skysedge/RUST_Hardware/Bak/091822_Rev1.0_FirstProduction/Mainboard/PanelDesign/RUSPMB_PanelReference.png

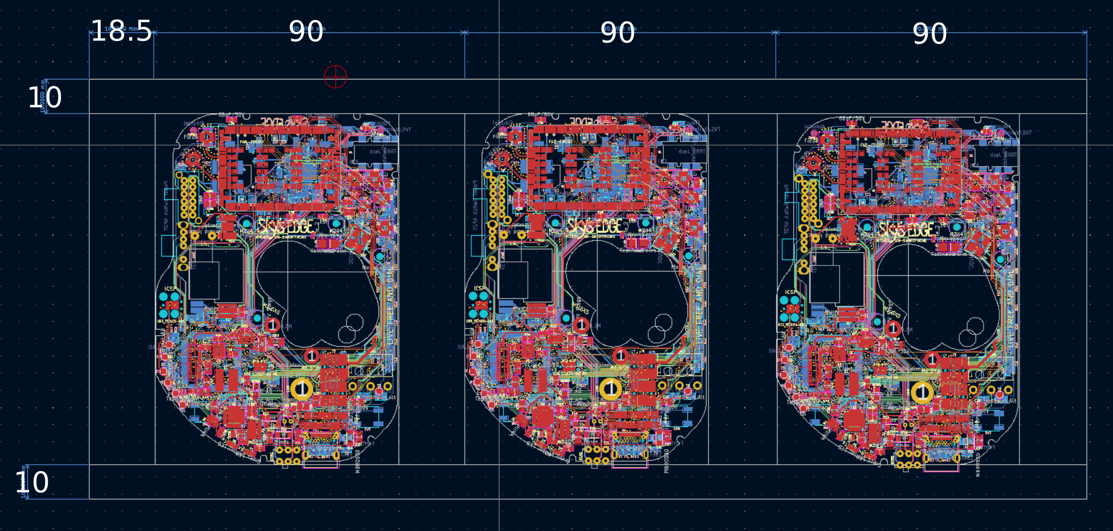
Bak/091822_Rev1.0_FirstProduction/Mainboard/PanelDesign/RUSPMB_PanelReference.png
