skysedge/RUST_Hardware/Bak/091822_Rev1.0_FirstProduction/Mainboard/PanelDesign/Screenshot_2022-08-23_14-57-20.png

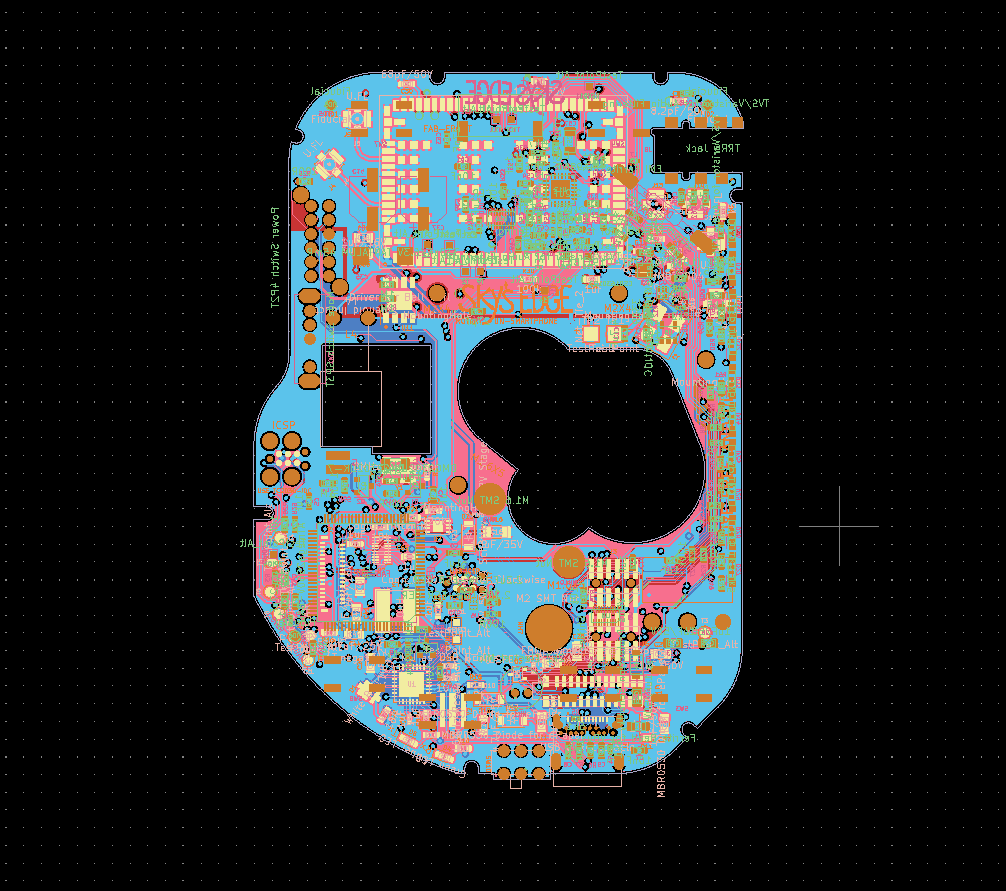
Bak/091822_Rev1.0_FirstProduction/Mainboard/PanelDesign/Screenshot_2022-08-23_14-57-20.png
