skysedge/RUST_Hardware/Bak/081922/BOM_RUSP_Mainboard.ods

Qty | Stock | Description | Ref Des | Manufacturer | Part No. | Cost Each | Cost per ASM | Footprint
5 | 4k | 27pF | C1, C46, C47, C62, C63, |  |  | 0.00886 | 0.0443 | Capacitor_SMD:C_0603_1608Metric
14 | 12k | .1uF | C2, C3, C4, C5, C6, C10, C11, C18, C19, C34, C39, C42, C56, C67 |  |  | 0.00531 | 0.07434 | Capacitor_SMD:C_0603_1608Metric
7 | 10k | 10nF | C7, C48, C49, C60, C61, C68, C69, |  |  | 0.00531 | 0.03717 | Capacitor_SMD:C_0402_1005Metric
2 | 4k | 47pF | C8, C9, |  |  | 0.00802 | 0.01604 | Capacitor_SMD:C_0603_1608Metric
2 | 4k | 4.7uF | C12, C13, |  |  | 0.00989 | 0.01978 | Capacitor_SMD:C_0603_1608Metric
2 | 900 | 100uF, 10V | C14, C37, | Wurth | 865080243007 | 0.16 | 0.32 | MyFootprints:Capacitor_Wurth865080243007
2 | 4k | 2.2uF, LOW-ESR CER. | C15, C50, C54, C72, |  |  | 0.01192 | 0.02384 | Capacitor_SMD:C_0603_1608Metric
3 | 2k | 10uF/35V | C16, C17, C57, |  |  | 0.093 | 0.279 | Resistor_SMD:R_1206_3216Metric
5 | 4k | 4.7uF/25V | C20, C21, C22, C41, C44, |  |  | 0.05128 | 0.2564 | Capacitor_SMD:C_0805_2012Metric
7 | 4k | 1uF/50V | C23, C24, C25, C26, C27, C28, C29, |  |  | 0.03904 | 0.27328 | Capacitor_SMD:C_0805_2012Metric
1 |  | 68pF/50V | C30, |  |  | 0.023 | 0.023 | Capacitor_SMD:C_0402_1005Metric
1 | 4k | 15pF/50V | C31, |  |  | 0.00992 | 0.00992 | Capacitor_SMD:C_0603_1608Metric
1 | 10k | 8.2pF/50V | C32, |  |  | 0.005 | 0.005 | Capacitor_SMD:C_0402_1005Metric
1 | 4k | 10nF/16V | C33, |  |  | 0.00734 | 0.00734 | Capacitor_SMD:C_0603_1608Metric
1 | 249 | 330uF/6.3V, TANTALUM 45mR | C35, | Kemet | T520D337M006ATE045 | 0.933 | 0.933 | MyFootprints:C_2917
3 | 2k | 1uF/16V | C36, C38, C40, |  |  | 0.014 | 0.042 | Capacitor_SMD:C_0805_2012Metric
9 | 10k | 1uF | C43, C45, C51, C52, C53, C55, C58, C59, C66, |  |  | 0.01 | 0.09 | Capacitor_SMD:C_0402_1005Metric
1 | 990 | White Bell LED | D1, | Osram | KW DSLP31.CC-GXHX-4J8K-Z444-60-R18 | 0.18 | 0.18 | MyFootprints:Osram_1212
2 | 999 | Amber LED | D2, D5, | Inolux | IN-S63AT5Y | 0.057 | 0.114 | LED_SMD:LED_0603_1608Metric_Castellated
1 | 5128 from Rochester | VBus Protection Schottky | D3, | ON Semiconductor | MBR130T3G | 0.05 | 0.05 | Diode_SMD:D_SOD-123
1 | 1000 | Green LED | D4, | OSRAM | LT Q39G-Q1OO-25-1 | 0.109 | 0.109 | LED_SMD:LED_0603_1608Metric_Castellated
3 | 4800 | MBR0530 Diode for ePaper | D10, D11, D12, | ON Semi | MBR0530 | 0.08 | 0.24 | Diode_SMD:D_SOD-123
4 | 1000 | TVS/Varistor for Audio Filtering | D15, D16, D17, D18, | AVX | USB0001DP | 0.218 | 0.872 | Resistor_SMD:R_0603_1608Metric
1 | 1000 | Status LED | D22, | Rohm | SMLE13EC8TT86 | 0.251 | 0.251 | LED_SMD:LED_0603_1608Metric_Castellated
1 | 999 | 20V, 500mA Schottky for 12V Stage | D23, | Nexperia | PMEG2005EGWJ | 0.066 | 0.066 | Diode_SMD:D_SOD-123
10 | 10000 | Red/Yellow Bar Meter LED | D25, D26, D27, D28, D29, D30, D31, D32, D33, D34, | Dialight | 5988560207F | 0.145 | 1.45 | MyFootprints:LED_Dialight_5988560207F
1 | 500 | USB C Receptacle | J1, | CUI | UJ31-CH-G1-SMT-TR | 1.577 | 1.577 | MyFootprints:USBC_CUI_UJ31-CH-G1-SMT-TR
1 | 1000 | Poke-In Battery Connector | J2, | AVX | 9296002202906 | 0.28 | 0.28 | MyFootprints:AVX_PokeInConnector
2 | 600 | 12p Male Samtec Connector | J3, J6, | Samtec | FTSH-106-01-L-DV | 1.442 | 2.884 | MyFootprints:Samtec_2x6Header_FTSH-106-01-L-DV
6 | 4500 | U.FL | J4, J5, J13, J14, J15, J16, | Molex | 734120110 | 0.338 | 2.028 | Connector_Coaxial:U.FL_Molex_MCRF_73412-0110_Vertical
1 | 600 | TRRS Jack | J8, | CUI | SJ-43617-SMT-TR | 1.105 | 1.105 | MyFootprints:AudioJack_TRRS_CUI_SJ-43617-SMT-TR
1 | 400 | FPC Connector for OLED | J9, | Crystalfontz | CS030Z31G-A0 | 0.59 | 0.59 | MyFootprints:Hirose_FPC_FH26W-31S-0.3SHW(60)
1 | 500 | FPC Connector for ePaper | J10, | Molex | 525592452 | 2.045 | 2.045 | MyFootprints:Molex_24pFPC_Vert_0525592452
2 | 0 | SMD Pin Socket for Filament | J11, J12, | Samtec | SMM-102-02-S-S | 0 | 0 | MyFootprints:2pSocket_SMD_Samtec_SMM-102-02-S-S
1 | 800 | Socket Header for Ringer Coil | J18, | GCT | BG302-03-A-L-G | 0.292 | 0.292 | MyFootprints:3pSocket_RA_GCT_BG302-03-A-L-G
1 | 4000 | Ferrite Bead for VBus | L1, | Laird | MI0805K601R-10 | 0.055 | 0.055 | Resistor_SMD:R_0805_2012Metric_Pad1.15x1.40mm_HandSolder
1 | 180 | 4.7uH | L2, | Wurth | 74438336047 | 1.275 | 1.275 | MyFootprints:Inductor_Wurth_74438336100
1 | 800 | 10uH | L3, | Wurth | 744053100 | 1.258 | 1.258 | MyFootprints:Inductor10uH_Wurth_744053100
4 | 4000 | EMI Ferrite | L5, L6, L7, L8, | Murata | BLM15HD182SN1D | 0.046 | 0.184 | Inductor_SMD:L_0402_1005Metric
1 | 3000 | M2 SMT Nut | MH7, | PEM | SMTSO-M2-3ET | 0.51 | 0.51 | MyFootprints:SMTSO-M2-3ET
2 | 3257 | M1.6 SMT Nut | MH9, MH10, | PEM | SMTSO-M1.6-1ET | 0.46 | 0.92 | MyFootprints:SMTSO-M1.6-1ET
1 | 500 | 2k2 Electret Mic | MK1, | PUI Audio | POM-2738P-R | 1.22 | 1.22 | MyFootprints:Microphone_PUI_POM-2738P-R
2 | 2000 | DMG2302UK-7 | Q1, Q2, | Diodes Incorporated | DMG2302UK-7 | 0.13 | 0.26 | Package_TO_SOT_SMD:SOT-23
2 | 2000 | CSD16301Q2 | Q3, Q4, | TI | CSD16301Q2 | 0.35 | 0.7 | digikey-footprints:TI_CSD16301Q2
1 | 3000 from Newark, due 7/22 | N-MOSFET, 30V, 1.4A | Q5, | Vishay | SI1308EDL-T1-GE3 | 0.149 | 0.149 | Package_TO_SOT_SMD:SOT-323_SC-70
2 | 750 | MMBT3904 | Q6, Q7, | Fairchild | MMBT3904 | 0.07 | 0.14 | Package_TO_SOT_SMD:SOT-23
7 | 10k | 10k | R1, R18, R29, R33, R39, R75, R76, |  |  | 0.00312 | 0.02184 | Resistor_SMD:R_0603_1608Metric
6 | 10k | 1M | R2, R23, R24, R34, R41, R73, |  |  | 0.00312 | 0.01872 | Resistor_SMD:R_0603_1608Metric
3 | 5k | 27R | R3, R6, R7, |  |  | 0.00312 | 0.00936 | Resistor_SMD:R_0603_1608Metric
2 | 10k | 5k1 | R4, R5, | Yageo | RC0402FR-075K1L | 0.00186 | 0.00372 | Resistor_SMD:R_0402_1005Metric
7 | 10k | 1k | R8, R9, R10, R11, R74, R77, R78, |  |  | 0.003 | 0.021 | Resistor_SMD:R_0603_1608Metric
1 | 5k | 330R | R12, |  |  | 0.003 | 0.003 | Resistor_SMD:R_0603_1608Metric
4 | 10k | 2k2 | R13, R14, R35, R38, | Panasonic | ERJ-2GEJ222X | 0.00152 | 0.00608 | Resistor_SMD:R_0402_1005Metric
1 | 5k | 10R | R15, | Panasonic | ERJ-3GEYJ100V | 0.002 | 0.002 | Resistor_SMD:R_0603_1608Metric
1 | 5k | 510k | R16, |  |  | 0.003 | 0.003 | Resistor_SMD:R_0603_1608Metric
21 | 25k | 1k5 | R17, R45, R46, R47, R48, R49, R50, R51, R52, R53, R54, R55, R56, R57, R58, R59, R60, R61, R62, R63, R64, |  |  | 0.002 | 0.042 | Resistor_SMD:R_0603_1608Metric
4 | 5k | 100R | R19, R20, R40, R65, |  |  | 0.004 | 0.016 | Resistor_SMD:R_0603_1608Metric
1 | 5k | 1.05M | R21, |  |  | 0.0028 | 0.0028 | Resistor_SMD:R_0603_1608Metric
1 | 5k | 120k | R22, |  |  | 0.002 | 0.002 | Resistor_SMD:R_0603_1608Metric
5 | 10k | 270R | R25, R42, R66, R68, R70, |  |  | 0.002 | 0.01 | Resistor_SMD:R_0603_1608Metric
3 | 5k | 100k | R26, R27, R30, |  |  | 0.00312 | 0.00936 | Resistor_SMD:R_0603_1608Metric
5 | 10k | 820R | R28, R43, R67, R69, R71, |  |  | 0.00312 | 0.0156 | Resistor_SMD:R_0603_1608Metric
1 | 4k | 16k | R31, |  |  | 0.003 | 0.003 | Resistor_SMD:R_0603_1608Metric
1 | 5k | 0.47R | R32, | Panasonic | ERJ-2BQJR47X | 0.024 | 0.024 | Resistor_SMD:R_0402_1005Metric
2 | 5k | 4k7 | R36, R37, |  |  | 0.00312 | 0.00624 | Resistor_SMD:R_0603_1608Metric
1 | 5k M | 160R* | R44, |  |  | 0.003 | 0.003 | Resistor_SMD:R_0603_1608Metric
1 | 4k | 18R | R79, | TE | CRGCQ0603F18R | 0.003 | 0.003 | Resistor_SMD:R_0603_1608Metric
1 | 1050 | Mode Switch, SP3T | SW1, | C&K | OS103011MA7QP1 | 0.37 | 0.37 | MyFootprints:SP3T_OS103011MA7QP1
1 | 442 | Roller Switch for Rotary Dial | SW2, | Omron | D2F-01FL2-A1 | 1.531 | 1.531 | MyFootprints:LimitSwitch_D2F-01FL2-A1
6 | 1000 (+2k on order from DigiKey) | Tactile Switch | SW3, SW4, SW5, SW6, SW7, SW8, | Panasonic | EVQ-Q2Y03W | 0.169 | 1.014 | MyFootprints:TactileSwitch_Panasonic_EVQ-Q2Y03W
1 | 800 | Power Switch, 4P2T | SW9, | E-Switch | EG4208 | 0.75 | 0.75 | MyFootprints:Switch_4PDT_ESwitch-EG4208
1 | 1300 | Mic Switch, DPDT | SW10, | Nidec Copal | CL-SB-22C-11 | 0.818 | 0.818 | MyFootprints:Switch_DPDT_Nidec_CL-SB-22C-XX
1 | 200 | ATmega16U2-MU as USB Bridge | U1, | Atmega | ATmega16U2-MU | 2.634 | 2.634 | Package_DFN_QFN:QFN-32-1EP_5x5mm_P0.5mm_EP3.65x3.65mm
1 | 499 | LiPo Undervolt Protection IC | U3, | TI | BQ29703DSET | 0.57 | 0.57 | Package_SON:WSON-6_1.5x1.5mm_P0.5mm
1 | 96 + 200 Atmega1280V, + 300 ATmega1280V on order from Rochester | ATmega2560V-8AU | U4, | Microchip Technology | ATMEGA2560V-8AUR | 11 | 11 | MyFootprints:ATmega2560_TQFP-100_14x14mm_P0.5mm
1 | ?+230 | Charge Mgmt. IC | U5, | Microchip | MCP73831T-2ACI/OT | 0.63 | 0.63 | Package_TO_SOT_SMD:SOT-23-5
1 | 2049 | 3.3V Linear Regulator | U6, | Microchip | MIC5528-3.3YMT-TR | 0.18 | 0.18 | MyFootprints:LDO_MIC5528
1 | 1500 | 12V Boost Converter | U7, | Microchip | MCP1661T-E/MNY | 0.89 | 0.89 | MyFootprints:BoostConverter_MCP1661
2 | 1000 | Logic Shifter | U8, U10, | TI | TXB0108DQSR | 1.6 | 3.2 | MyFootprints:TXB0108_USON-20_2x4mm_P0.4mm
1 | 200 of R202 | TOBY-R2 | U9, | u-blox | TOBY-R200 | 57.5 | 57.5 | MyFootprints:CellModule_TOBY-L2
1 | 1000 | Driver for Bell Coil | U11, | Diodes Inc. | ZXBM5210-SP-13 | 0 | 0 | MyFootprints:SO-8EP
1 | 2000 | MAX9860 CODEC | U12, | Maxim | MAX9860ETG+ | 1.62 | 1.62 | Package_DFN_QFN:WQFN-24-1EP_4x4mm_P0.5mm_EP2.7x2.7mm
1 | 1000 | 8MHz Resonator | Y1, | Abracon | AWSCR-8.00CV-T | 0.22 | 0.22 | MyFootprints:AWSCR-16.00CV-T
1 | 1000 | 16MHz Resonator | Y2, |  | AWSCR-16.00CV-T | 0.189 | 0.189 | MyFootprints:AWSCR-16.00CV-T
 |  |  |  |  |  | TOTAL: | 106.55583
