skysedge/RUST_Hardware/Bak/Nov10_2022/Antenna/BOM_RUSP_Antenna.ods

Qty | Stock | Description | Ref Des | Manufacturer | Part No. | Cost Each | Cost per ASM | Footprint
1 | 1070 | Antenna | AE1, | Ignion | NN02-224 (RUN mXtend) | 2.49135 | 2.49135 | MyFootprints:Antenna_Ignion_RunmXtend_NN02-224
1 |  | 0.7pF | C1, | Murata |  | 0 | 0 | Capacitor_SMD:C_0603_1608Metric
1 | 0 | 0.6pF | C2, | Murata |  | 0 | 0 | Capacitor_SMD:C_0603_1608Metric
1 | 0 | 1.5pF | C3, | Murata |  | 0 | 0 | Capacitor_SMD:C_0603_1608Metric
1 | 0 | u.FL | J1, | Molex | 734120110 | 0 | 0 | Connector_Coaxial:U.FL_Molex_MCRF_73412-0110_Vertical
1 | 0 | 19nH | L1, | Murata |  | 0 | 0 | Inductor_SMD:L_0603_1608Metric
1 | 0 | 4nH | L2, | Murata |  | 0 | 0 | Inductor_SMD:L_0402_1005Metric
1 | 0 | 12nH | L3, | Murata |  | 0 | 0 | Inductor_SMD:L_0603_1608Metric
1 | 0 | 4.5nH | L4, | Murata | LQW15AN4N0C10D | 0 | 0 | Inductor_SMD:L_0402_1005Metric
 |  |  |  |  |  | TOTAL: | 2.49135
