skysedge/RUST_Hardware/Bak/091822_Rev1.0_FirstProduction/Faceplate/RUSP_Faceplate.csv

Qty | Stock | Description | Ref Des | Manufacturer | Part No. | Cost Each | Cost per ASM | Footprint
4 | 0 | M2 SMT Nut | H1, H2, H3, H5, | PEM | SMTSO-M2-3ET | 0 | =A2*G2 | MyFootprints:SMTSO-M2-3ET
 |  |  |  |  |  | TOTAL: | =SUM(H3:H2)
