skysedge/RUST_Hardware/Daughterboard/ManufacturerNotes/1000001908.jpg

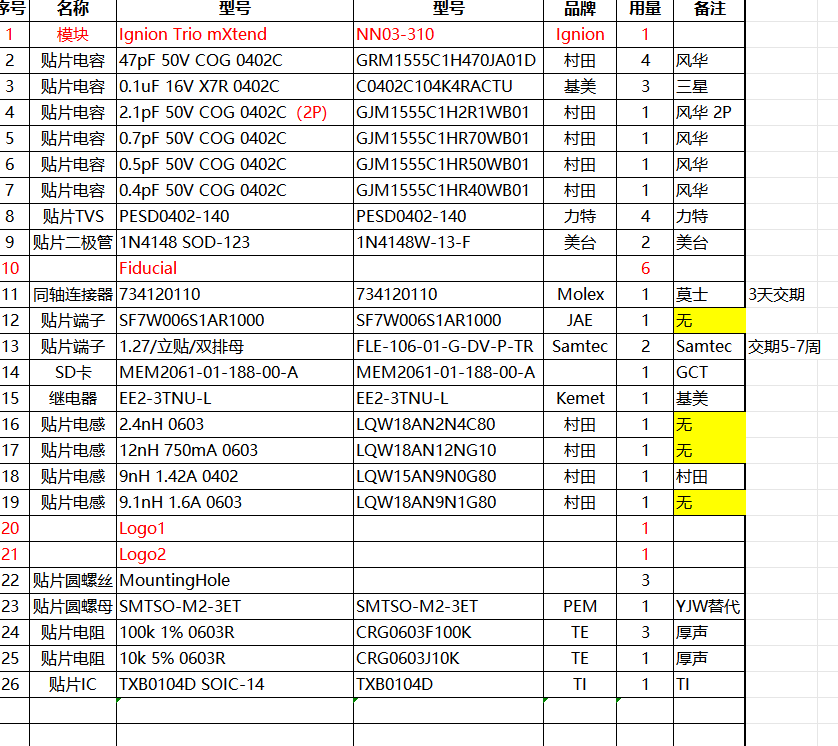
Daughterboard/ManufacturerNotes/1000001908.jpg
