skysedge/RUST_Hardware/(threads)

Thread 4 (2025-03-14):

Phase 2: Find new TP locations

jhaupt, 2025-03-14:
For phase 2, move the test points so that the phone can be tested on the PQC fixture even after fully assembled. Potentially, even with the casing on if the test points are accessible under a hatch?
