skysedge/RUST_Hardware/Bak/Nov10_2022/Mainboard/Fab/RUSP_Mainboard-AUDIO.pdf

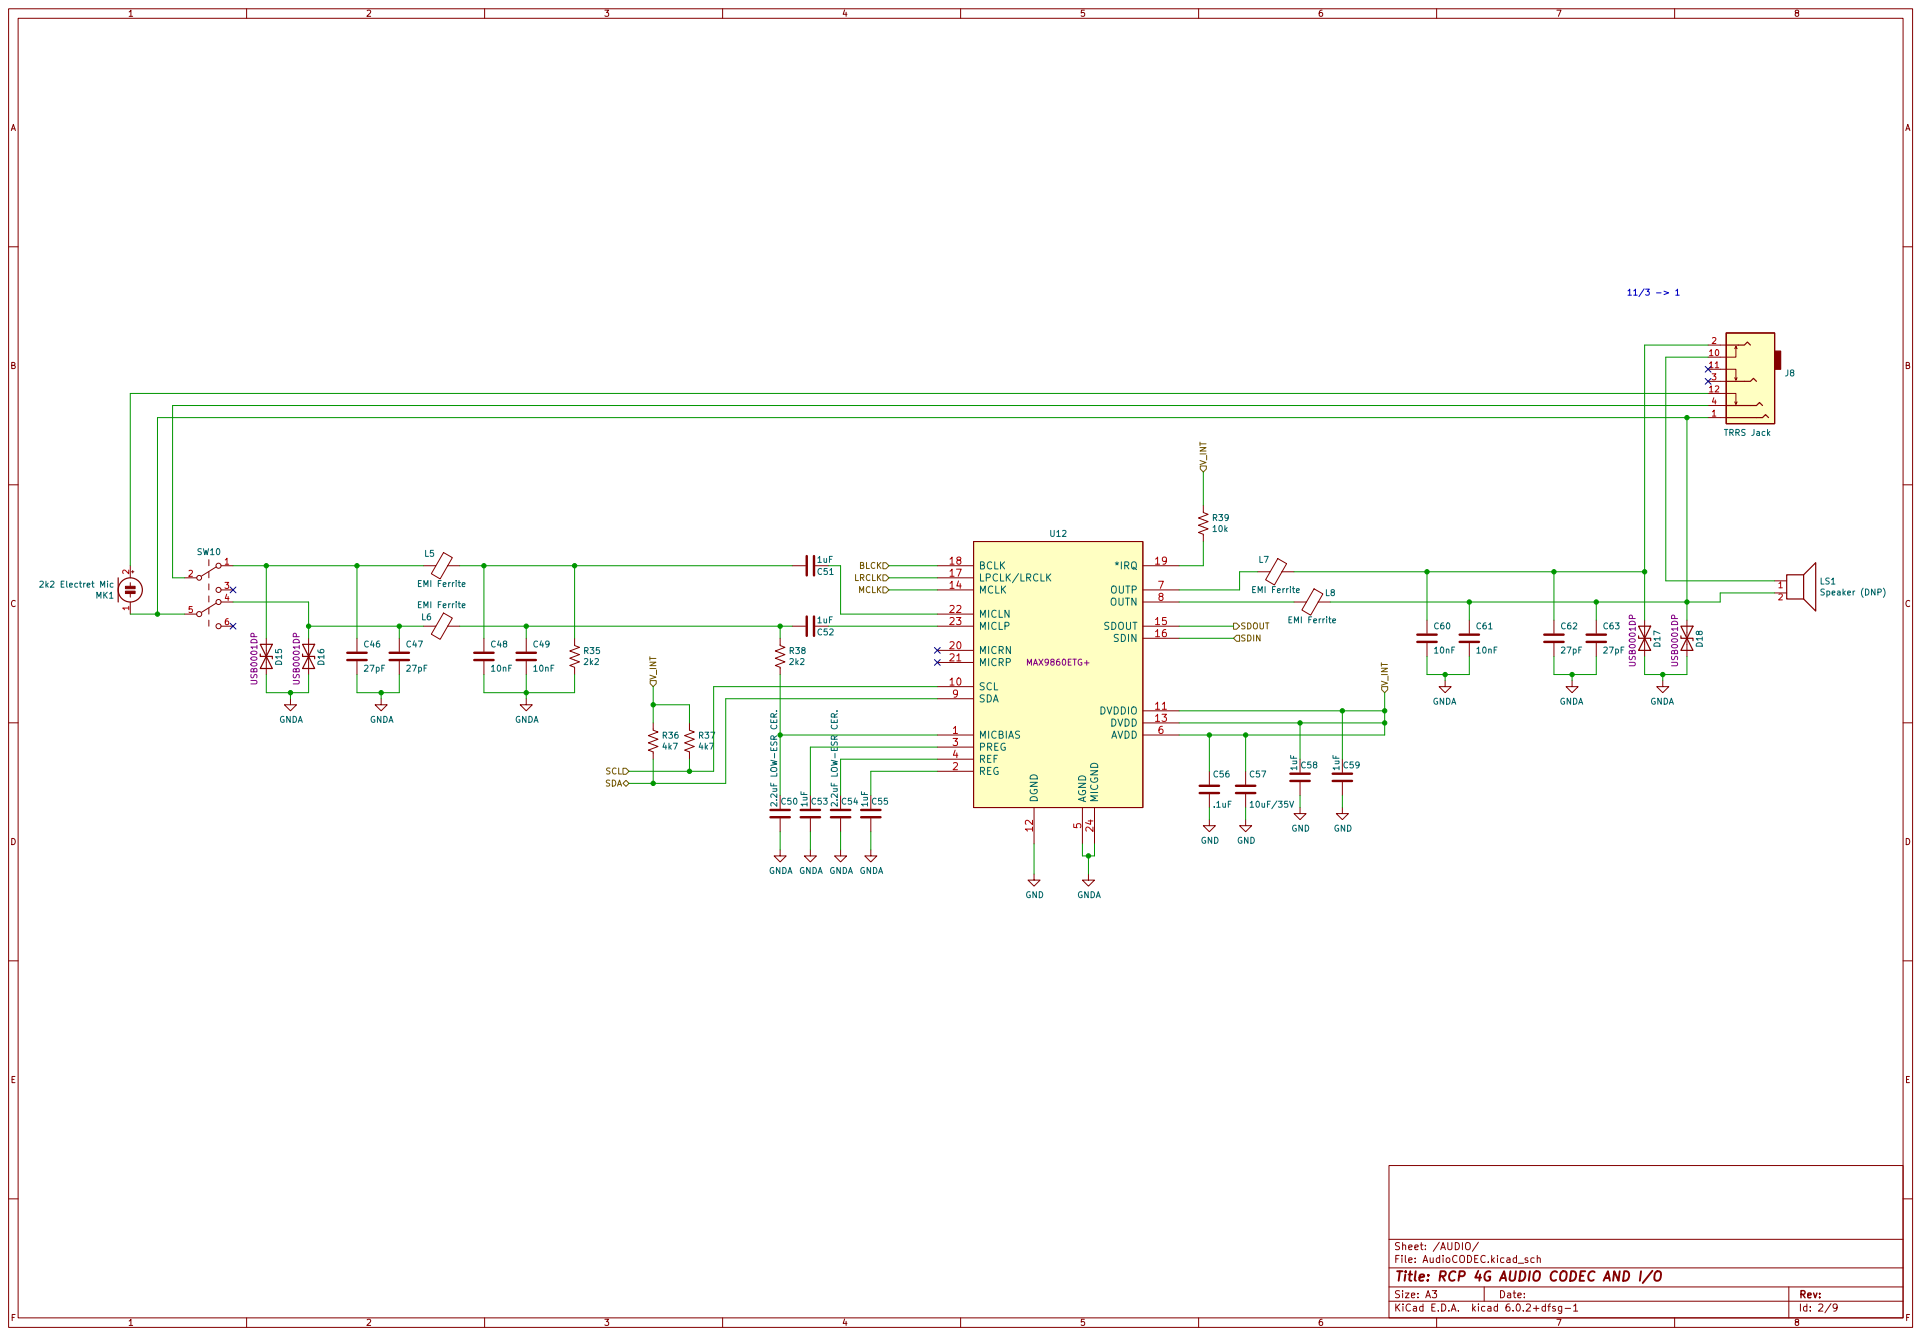
[picture p4: page 1]

5 AVDD 6 OUTP 7 OUTN 8 SDA 9 U12 MAX9860ETG+

File: AudioCODEC.kicad_sch Sheet: /AUDIO/ D16 USB0001DP

Id: 2/9 Title: RCP 4G AUDIO CODEC AND I/O
