skysedge/RUST_Hardware/Daughterboard/RUST_Daughterboard.kicad_pcb

## KiCad design Daughterboard/RUST_Daughterboard.kicad_pcb (2025-03-16)

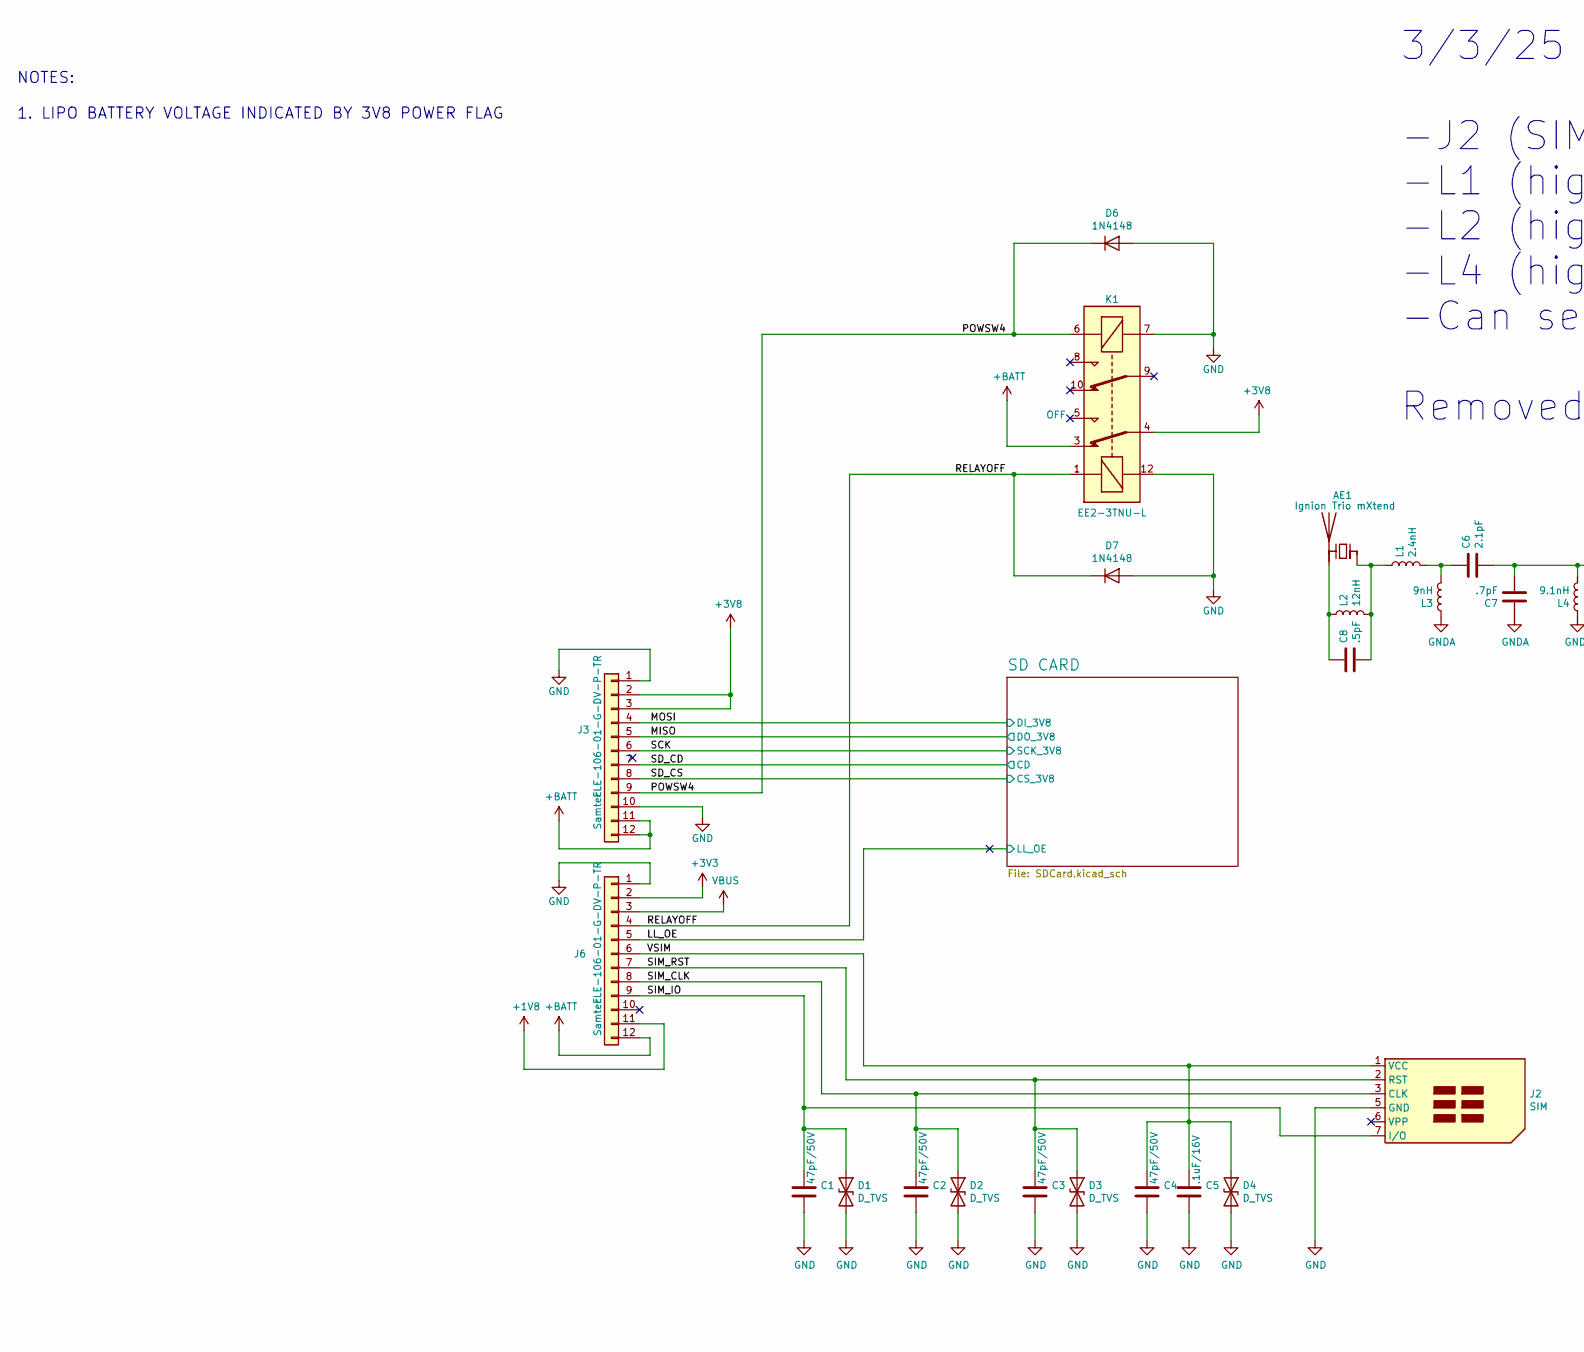
[picture p15: schematic RUST_Daughterboard.kicad_sch, 4G ROTARY CELLPHONE DAUGHTERBOARD, part in row 1, column 1]

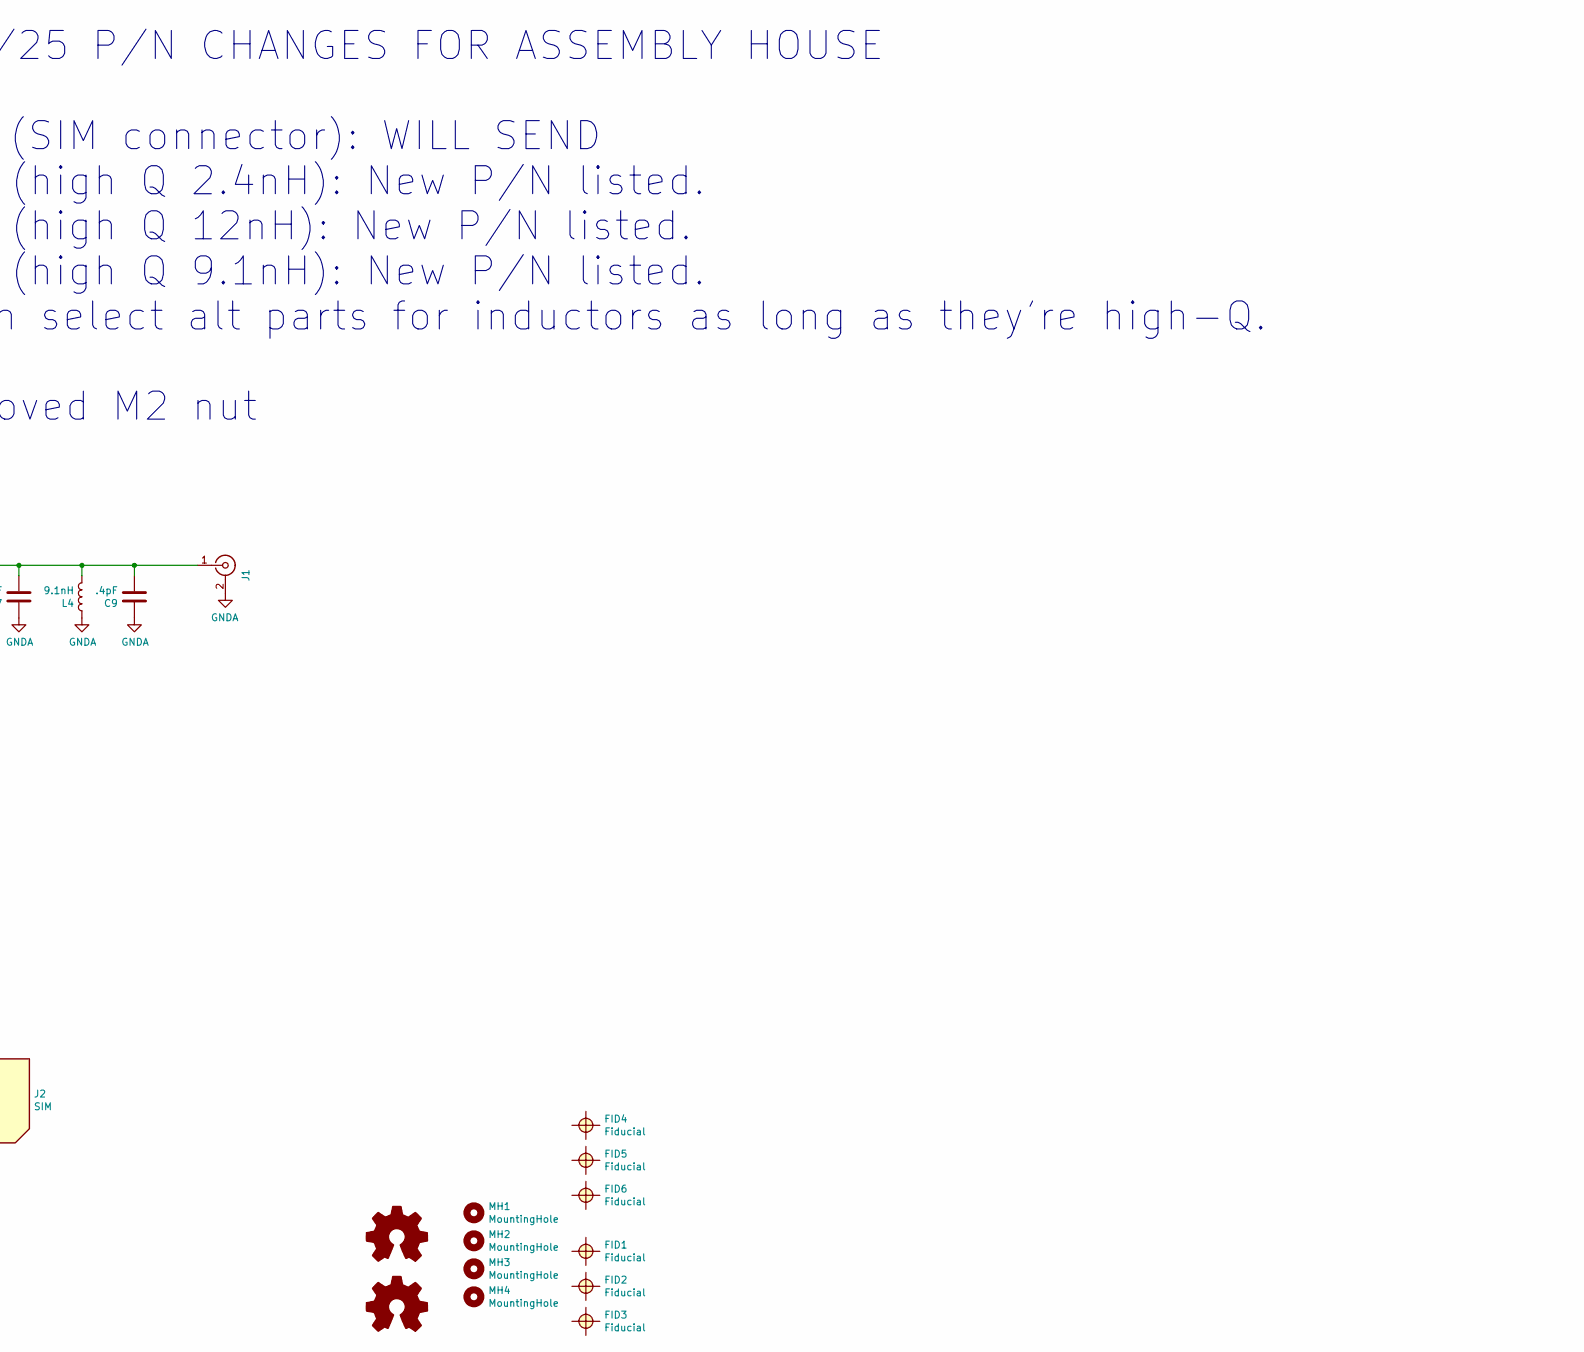
[picture p16: schematic RUST_Daughterboard.kicad_sch, 4G ROTARY CELLPHONE DAUGHTERBOARD, part in row 1, column 2]

Parts:
AE1: Ignion Trio mXtend; Antenna_Ignion_TriomXtend_NN03-310; Mfg. Part No. NN03-310
C1, C2, C3, C4: 47pF/50V; C_0603_1608Metric; Mfg. Part No. GRM1555C1H470JA01D
C5: .1uF/16V; C_0603_1608Metric; Mfg. Part No. C0402C104K4RACTU
C6: 2.1pF; C_0402_1005Metric; Mfg. Part No. GJM1555C1H2R1BB01D
C7: .7pF; C_0402_1005Metric; Mfg. Part No. GJM1555C1HR70BB01D
C8: .5pF; C_0402_1005Metric; Mfg. Part No. 0402N8R2D500CT
C9: .4pF; C_0402_1005Metric; Mfg. Part No. GJM1555C1HR40WB01D
D1, D2, D3, D4: D_TVS; D_0603_1608Metric; Mfg. Part No. PESD0402-140
D6, D7: 1N4148; D_SOD-123; Mfg. Part No. 1N4148W-13-F
FID1, FID2, FID3, FID4, FID5, FID6: Fiducial; Fiducial_0.75mm_Dia_1.5mm_Outer
J1: Conn_Coaxial; U.FL_Molex_MCRF_73412-0110_Vertical; Mfg. Part No. 0734120110
J2: SIM; SIMHolder_Amph7111S2015X02LF; Mfg. Part No. SF7W006S1AR1000
J3, J6: Conn_01x12; Samtec_2x6HeaderSocket_FLE-106-01-G-DV; Mfg. Part No. FLE-106-01-G-DV-P-TR
K1: EE2-3TNU-L; Relay_Kemet_EE2-3TNU; Mfg. Part No. EE2-3TNU
L1: 2.4nH; L_0603_1608Metric; Mfg. Part No. 2-2176075-4
L2: 12nH; L_0603_1608Metric; Mfg. Part No. LQW18AN12NG00D
L3: 9nH; L_0402_1005Metric; Mfg. Part No. LQW15AN9N0G80
L4: 9.1nH; L_0603_1608Metric; Mfg. Part No. LQW18AN9N1C00D
LOGO1: Logo1; SkysEdge_18mm
LOGO2: Logo2; SkysEdge_18mm
MH1, MH2, MH3, MH4: MountingHole; MountingHole_2.2mm_M2

Connections:
+1V8: J6.11
+3V3: J6.2; also elsewhere on the board
+3V8: J3.2, J3.3, K1.4; also elsewhere on the board
+BATT: J3.11, J3.12, J6.12, K1.3
/LL_OE: J6.5; also elsewhere on the board
/MISO: J3.5; also elsewhere on the board
/MOSI: J3.4; also elsewhere on the board
/POWSW4: D6.1 (K), J3.9, K1.6
/RELAYOFF: D7.1 (K), J6.4, K1.1
/SCK: J3.6; also elsewhere on the board
/SD_CD: J3.7; also elsewhere on the board
/SD_CS: J3.8; also elsewhere on the board
/SIM_CLK: C2.1, D2.1 (A1), J2.3 (CLK), J6.8
/SIM_IO: C1.1, D1.1 (A1), J2.7 (I/O), J6.9
/SIM_RST: C3.1, D3.1 (A1), J2.2 (RST), J6.7
/VSIM: C4.1, C5.1, D4.1 (A1), J2.1 (VCC), J6.6
GND: C1.2, C2.2, C3.2, C4.2, C5.2, D1.2 (A2), D2.2 (A2), D3.2 (A2), D4.2 (A2), D6.2 (A), D7.2 (A), J2.5 (GND), J3.1, J3.10, J6.1, K1.7, K1.12; also elsewhere on the board
GNDA: C7.1, C9.1, J1.2 (Ext), L3.1, L4.1
unnamed: AE1.1 (FEED), C8.2, L1.1, L2.2
unnamed: AE1.2 (PCB_Trace), C8.1, L2.1
unnamed: C6.1, L1.2, L3.2
unnamed: C6.2, C7.2, C9.2, J1.1 (In), L4.2
VBUS: J6.3

Notes on the sheet:
3/3/25 P/N CHANGES FOR ASSEMBLY HOUSE -J2 (SIM connector): WILL SEND -L1 (high Q 2.4nH): New P/N listed. -L2 (high Q 12nH): New P/N listed. -L4 (high Q 9.1nH): New P/N listed. -Can select alt parts for inductors as long as they're high-Q. Removed M2 nut
NOTES: 1. LIPO BATTERY VOLTAGE INDICATED BY 3V8 POWER FLAG

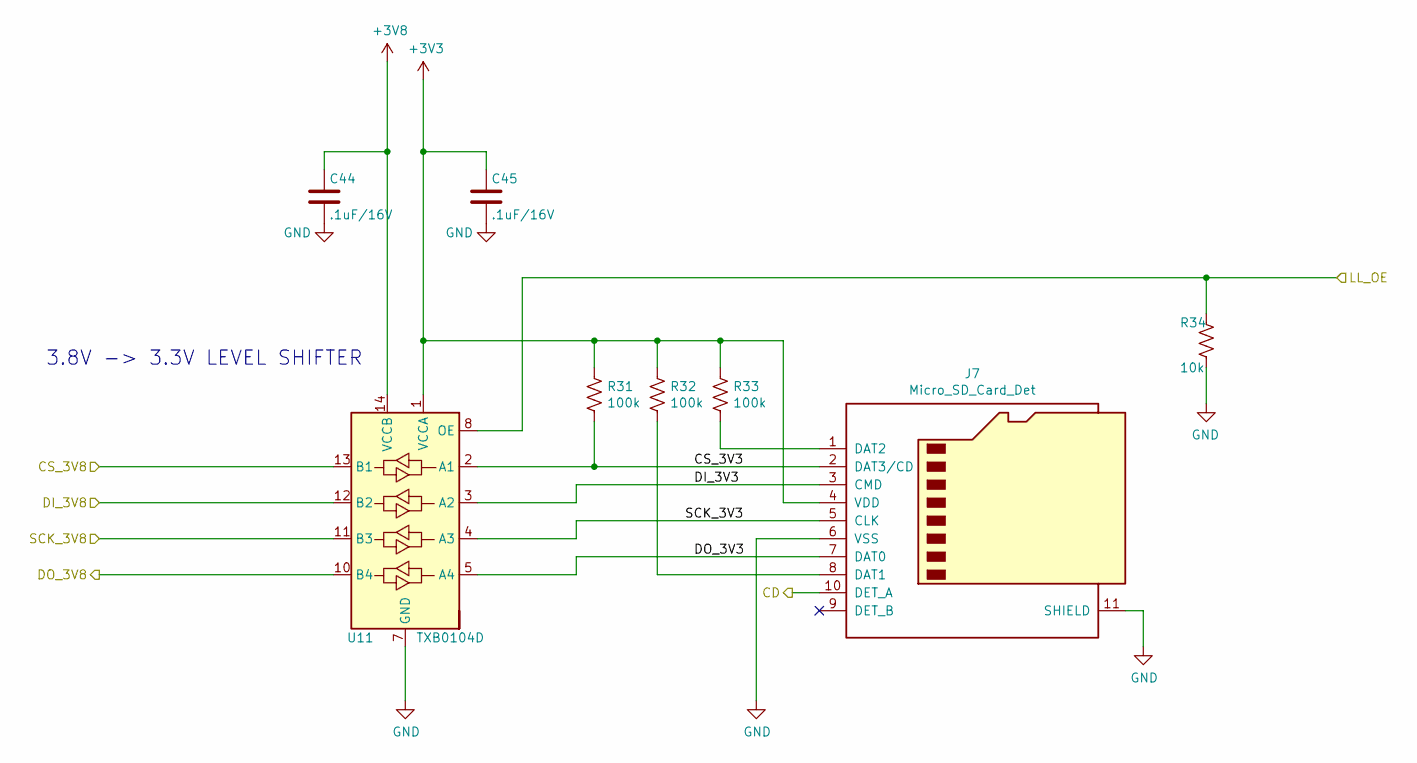
[picture p17: schematic SDCard.kicad_sch, RCP SD CARD INTERFACE]

Parts:
C44, C45: .1uF/16V; C_0603_1608Metric; Mfg. Part No. C0402C104K4RACTU
J7: Micro_SD_Card_Det; MicroSDSocket_GCT_MEM2061-01-188-00-A; Mfg. Part No. MEM2061-01-188-00-A
R31, R32, R33: 100k; R_0603_1608Metric; Mfg. Part No. CRG0603F100K
R34: 10k; R_0603_1608Metric; Mfg. Part No. CRG0603J10K
U11: TXB0104D; SOIC-14_3.9x8.7mm_P1.27mm; Mfg. Part No. TXB0104D

Connections:
+3V3: C45.1, J7.4 (VDD), R31.1, R32.1, R33.1, U11.1 (VCCA); also elsewhere on the board
+3V8: C44.1, U11.14 (VCCB); also elsewhere on the board
/LL_OE: R34.1, U11.8 (OE); also elsewhere on the board
/MISO: U11.10 (B4); also elsewhere on the board
/MOSI: U11.12 (B2); also elsewhere on the board
/SCK: U11.11 (B3); also elsewhere on the board
/SD CARD/CS_3V3: J7.2 (DAT3/CD), R31.2, U11.2 (A1)
/SD CARD/DI_3V3: J7.3 (CMD), U11.3 (A2)
/SD CARD/DO_3V3: J7.7 (DAT0), U11.5 (A4)
/SD CARD/SCK_3V3: J7.5 (CLK), U11.4 (A3)
/SD_CD: J7.10 (DET_A); also elsewhere on the board
/SD_CS: U11.13 (B1); also elsewhere on the board
GND: C44.2, C45.2, J7.6 (VSS), J7.11 (SHIELD), R34.2, U11.7 (GND); also elsewhere on the board
unnamed: J7.8 (DAT1), R32.2
unnamed: J7.1 (DAT2), R33.2

Notes on the sheet:
3.8V -> 3.3V LEVEL SHIFTER

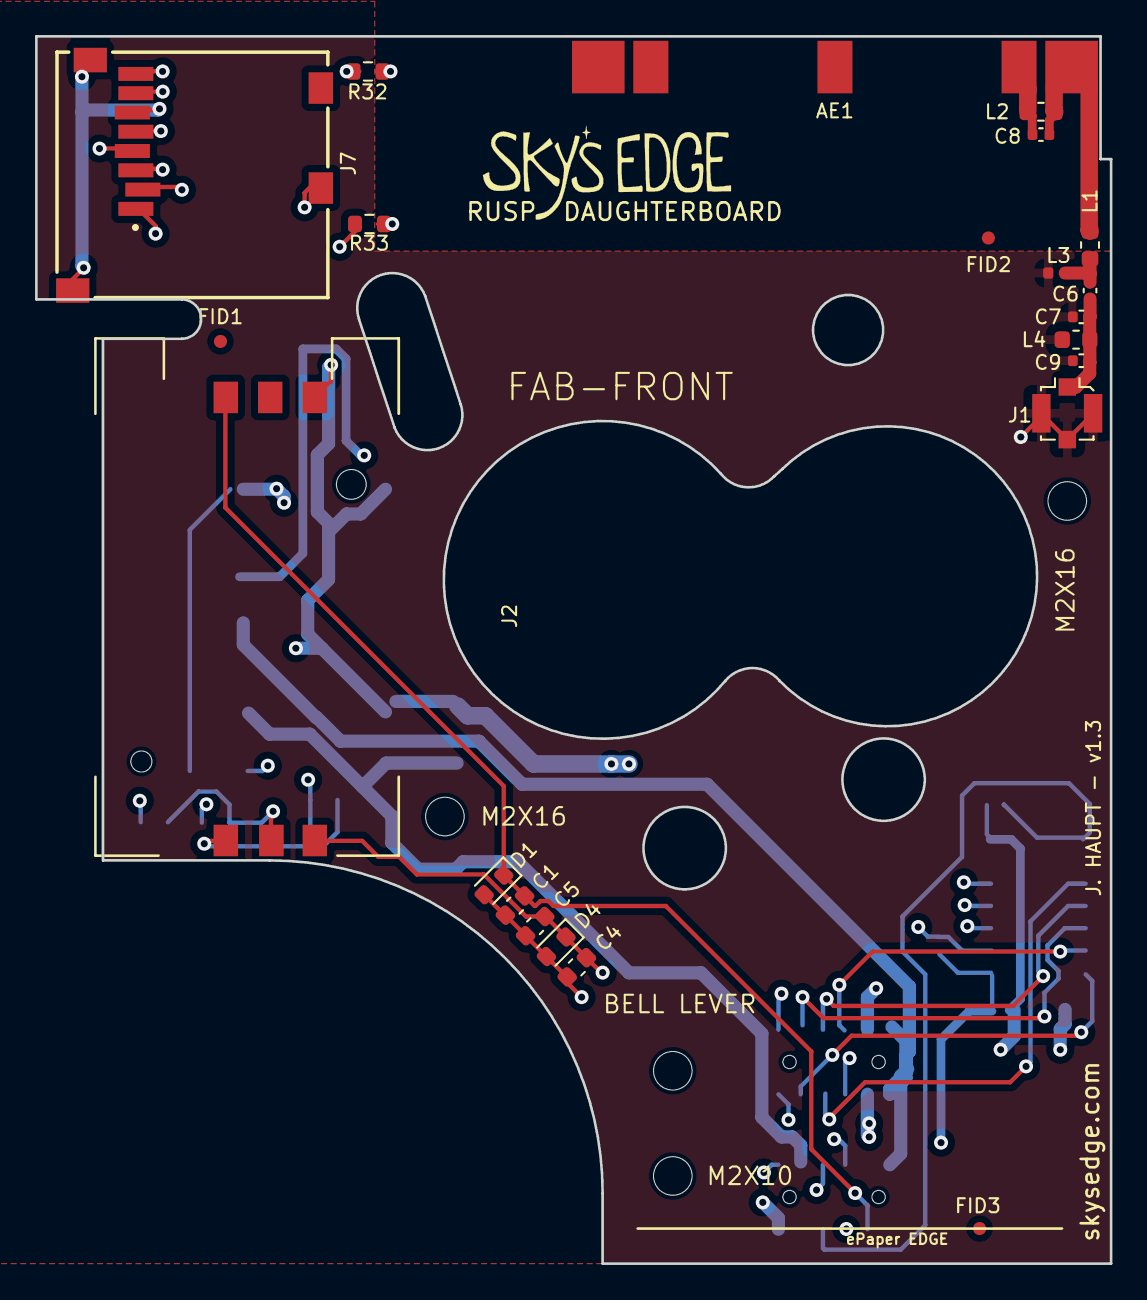
[picture p18: board RUST_Daughterboard.kicad_pcb from above]

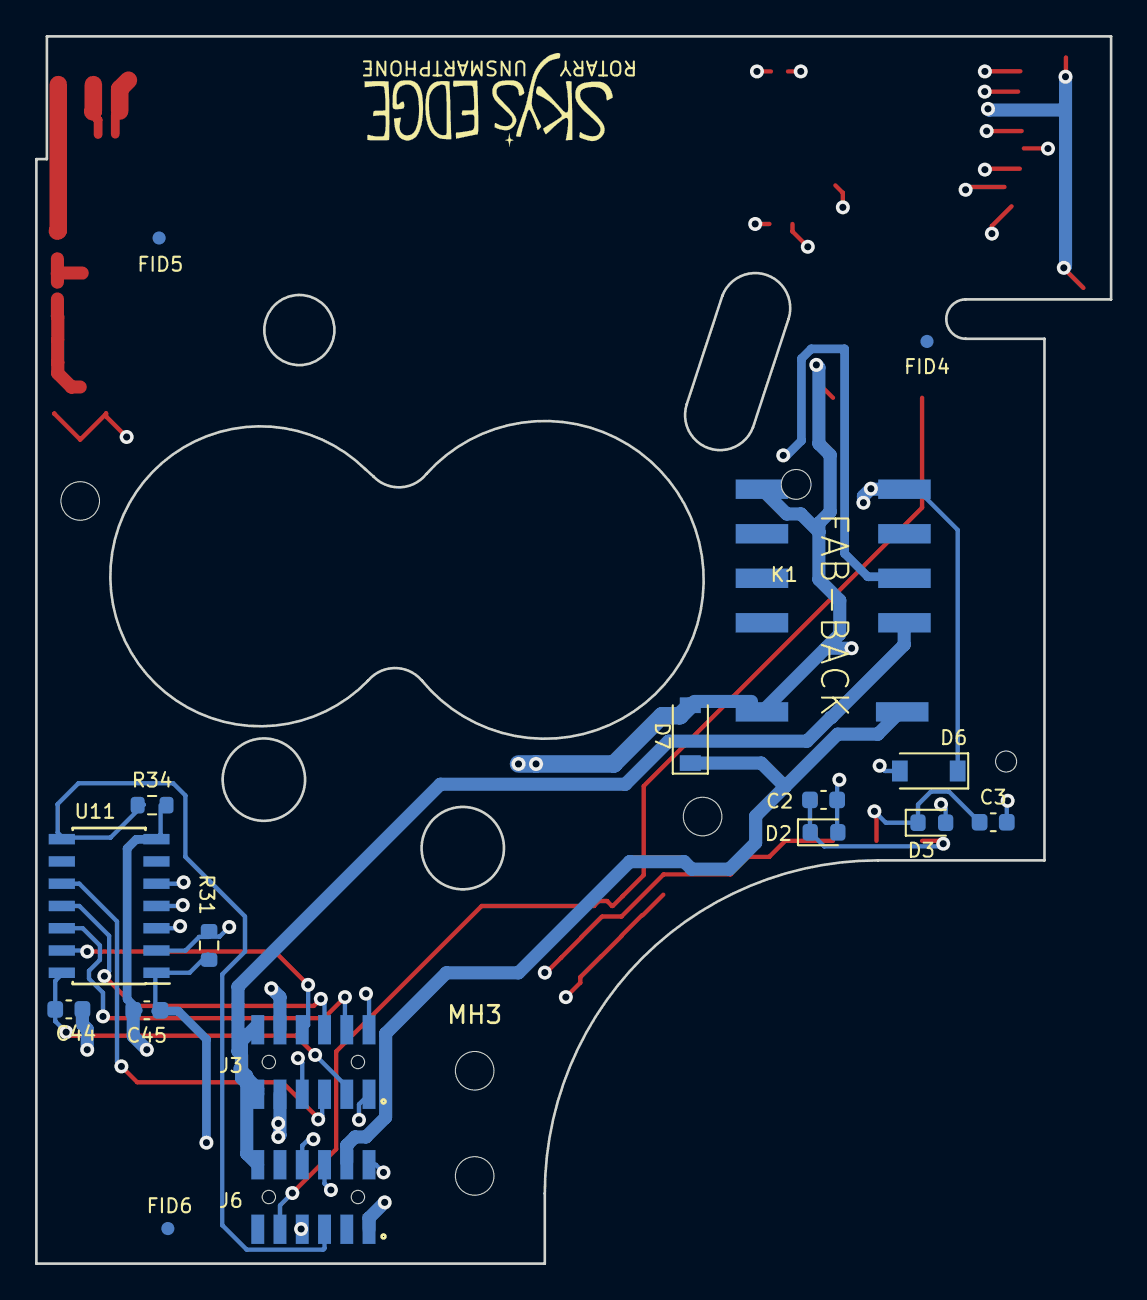
[picture p19: board RUST_Daughterboard.kicad_pcb from below]

Board: 4 copper layers, 61.3 x 70.0 mm, 45 parts (19 on the bottom side), 27 nets.
