skysedge/RUST_Hardware/Dialboard/RUST_Dialboard.kicad_pcb

## KiCad design Dialboard/RUST_Dialboard.kicad_pcb (2025-03-16)

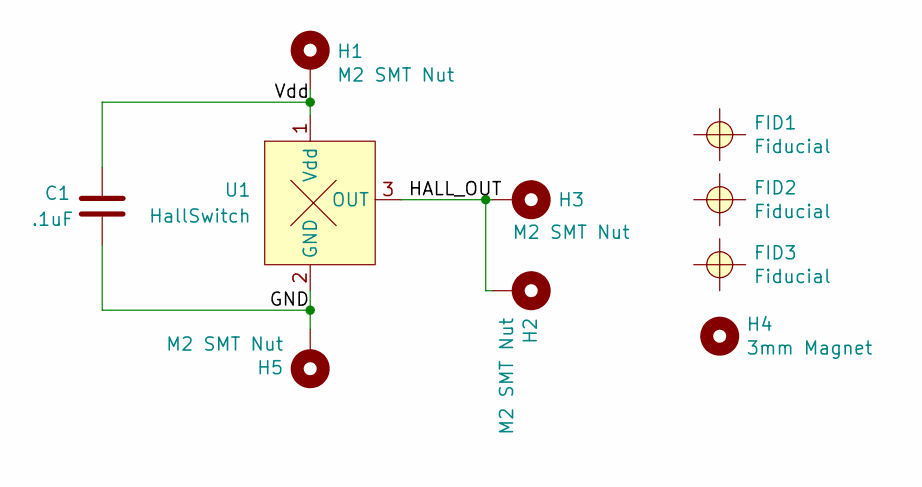
[picture p20: schematic RUST_Dialboard.kicad_sch]

Parts:
C1: .1uF; C_0603_1608Metric; Mfg. Part No. 0603B104K250CT
FID1, FID2, FID3: Fiducial; Fiducial_0.75mm_Dia_1.5mm_Outer
H1, H2, H3, H5: M2 SMT Nut; SMTSO-M2-3ET; Mfg. Part No. SMTSO-M2-3ET
H4: 3mm Magnet; 3mmMagnetHole; Mfg. Part No. N42P120060
U1: HallSwitch; SC-59; Mfg. Part No. AH1806-W-7

Connections:
/GND: C1.2, H5.1, U1.2 (GND)
/HALL_OUT: H2.1, H3.1, U1.3 (OUT)
/Vdd: C1.1, H1.1, U1.1 (Vdd)

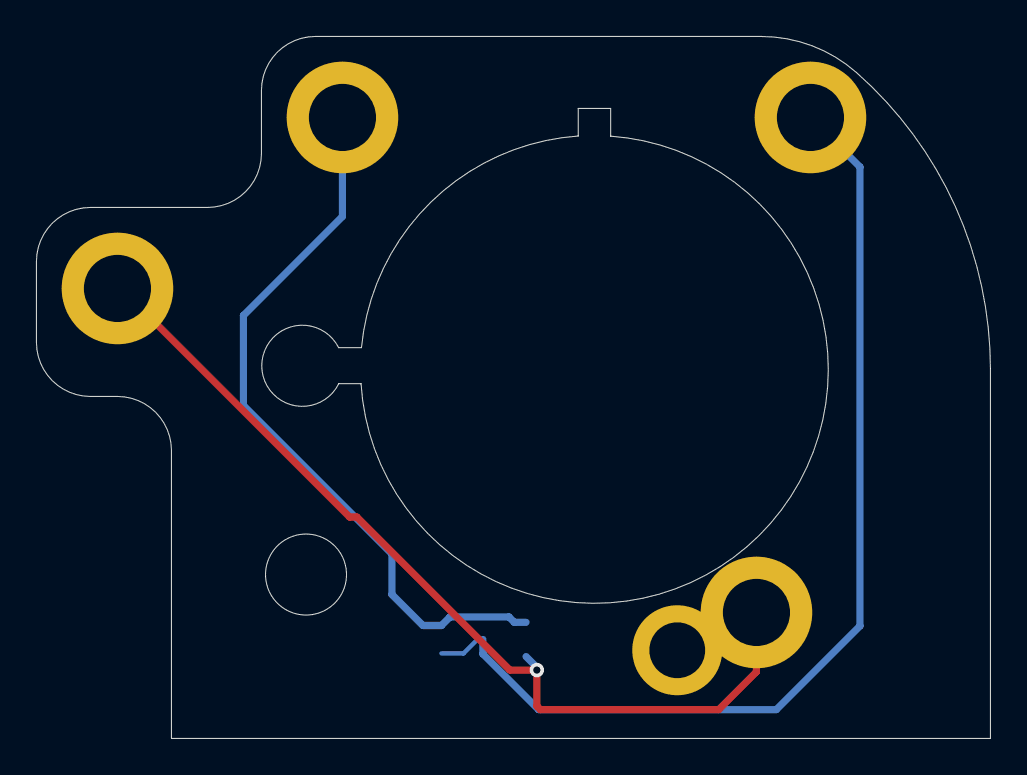
[picture p21: board RUST_Dialboard.kicad_pcb from above]

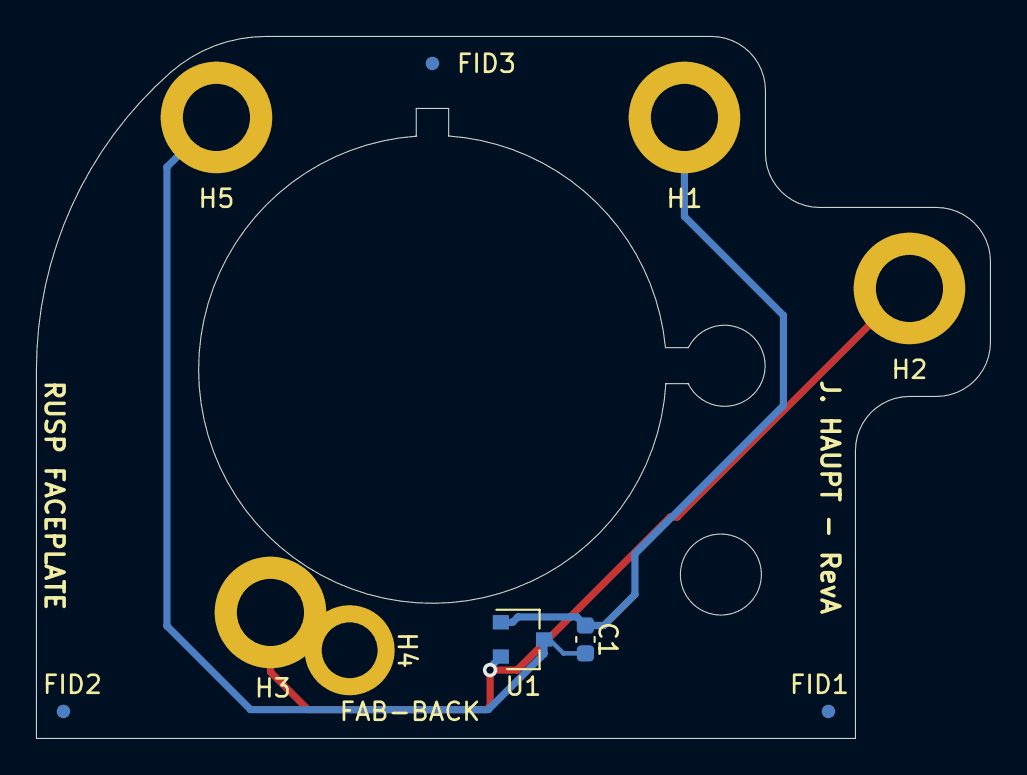
[picture p22: board RUST_Dialboard.kicad_pcb from below]

Board: 2 copper layers, 53.0 x 39.0 mm, 10 parts (5 on the bottom side), 3 nets.
