skysedge/RUST_Hardware/Antenna/RUST_Antenna.kicad_pcb

## KiCad design Antenna/RUST_Antenna.kicad_pcb (2024-06-24)

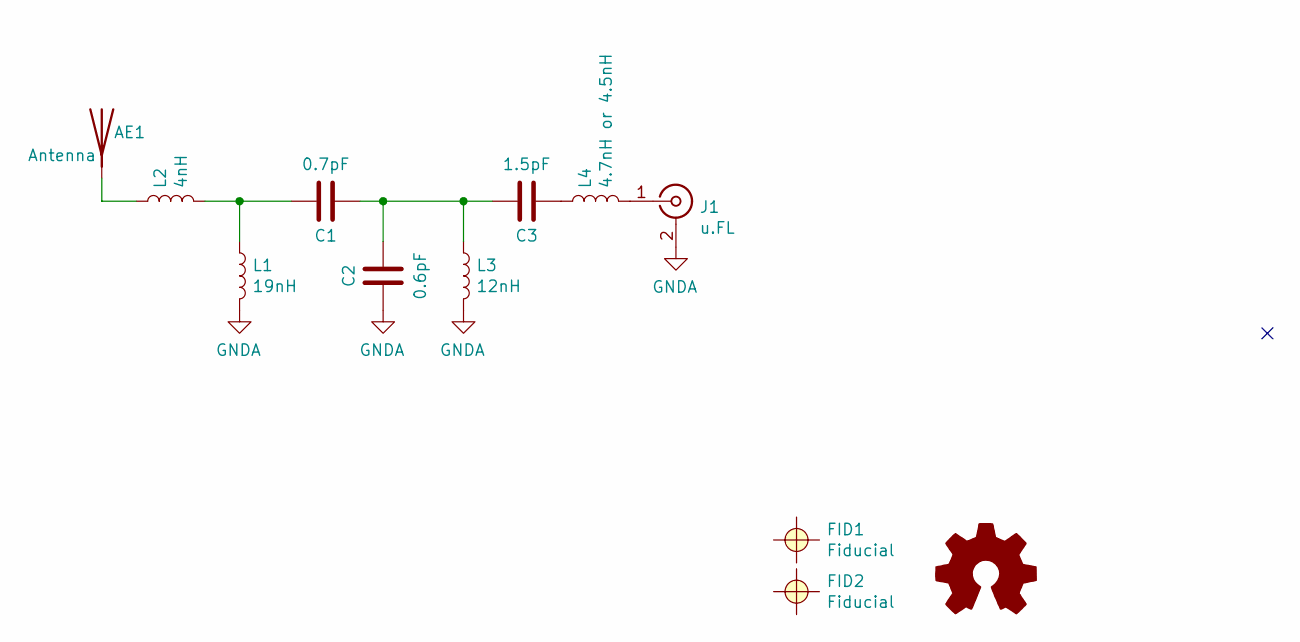
[picture p23: schematic RUST_Antenna.kicad_sch, RUSP Antenna Board]

Parts:
AE1: Antenna; Antenna_Ignion_RunmXtend_NN02-224; Mfg. Part. No. NN-02-224
C1: 0.7pF; C_0603_1608Metric; Mfg. Part No. GJM0335C1ER70WB01D
C2: 0.6pF; C_0603_1608Metric; Mfg. Part No. GRM0335C1HR60BA01D
C3: 1.5pF; C_0603_1608Metric; Mfg. Part No. CBR06C159B5GAC
FID1, FID2: Fiducial; Fiducial_0.75mm_Dia_1.5mm_Outer
J1: u.FL; U.FL_Molex_MCRF_73412-0110_Vertical; Mfg. Part No. 0734120110
L1: 19nH; L_0603_1608Metric; Mfg. Part No. LQW18AN19NJ80D
L2: 4nH; L_0402_1005Metric; Mfg. Part No. MHQ0402PSA4N0BT000
L3: 12nH; L_0603_1608Metric; Mfg. Part No. LQW18AN12NG10D
L4: 4.7nH or 4.5nH; L_0402_1005Metric; Mfg. Part No. lqw15an4n5b00d

Connections:
GNDA: C2.1, J1.2 (Ext), L1.2, L3.2
unnamed: AE1.1 (A), L2.1
unnamed: C1.1, C2.2, C3.2, L3.1
unnamed: C1.2, L1.1, L2.2
unnamed: C3.1, L4.1
unnamed: J1.1 (In), L4.2

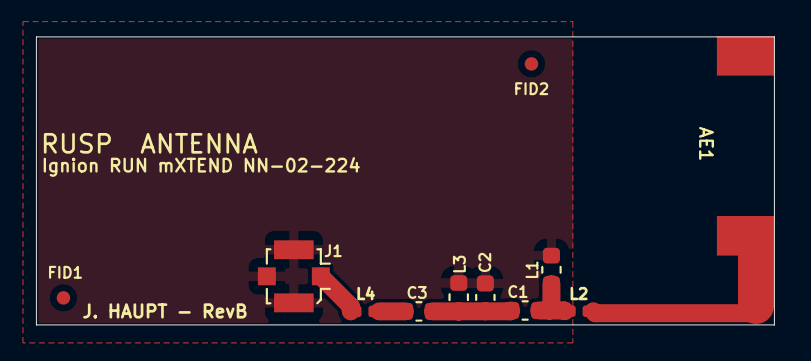
[picture p24: board RUST_Antenna.kicad_pcb from above]

Board: 2 copper layers, 41.0 x 16.0 mm, 11 parts (0 on the bottom side), 6 nets.
