skysedge/RUST_Hardware/Bak/051421/Mainboard/RUSP_Mainboard.kicad_pcb

## KiCad design Bak/051421/Mainboard/RUSP_Mainboard.kicad_pcb (2024-06-24)

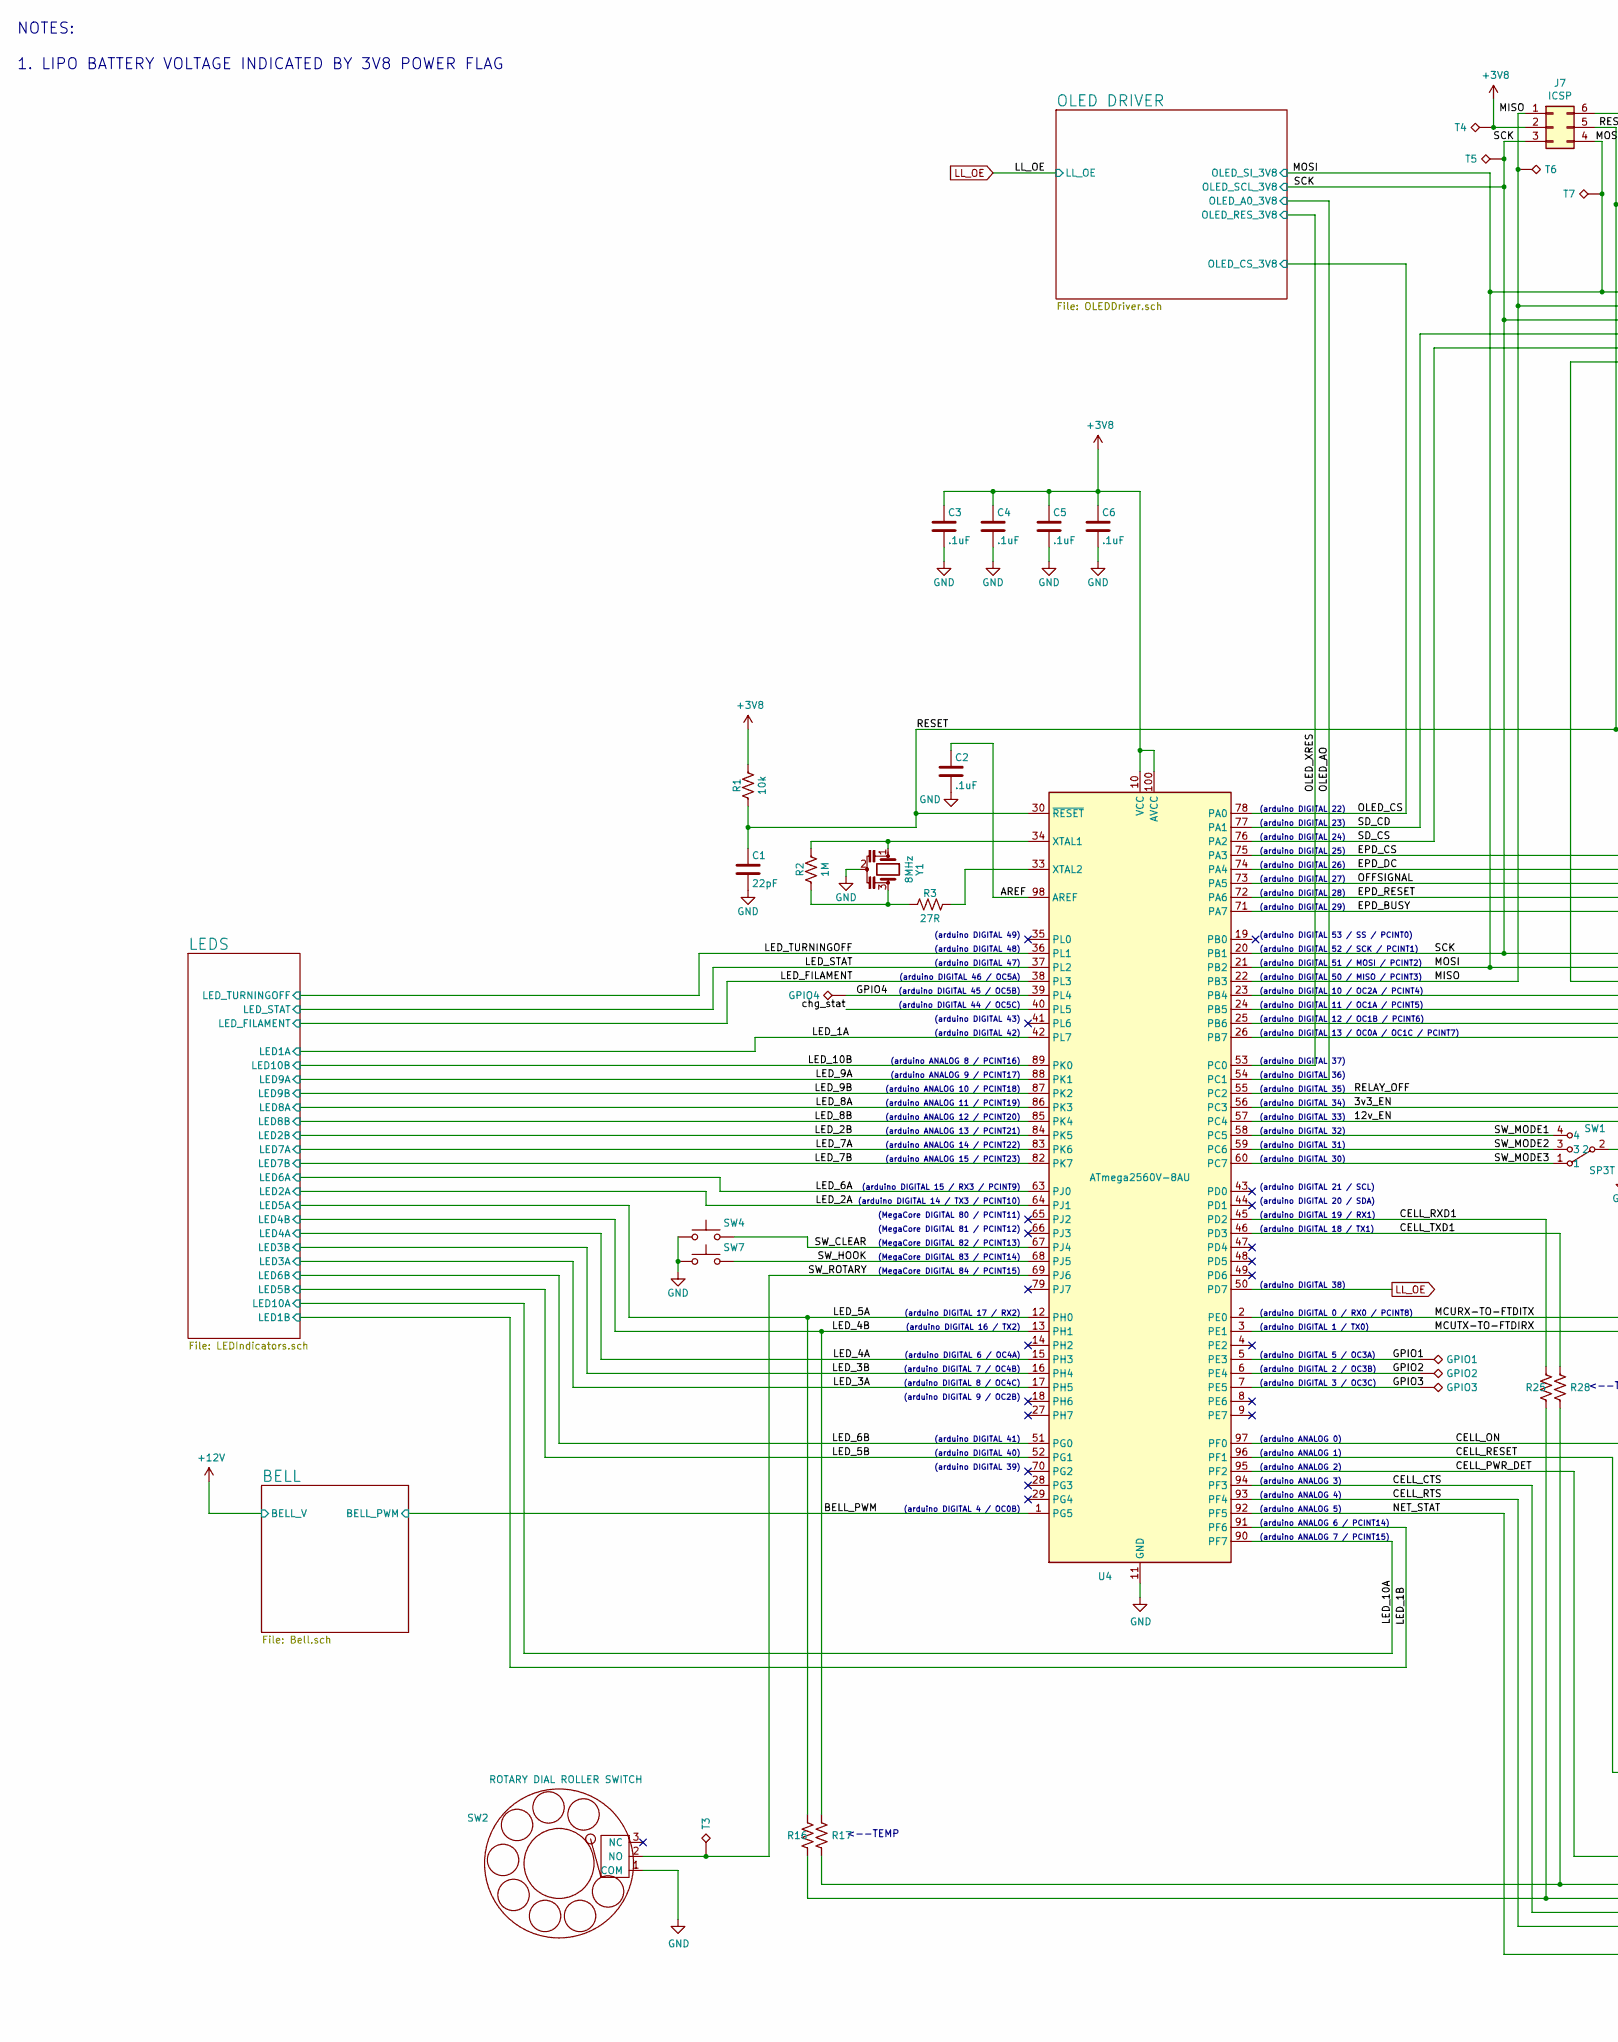
[picture p25: schematic RUSP_Mainboard.sch, 4G ROTARY CELLPHONE MAINBOARD, part in row 1, column 1]

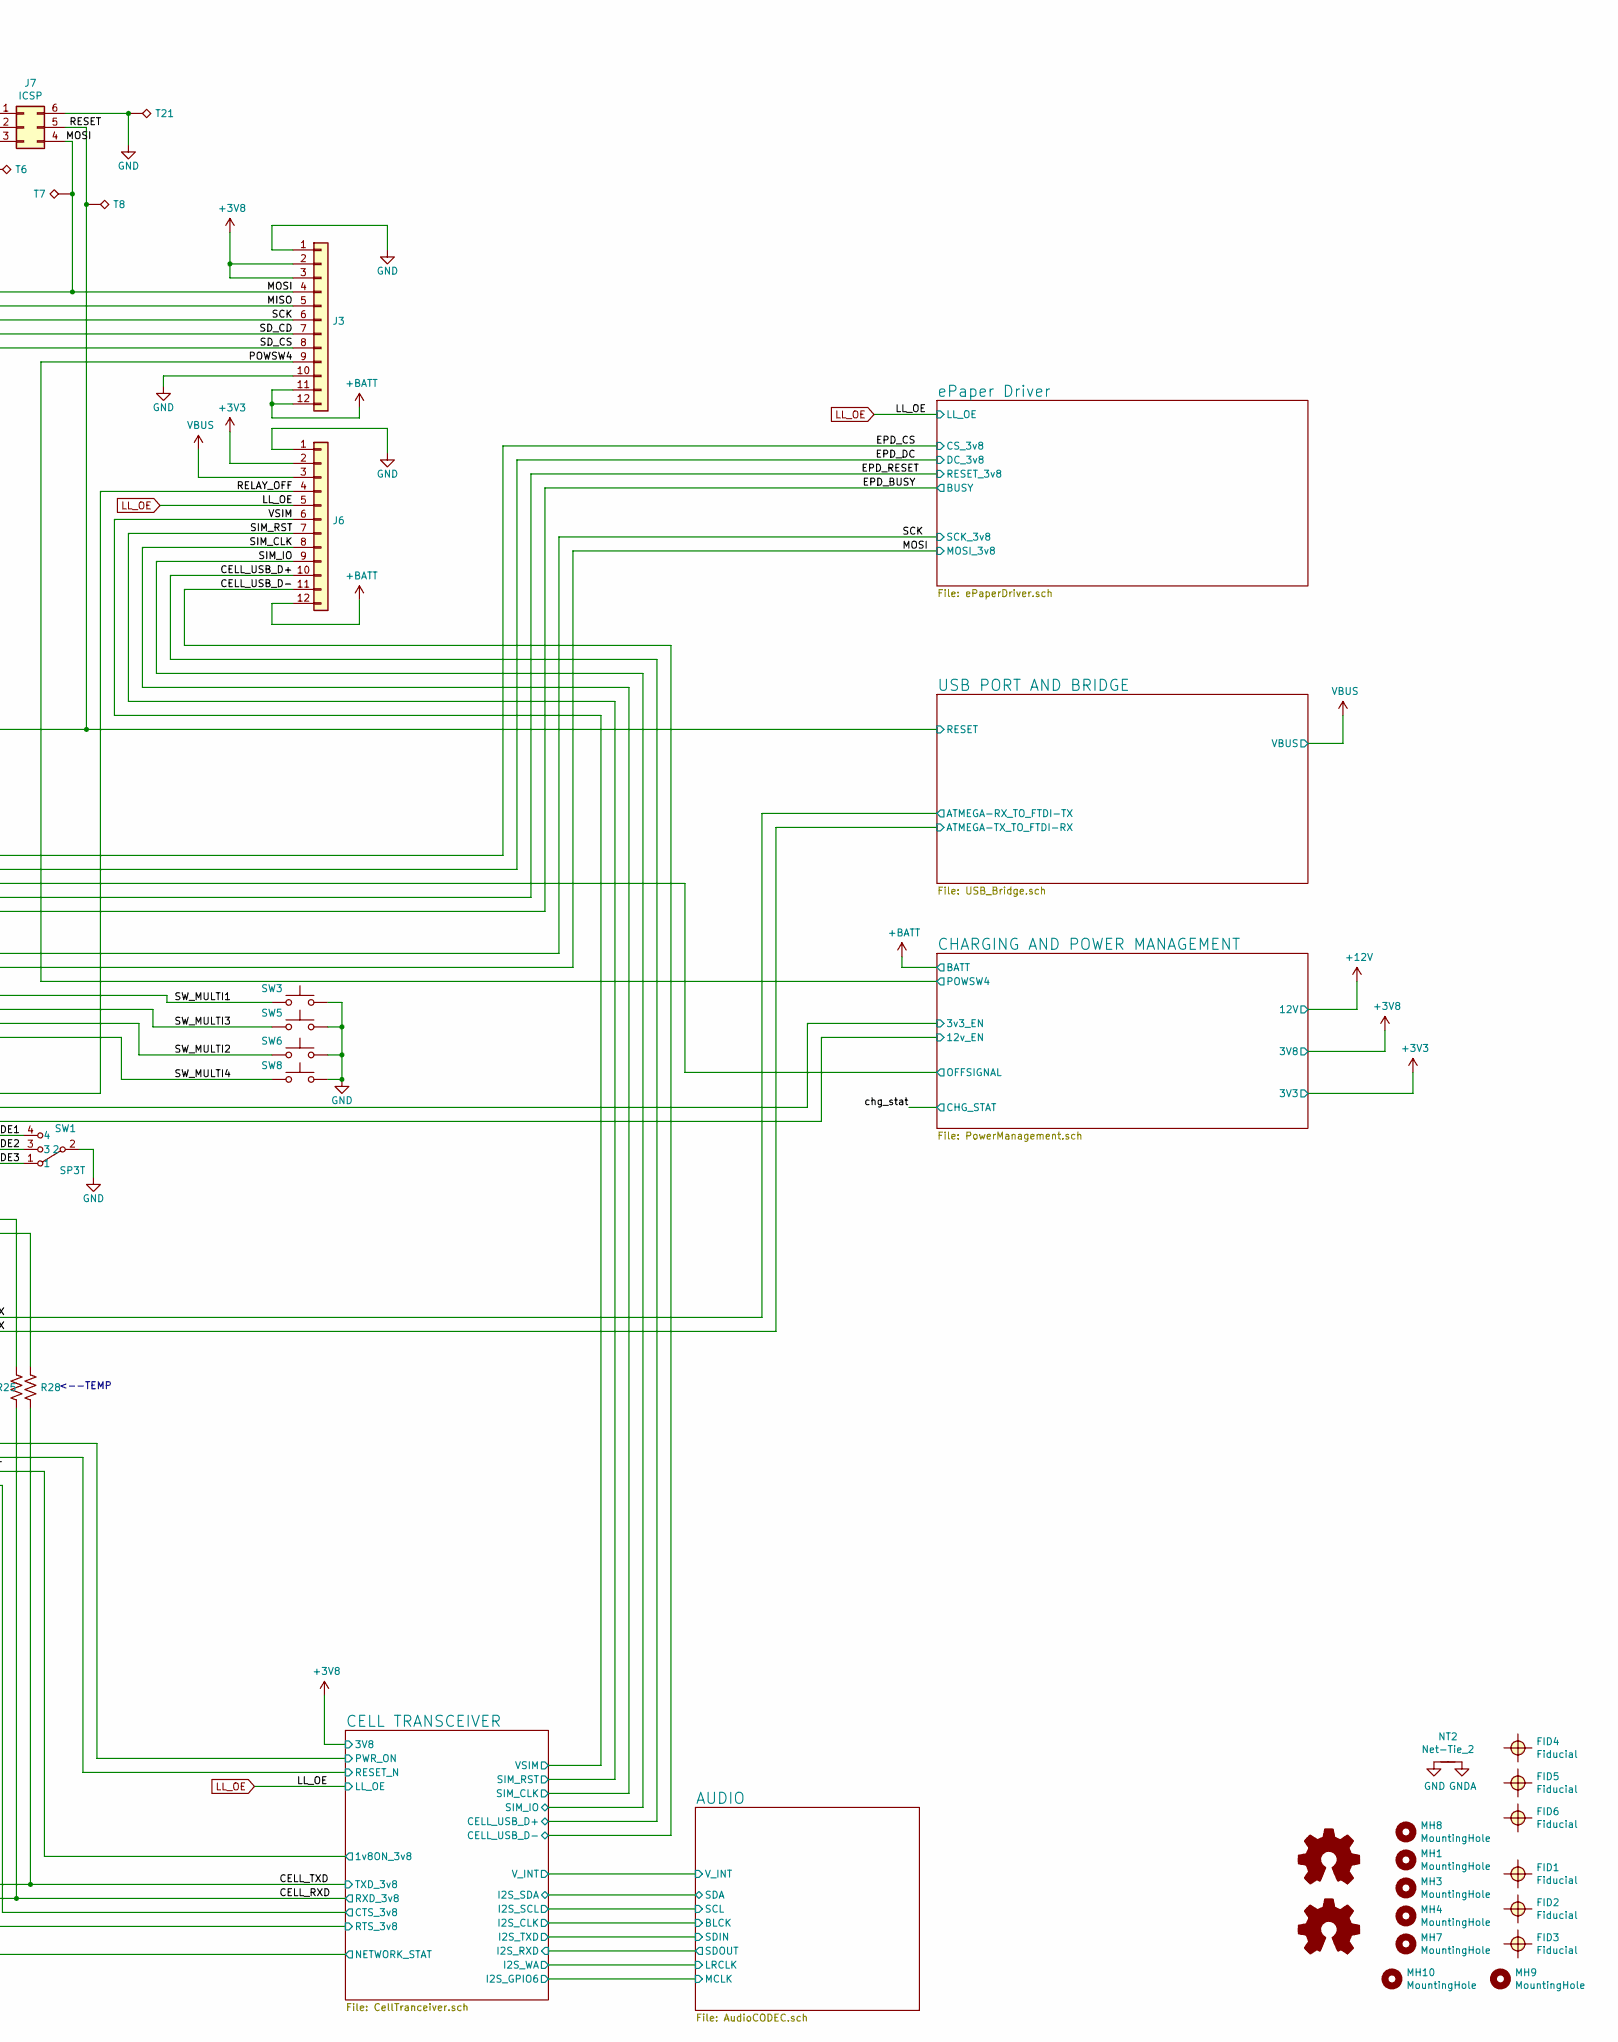
[picture p26: schematic RUSP_Mainboard.sch, 4G ROTARY CELLPHONE MAINBOARD, part in row 1, column 2]

Parts:
C1: 22pF; C_0402_1005Metric; Mfg. Part No. C0402C220J5GACTU
C2, C3, C4, C5, C6: .1uF; C_0402_1005Metric; Mfg. Part No. C0402C104Z4VACTU
FID1, FID2, FID3, FID4, FID5, FID6: Fiducial; Fiducial_0.75mm_Dia_1.5mm_Outer
GPIO1, GPIO2, GPIO3, GPIO4: TestPoint_Alt; TestPoint_Pad_1.0x1.0mm
J3, J6: Conn_01x12; Samtec_2x6Header_FTSH-106-01-L-DV; Mfg. Part No. FTSH-106-01-L-DV
J7: Conn_02x03_Counter_Clockwise; Tag-Connect_TC2030-IDC; Mfg. Part No. Mating Connector: TC2030-IDC
LOGO1: Logo1; SkysEdge_21mm
LOGO2: Logo2; SkysEdge_18mm
MH1, MH3, MH4, MH8: MountingHole; MountingHole_2.2mm_M2
MH7: MountingHole; SMTSO-M2-3ET; Mfg. Part No. SMTSO-M2-3ET
MH9, MH10: MountingHole; SMTSO-M1.6-1ET; Mfg. Part No. SMTSO-M1.6-1ET
NT2: Net-Tie_2; NetTie-2_SMD_Pad0.5mm
R1: 10k; R_0402_1005Metric; Mfg. Part No. CRGCQ0402J10K
R2: 1M; R_0402_1005Metric; Mfg. Part No. RC0402FR-071ML
R3: 27R; R_0402_1005Metric; Mfg. Part No. ERJ-2GEJ270X
R16, R17, R25, R28: 0R; R_0603_1608Metric
SW1: SP3T; SP3T_OS103011MA7QP1; Mfg. Part No. OS103011MA7QP1
SW2: ROTARY DIAL ROLLER SWITCH; LimitSwitch_D2F-01FL2-A1; Mfg. Part No. D2F-01FL2-A1
SW3, SW4, SW5, SW6, SW7, SW8: Tactile Switch; TactileSwitch_Panasonic_EVQ-Q2Y03W; Mfg. Part No. EVQ-Q2Y03W
T3, T4, T5, T6, T7, T8, T21: TestPoint_Alt; TestPoint_Pad_D1.5mm
U4: ATmega2560V-8AU; TQFP-100_14x14mm_P0.5mm; Mfg. Part No. ATMEGA2560V-8AUR
Y1: 8MHz; AWSCR-16.00CV-T; Mfg. Part No. AWSCR-8.00CV-T

Connections:
+3V3: J6.2; also elsewhere on the board
+3V8: C3.1, C4.1, C5.1, C6.1, J3.2, J3.3, J7.2, R1.2, T4.1, U4.10 (VCC), U4.31 (VCC), U4.61 (VCC), U4.80 (VCC), U4.100 (AVCC); also elsewhere on the board
+BATT: J3.11, J3.12, J6.12; also elsewhere on the board
/3v3_EN: U4.56 (PC3); also elsewhere on the board
/12v_EN: U4.57 (PC4); also elsewhere on the board
/AREF: C2.1, U4.98 (AREF)
/BELL_PWM: U4.1 (PG5); also elsewhere on the board
/CELL_CTS: U4.94 (PF3); also elsewhere on the board
/CELL_ON: U4.97 (PF0); also elsewhere on the board
/CELL_PWR_DET: U4.95 (PF2); also elsewhere on the board
/CELL_RESET: U4.96 (PF1); also elsewhere on the board
/CELL_RTS: U4.93 (PF4); also elsewhere on the board
/CELL_RXD: R16.2, R25.2; also elsewhere on the board
/CELL_RXD1: R25.1, U4.45 (PD2)
/CELL_TXD: R17.2, R28.2; also elsewhere on the board
/CELL_TXD1: R28.1, U4.46 (PD3)
/CELL_USB_D+: J6.10; also elsewhere on the board
/CELL_USB_D-: J6.11; also elsewhere on the board
/EPD_BUSY: U4.71 (PA7); also elsewhere on the board
/EPD_CS: U4.75 (PA3); also elsewhere on the board
/EPD_DC: U4.74 (PA4); also elsewhere on the board
/EPD_RESET: U4.72 (PA6); also elsewhere on the board
/GPIO1: GPIO1.1, U4.5 (PE3)
/GPIO2: GPIO2.1, U4.6 (PE4)
/GPIO3: GPIO3.1, U4.7 (PE5)
/GPIO4: GPIO4.1, U4.39 (PL4)
/LED_1A: U4.42 (PL7); also elsewhere on the board
/LED_1B: U4.91 (PF6); also elsewhere on the board
/LED_2A: U4.64 (PJ1); also elsewhere on the board
/LED_2B: U4.84 (PK5); also elsewhere on the board
/LED_3A: U4.17 (PH5); also elsewhere on the board
/LED_3B: U4.16 (PH4); also elsewhere on the board
/LED_4A: U4.15 (PH3); also elsewhere on the board
/LED_4B: R17.1, U4.13 (PH1); also elsewhere on the board
/LED_5A: R16.1, U4.12 (PH0); also elsewhere on the board
/LED_5B: U4.52 (PG1); also elsewhere on the board
/LED_6A: U4.63 (PJ0); also elsewhere on the board
/LED_6B: U4.51 (PG0); also elsewhere on the board
/LED_7A: U4.83 (PK6); also elsewhere on the board
/LED_7B: U4.82 (PK7); also elsewhere on the board
/LED_8A: U4.86 (PK3); also elsewhere on the board
/LED_8B: U4.85 (PK4); also elsewhere on the board
/LED_9A: U4.88 (PK1); also elsewhere on the board
/LED_9B: U4.87 (PK2); also elsewhere on the board
/LED_10A: U4.90 (PF7); also elsewhere on the board
/LED_10B: U4.89 (PK0); also elsewhere on the board
/LED_FILAMENT: U4.38 (PL3); also elsewhere on the board
/LED_STAT: U4.37 (PL2); also elsewhere on the board
/LED_TURNINGOFF: U4.36 (PL1); also elsewhere on the board
/MCURX-TO-FTDITX: U4.2 (PE0); also elsewhere on the board
/MCUTX-TO-FTDIRX: U4.3 (PE1); also elsewhere on the board
/MISO: J3.5, J7.1, T6.1, U4.22 (PB3)
/MOSI: J3.4, J7.4, T7.1, U4.21 (PB2); also elsewhere on the board
/NET_STAT: U4.92 (PF5); also elsewhere on the board
/OFFSIGNAL: U4.73 (PA5); also elsewhere on the board
/OLED_AO: U4.54 (PC1); also elsewhere on the board
/OLED_CS: U4.78 (PA0); also elsewhere on the board
/OLED_XRES: U4.53 (PC0); also elsewhere on the board
/POWSW4: J3.9; also elsewhere on the board
/RELAY_OFF: J6.4, U4.55 (PC2)
/RESET: C1.1, J7.5, R1.1, T8.1, U4.30 (~RESET); also elsewhere on the board
/SCK: J3.6, J7.3, T5.1, U4.20 (PB1); also elsewhere on the board
/SD_CD: J3.7, U4.77 (PA1)
/SD_CS: J3.8, U4.76 (PA2)
/SIM_CLK: J6.8; also elsewhere on the board
/SIM_IO: J6.9; also elsewhere on the board
/SIM_RST: J6.7; also elsewhere on the board
/SW_CLEAR: SW4.1, U4.67 (PJ4)
/SW_HOOK: SW7.1, U4.68 (PJ5)
/SW_MODE1: SW1.4, U4.58 (PC5)
/SW_MODE2: SW1.3, U4.59 (PC6)
/SW_MODE3: SW1.1, U4.60 (PC7)
/SW_MULTI1: SW3.1, U4.23 (PB4)
/SW_MULTI2: SW6.1, U4.25 (PB6)
/SW_MULTI3: SW5.1, U4.24 (PB5)
/SW_MULTI4: SW8.1, U4.26 (PB7)
/SW_ROTARY: SW2.2 (NO), T3.1, U4.69 (PJ6)
/VSIM: J6.6; also elsewhere on the board
/chg_stat: U4.40 (PL5); also elsewhere on the board
GND: C1.2, C2.2, C3.2, C4.2, C5.2, C6.2, J3.1, J3.10, J6.1, J7.6, NT2.1, SW1.2, SW2.1 (COM), SW3.2, SW4.2, SW5.2, SW6.2, SW7.2, SW8.2, T21.1, U4.11 (GND), U4.32 (GND), U4.62 (GND), U4.81 (GND), U4.99 (GND), Y1.2; also elsewhere on the board
GNDA: NT2.2; also elsewhere on the board
LL_OE: J6.5, U4.50 (PD7); also elsewhere on the board
unnamed: R2.1, R3.1, Y1.3
unnamed: R2.2, U4.34 (XTAL1), Y1.1
unnamed: R3.2, U4.33 (XTAL2)
VBUS: J6.3; also elsewhere on the board

Notes on the sheet:
(arduino DIGITAL 1 / TX0)
(arduino DIGITAL 0 / RX0 / PCINT8)
(arduino DIGITAL 7 / OC4B)
(arduino DIGITAL 8 / OC4C)
(arduino DIGITAL 45 / OC5B)
(arduino DIGITAL 46 / OC5A)
(arduino ANALOG 0)
(arduino DIGITAL 52 / SCK / PCINT1)
(arduino DIGITAL 13 / OC0A / OC1C / PCINT7)
(arduino DIGITAL 20 / SDA)
(arduino DIGITAL 21 / SCL)
(arduino DIGITAL 51 / MOSI / PCINT2)
(arduino DIGITAL 50 / MISO / PCINT3)
(arduino DIGITAL 17 / RX2)
(arduino DIGITAL 14 / TX3 / PCINT10)
(arduino DIGITAL 25)
(arduino DIGITAL 26)
(arduino ANALOG 3)
(arduino DIGITAL 24)
(arduino DIGITAL 27)
(arduino DIGITAL 3 / OC3C)
(arduino DIGITAL 16 / TX2)
(arduino DIGITAL 53 / SS / PCINT0)
(arduino DIGITAL 47)
(arduino DIGITAL 48)
(arduino DIGITAL 49)
(arduino DIGITAL 6 / OC4A)
(arduino DIGITAL 44 / OC5C)
(arduino DIGITAL 2 / OC3B)
(arduino DIGITAL 9 / OC2B)
(arduino DIGITAL 19 / RX1)
(arduino DIGITAL 18 / TX1)
(arduino DIGITAL 38)
(arduino DIGITAL 5 / OC3A)
(arduino DIGITAL 28)
(arduino DIGITAL 43)
(arduino ANALOG 15 / PCINT23)
(MegaCore DIGITAL 84 / PCINT15)
(MegaCore DIGITAL 83 / PCINT14)
(arduino DIGITAL 23)
(arduino DIGITAL 22)
(arduino DIGITAL 29)
(arduino DIGITAL 11 / OC1A / PCINT5)
(arduino DIGITAL 12 / OC1B / PCINT6)
(arduino DIGITAL 39)
(arduino DIGITAL 4 / OC0B)
(arduino DIGITAL 42)
(arduino DIGITAL 41)
(arduino DIGITAL 40)
(arduino DIGITAL 37)
(arduino DIGITAL 36)
(arduino DIGITAL 35)
(arduino DIGITAL 34)
(arduino DIGITAL 33)
(arduino DIGITAL 32)
(arduino DIGITAL 31)
(arduino DIGITAL 30)
(arduino DIGITAL 15 / RX3 / PCINT9)
(MegaCore DIGITAL 80 / PCINT11)
(MegaCore DIGITAL 81 / PCINT12)
(MegaCore DIGITAL 82 / PCINT13)
(arduino ANALOG 14 / PCINT22)
(arduino ANALOG 13 / PCINT21)
(arduino ANALOG 12 / PCINT20)
(arduino ANALOG 11 / PCINT19)
(arduino ANALOG 10 / PCINT18)
(arduino ANALOG 9 / PCINT17)
(arduino ANALOG 8 / PCINT16)
(arduino ANALOG 7 / PCINT15)
(arduino ANALOG 6 / PCINT14)
(arduino ANALOG 1)
(arduino ANALOG 2)
(arduino ANALOG 4)
(arduino ANALOG 5)
NOTES: 1. LIPO BATTERY VOLTAGE INDICATED BY 3V8 POWER FLAG
<--TEMP
(arduino DIGITAL 10 / OC2A / PCINT4)

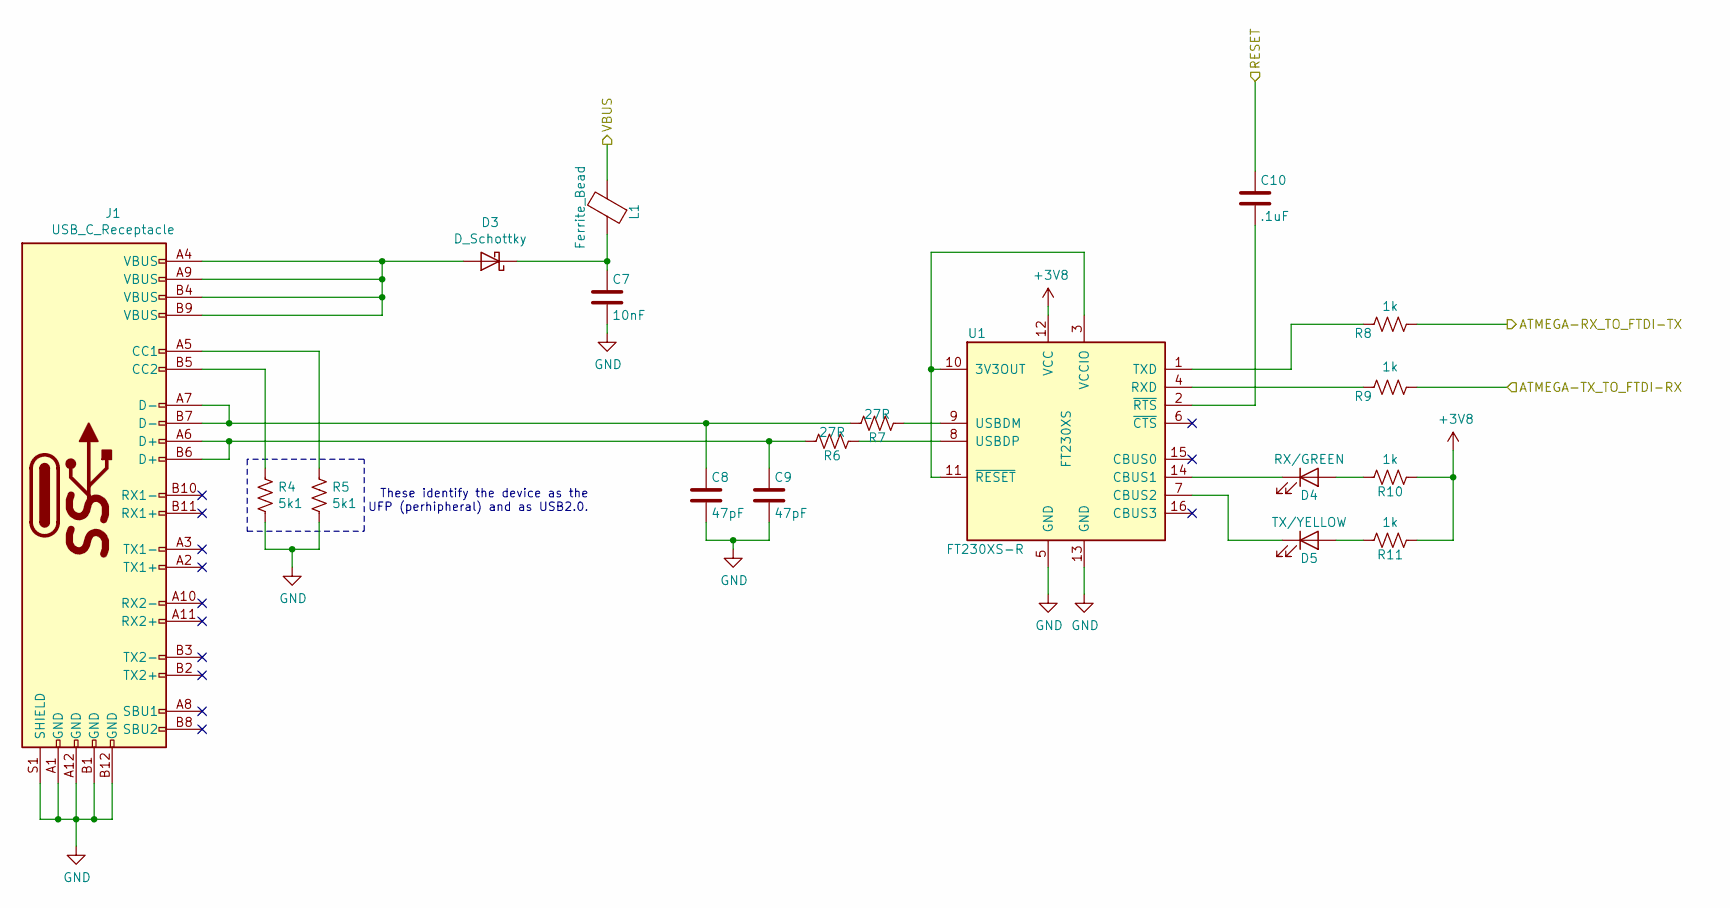
[picture p27: schematic USB_Bridge.sch, RCP USB PORT & BRIDGE]

Parts:
C7: 10nF; C_0402_1005Metric; Mfg. Part No. C0402C103K4RACTU
C8, C9: 47pF; C_0402_1005Metric; Mfg. Part No. C0402C470K5GACTU
C10: .1uF; C_0402_1005Metric; Mfg. Part No. C0402C104Z4VACTU
D3: D_Schottky; D_SOD-123; Mfg. Part No. MBR130T3G
D4: RX/GREEN; LED_0603_1608Metric_Castellated; Mfg. Part No. LT Q39G-Q1OO-25-1
D5: TX/YELLOW; LED_0603_1608Metric_Castellated; Mfg. Part No. IN-S63AT5Y
J1: USB_C_Receptacle; CUI_UJ31-CH-G1-SMT-TR; Mfg. Part No. UJ31-CH-G1-SMT-TR
L1: Ferrite_Bead; R_0805_2012Metric_Pad1.15x1.40mm_HandSolder; Mfg. Part No. MI0805K601R-10
R4, R5: 5k1; R_0402_1005Metric; Mfg. Part No. RC0402FR-075K1L
R6, R7: 27R; R_0402_1005Metric; Mfg. Part No. ERJ-2GEJ270X
R8, R9, R10, R11: 1k; R_0402_1005Metric; Mfg. Part No. RC0402JR-071KL
U1: FT230XS; SSOP-16; Mfg. Part No. FT230XS-R

Connections:
+3V8: R10.1, R11.1, U1.12 (VCC); also elsewhere on the board
/MCURX-TO-FTDITX: R8.2; also elsewhere on the board
/MCUTX-TO-FTDIRX: R9.1; also elsewhere on the board
/RESET: C10.1; also elsewhere on the board
GND: C7.2, C8.2, C9.2, J1.A1 (GND), J1.A12 (GND), J1.B1 (GND), J1.B12 (GND), J1.S1 (SHIELD), R4.2, R5.2, U1.5 (GND), U1.13 (GND); also elsewhere on the board
unnamed: C7.1, D3.1 (K), L1.1
unnamed: C8.1, J1.A7 (D-), J1.B7 (D-), R7.2
unnamed: C9.1, J1.A6 (D+), J1.B6 (D+), R6.2
unnamed: C10.2, U1.2 (~RTS)
unnamed: D3.2 (A), J1.A4 (VBUS), J1.A9 (VBUS), J1.B4 (VBUS), J1.B9 (VBUS)
unnamed: D4.1 (K), U1.14 (CBUS1)
unnamed: D4.2 (A), R10.2
unnamed: D5.1 (K), U1.7 (CBUS2)
unnamed: D5.2 (A), R11.2
unnamed: J1.A5 (CC1), R5.1
unnamed: J1.B5 (CC2), R4.1
unnamed: R6.1, U1.8 (USBDP)
unnamed: R7.1, U1.9 (USBDM)
unnamed: R8.1, U1.1 (TXD)
unnamed: R9.2, U1.4 (RXD)
unnamed: U1.3 (VCCIO), U1.10 (3V3OUT), U1.11 (~RESET)
VBUS: L1.2; also elsewhere on the board

Notes on the sheet:
These identify the device as the UFP (perhipheral) and as USB2.0.

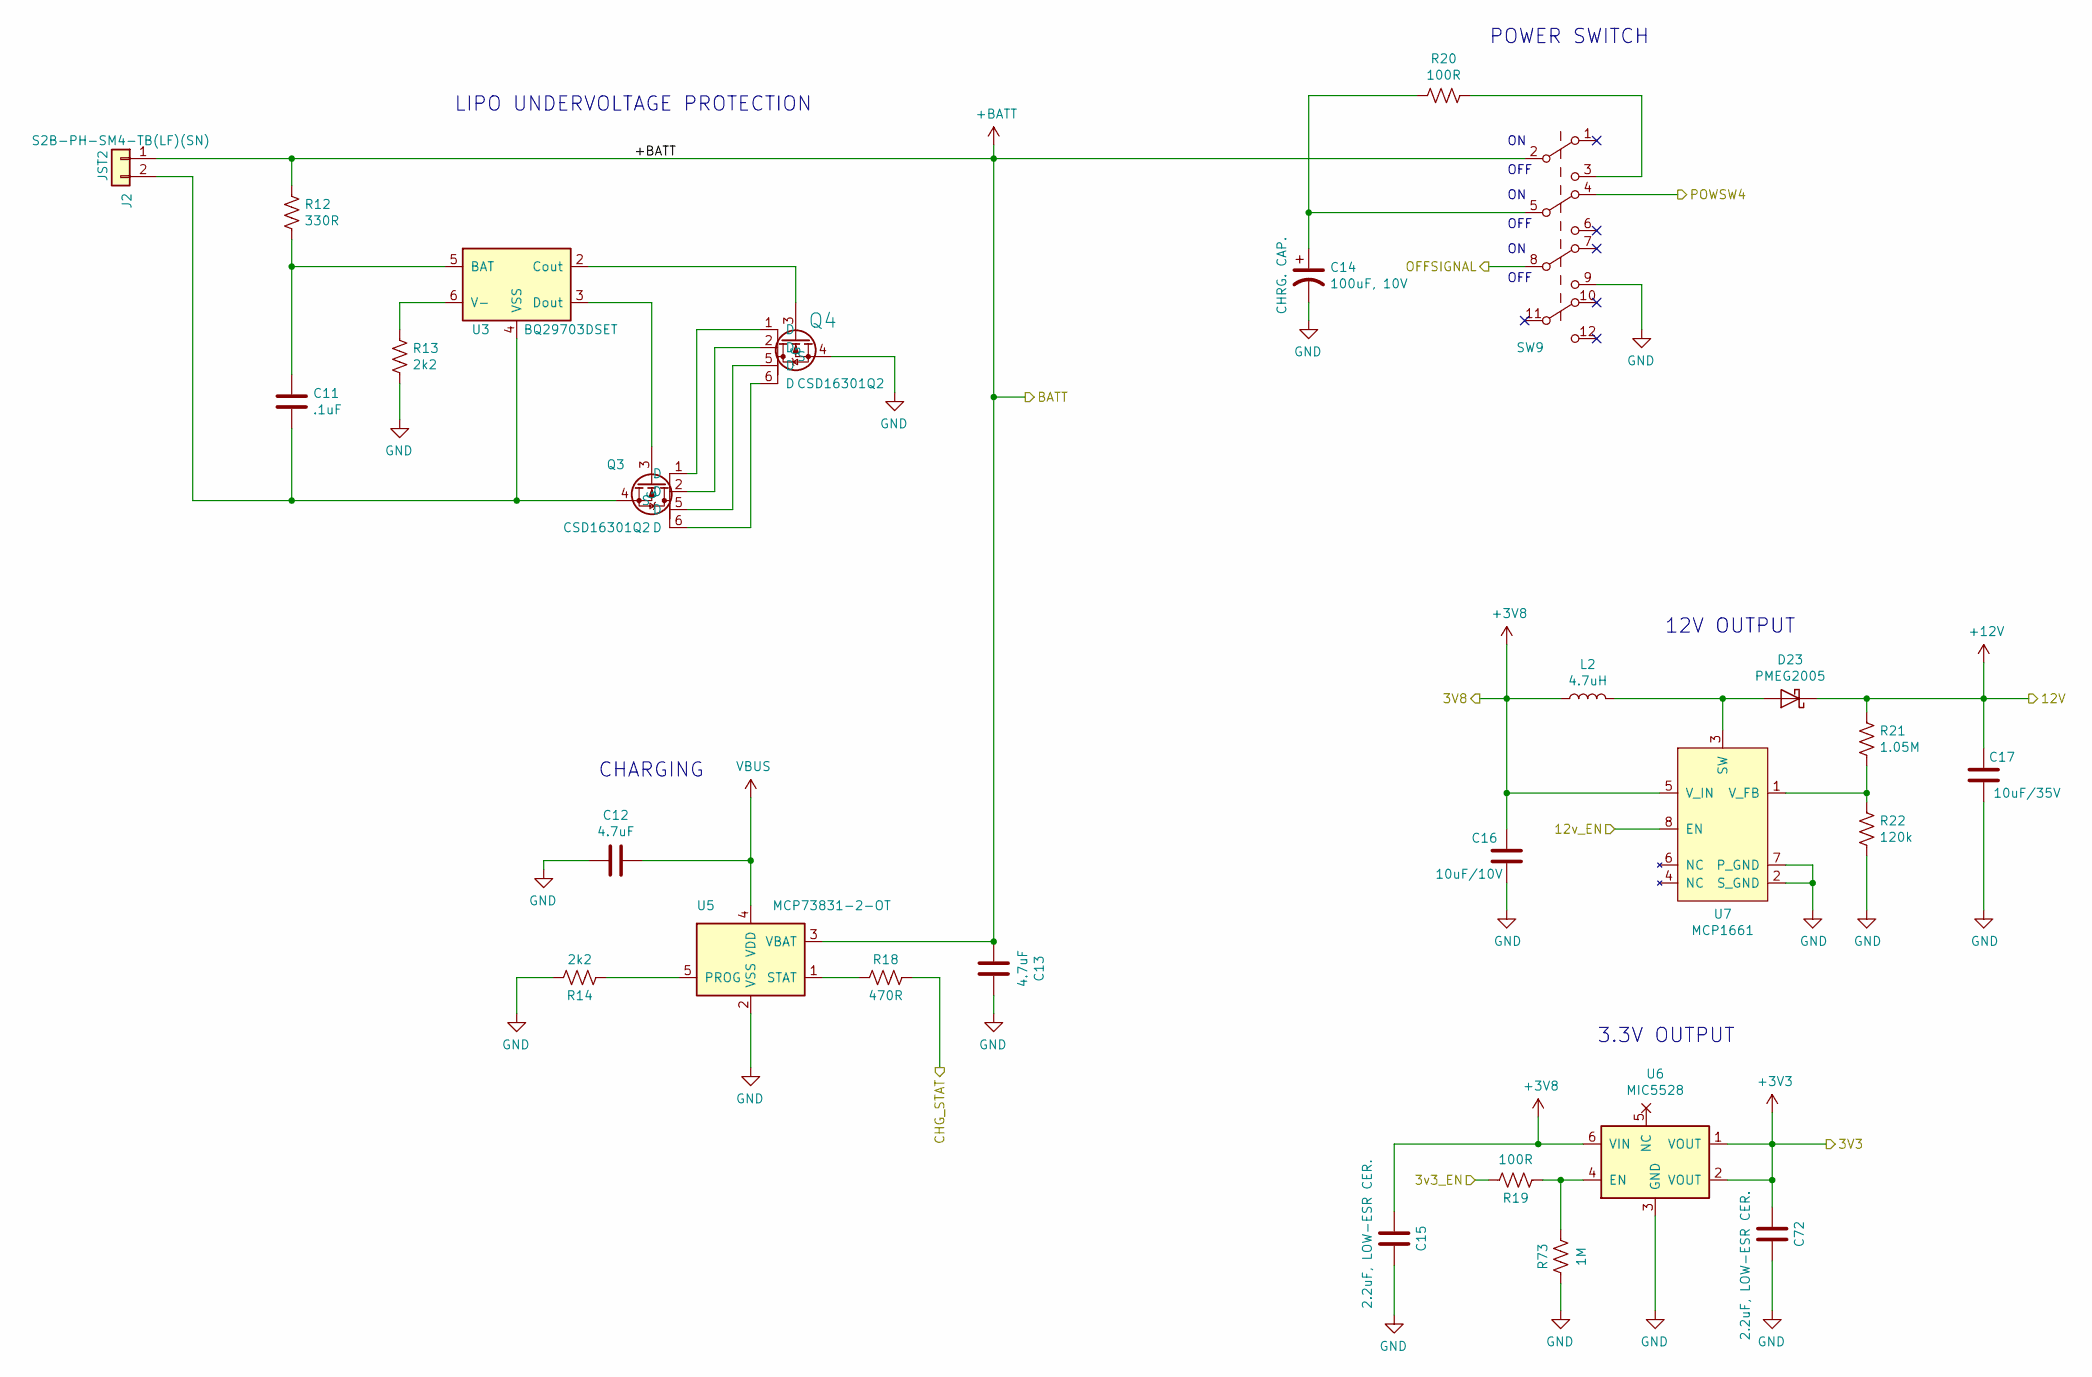
[picture p28: schematic PowerManagement.sch, RCP CHARGING AND POWER MANAGEMENT]

Parts:
C11: .1uF; C_0402_1005Metric; Mfg. Part No. C0402C104Z4VACTU
C12, C13: 4.7uF; C_0603_1608Metric; Mfg. Part No. CL10A475KQ8NNNC
C14: 100uF, 10V; CP_Elec_6.3x4.5; Mfg. Part No. 865080243007
C15, C72: 2.2uF, LOW-ESR CER.; C_0402_1005Metric; Mfg. Part No. C1005X5R1A225M050BC
C16: 10uF/10V; C_0805_2012Metric; Mfg. Part No. C2012X7R1A106K125AC
C17: 10uF/35V; R_1206_3216Metric; Mfg. Part No. CGA5L1X7R1V106K160AC
D23: PMEG2005; D_SOD-123; Mfg. Part No. PMEG2005EGWJ
J2: JST2; S2B-PH-SM4-TBLFSN; Mfg. Part No. S2B-PH-SM4-TB(LF)(SN)
L2: 4.7uH; Inductor_Wurth_74438336100; Mfg. Part No. 74438336047
Q3, Q4: Q_NMOS_POWER; TI_CSD16301Q2; Mfg. Part No. CSD16301Q2
R12: 330R; R_0402_1005Metric; Mfg. Part No. ERJ-2GEJ331X
R13, R14: 2k2; R_0402_1005Metric; Mfg. Part No. ERJ-2GEJ222X
R18: 470R; R_0402_1005Metric; Mfg. Part No. RC0402JR-07470RL
R19, R20: 100R; R_0402_1005Metric; Mfg. Part No. ERJ-2RKF1000X
R21: 1.05M; R_0402_1005Metric; Mfg. Part No. RC0402FR-071M05L
R22: 120k; R_0402_1005Metric; Mfg. Part No. RC0402FR-07120KL
R73: 1M; R_0402_1005Metric; Mfg. Part No. RC0402FR-071ML
SW9: SW_4P2T; Switch_4PDT_ESwitch-EG4208; Mfg. Part No. EG4208
U3: BQ29703DSET; WSON-6_1.5x1.5mm_P0.5mm; Mfg. Part No. BQ29703DSET
U5: MCP73831-2-OT; SOT-23-5; Mfg. Part No. MCP73831T-2ACI/OT
U6: MIC5528; LDO_MIC5528; Mfg. Part No. MIC5528-3.3YMT-TR
U7: MCP1661; BoostConverter_MCP1661; Mfg. Part No. MCP1661T-E/MNY

Connections:
+3V3: C72.2, U6.1 (VOUT), U6.2 (VOUT); also elsewhere on the board
+3V8: C15.2, C16.1, L2.1, U6.6 (VIN), U7.5 (V_IN); also elsewhere on the board
+12V: C17.1, D23.1 (K), R21.1; also elsewhere on the board
+BATT: C13.2, J2.1, R12.1, SW9.2, U5.3 (VBAT); also elsewhere on the board
/3v3_EN: R19.2; also elsewhere on the board
/12v_EN: U7.8 (EN); also elsewhere on the board
/OFFSIGNAL: SW9.8; also elsewhere on the board
/POWSW4: SW9.4; also elsewhere on the board
/chg_stat: R18.1; also elsewhere on the board
GND: C12.2, C13.1, C14.2, C15.1, C16.2, C17.2, C72.1, Q4.4 (S), R13.1, R14.1, R22.2, R73.1, SW9.9, U5.2 (VSS), U6.3 (GND), U7.2 (S_GND), U7.7 (P_GND); also elsewhere on the board
unnamed: C11.1, R12.2, U3.5 (BAT)
unnamed: C11.2, J2.2, Q3.4 (S), U3.4 (VSS)
unnamed: C14.1, R20.2, SW9.5
unnamed: D23.2 (A), L2.2, U7.3 (SW)
unnamed: Q3.1 (D), Q4.1 (D)
unnamed: Q3.2 (D), Q4.2 (D)
unnamed: Q3.3 (G), U3.3 (Dout)
unnamed: Q3.5 (D), Q4.5 (D)
unnamed: Q3.6 (D), Q4.6 (D)
unnamed: Q4.3 (G), U3.2 (Cout)
unnamed: R13.2, U3.6 (V-)
unnamed: R14.2, U5.5 (PROG)
unnamed: R18.2, U5.1 (STAT)
unnamed: R19.1, R73.2, U6.4 (EN)
unnamed: R20.1, SW9.3
unnamed: R21.2, R22.1, U7.1 (V_FB)
VBUS: C12.1, U5.4 (VDD); also elsewhere on the board

Notes on the sheet:
CHARGING
LIPO UNDERVOLTAGE PROTECTION
3.3V OUTPUT
12V OUTPUT
POWER SWITCH
ON OFF
