skysedge/RUST_Hardware/Bak/051421/Mainboard/RUSP_Mainboard.kicad_pcb

## KiCad design Bak/051421/Mainboard/RUSP_Mainboard.kicad_pcb (continued)

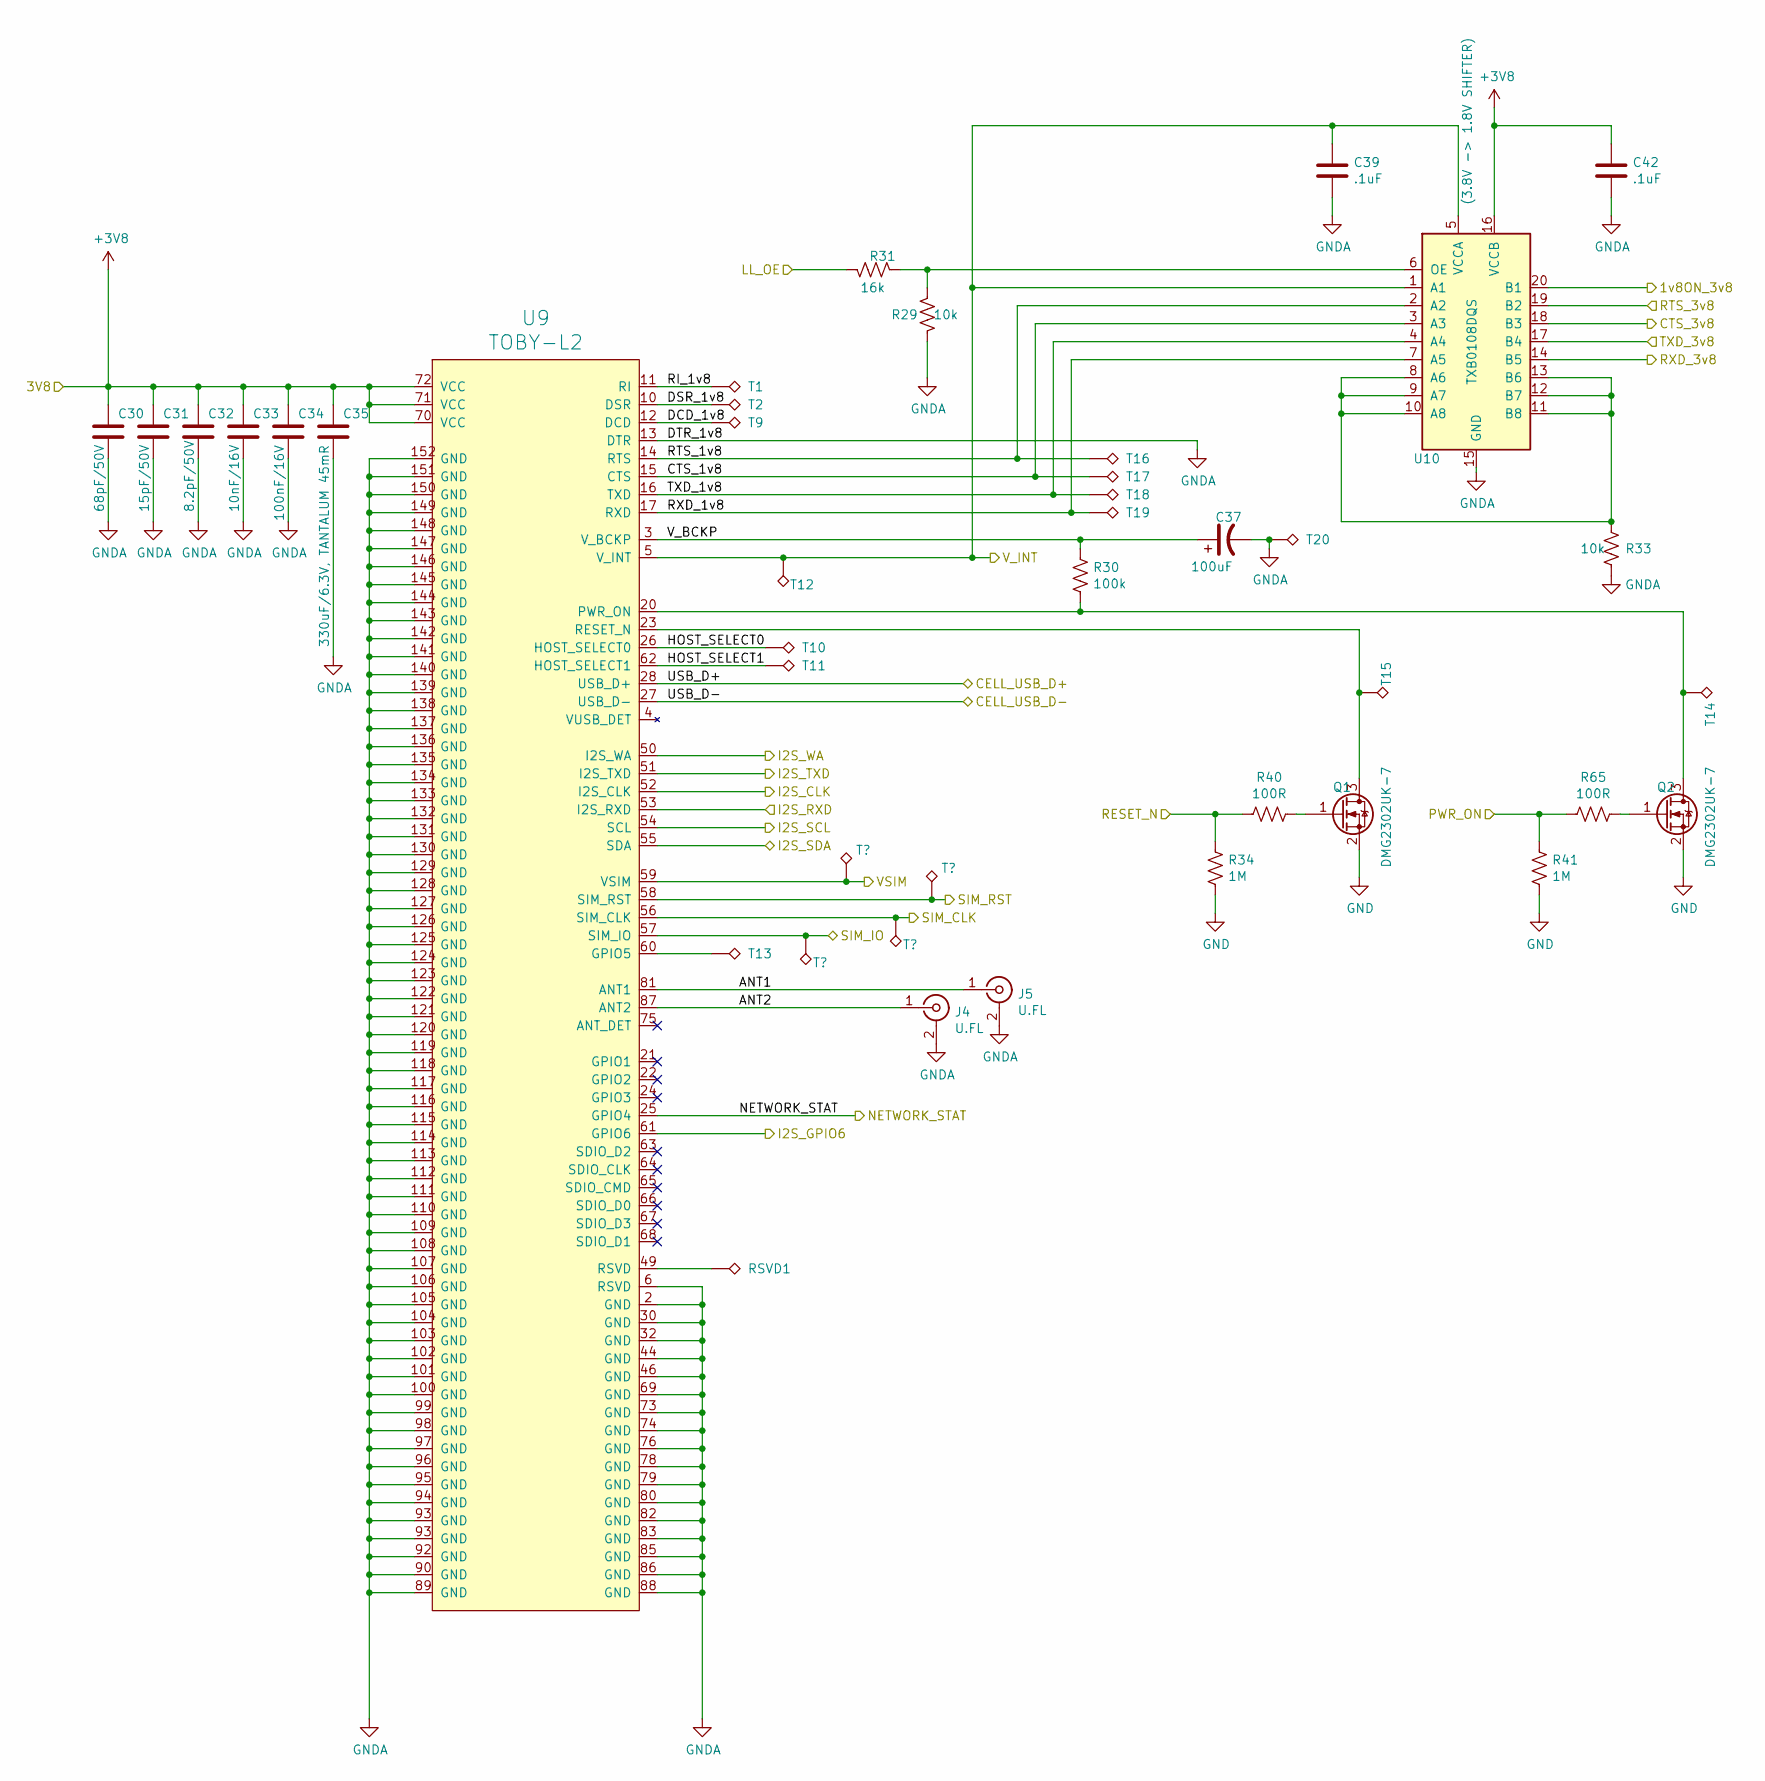
[picture p29: schematic CellTranceiver.sch, RCP 4G CELLULAR TRANCEIVER]

Parts:
C30: 68pF/50V; C_0402_1005Metric; Mfg. Part No. GRM1555C1H680JA01J
C31: 15pF/50V; C_0402_1005Metric; Mfg. Part No. GRM1555C1H150JA01J
C32: 8.2pF/50V; C_0402_1005Metric; Mfg. Part No. CC0402DRNPO9BN8R2
C33: 10nF/16V; C_0402_1005Metric; Mfg. Part No. GRM155R71C103KA01D
C34: 100nF/16V; C_0402_1005Metric; Mfg. Part No. C0402C104K4RACTU
C35: 330uF/6.3V, TANTALUM 45mR; C_2917; Mfg. Part No. T520D337M006ATE045
C37: 100uF; Capacitor_Wurth865080243007; Mfg. Part No. 865080243007
C39, C42: .1uF; C_0402_1005Metric; Mfg. Part No. C0402C104Z4VACTU
J4, J5: U.FL; U.FL_Molex_MCRF_73412-0110_Vertical; Mfg. Part No. 0734120110
Q1, Q2: DMG2302UK-7; SOT-23; Mfg. Part No. DMG2302UK-7
R29, R33: 10k; R_0402_1005Metric; Mfg. Part No. CRGCQ0402J10K
R30: 100k; R_0402_1005Metric; Mfg. Part No. RC0402FR-07100KL
R31: 16k; R_0402_1005Metric; Mfg. Part No. RC0402FR-0716KL
R34, R41: 1M; R_0402_1005Metric; Mfg. Part No. RC0402FR-071ML
R40, R65: 100R; R_0402_1005Metric; Mfg. Part No. ERJ-2RKF1000X
RSVD1: TestPoint_Alt; TestPoint_Pad_1.0x1.0mm
T1, T2, T9, T10, T11, T12, T13, T14, T15, T16, T17, T18, T19, T20: TestPoint_Alt; TestPoint_Pad_1.0x1.0mm
U9: TOBY-L2; CellModule_TOBY-L2; Mfg. Part No. TOBY-L201-02S
U10: TXB0108DQS; USON-20_2x4mm_P0.4mm; Mfg. Part No. TXB0108DQSR

Connections:
+3V8: C30.1, C31.1, C32.1, C33.1, C34.1, C35.1, C42.1, U9.70 (VCC), U9.71 (VCC), U9.72 (VCC), U10.16 (VCCB); also elsewhere on the board
/AUDIO/BLCK: U9.52 (I2S_CLK); also elsewhere on the board
/AUDIO/V_INT: C39.1, T12.1, U9.5 (V_INT), U10.1 (A1), U10.5 (VCCA); also elsewhere on the board
/CELL TRANSCEIVER/ANT1: J5.1 (In), U9.81 (ANT1)
/CELL TRANSCEIVER/ANT2: J4.1 (In), U9.87 (ANT2)
/CELL TRANSCEIVER/CTS_1v8: T17.1, U9.15 (CTS), U10.3 (A3)
/CELL TRANSCEIVER/DCD_1v8: T9.1, U9.12 (DCD)
/CELL TRANSCEIVER/DSR_1v8: T2.1, U9.10 (DSR)
/CELL TRANSCEIVER/HOST_SELECT0: T10.1, U9.26 (HOST_SELECT0)
/CELL TRANSCEIVER/HOST_SELECT1: T11.1, U9.62 (HOST_SELECT1)
/CELL TRANSCEIVER/I2S_GPIO6: U9.61 (GPIO6); also elsewhere on the board
/CELL TRANSCEIVER/I2S_RXD: U9.53 (I2S_RXD); also elsewhere on the board
/CELL TRANSCEIVER/I2S_SCL: U9.54 (SCL); also elsewhere on the board
/CELL TRANSCEIVER/I2S_SDA: U9.55 (SDA); also elsewhere on the board
/CELL TRANSCEIVER/I2S_TXD: U9.51 (I2S_TXD); also elsewhere on the board
/CELL TRANSCEIVER/I2S_WA: U9.50 (I2S_WA); also elsewhere on the board
/CELL TRANSCEIVER/RI_1v8: T1.1, U9.11 (RI)
/CELL TRANSCEIVER/RTS_1v8: T16.1, U9.14 (RTS), U10.2 (A2)
/CELL TRANSCEIVER/RXD_1v8: T19.1, U9.17 (RXD), U10.7 (A5)
/CELL TRANSCEIVER/TXD_1v8: T18.1, U9.16 (TXD), U10.4 (A4)
/CELL TRANSCEIVER/V_BCKP: C37.1, R30.1, U9.3 (V_BCKP)
/CELL_CTS: U10.18 (B3); also elsewhere on the board
/CELL_ON: R41.1, R65.2; also elsewhere on the board
/CELL_PWR_DET: U10.20 (B1); also elsewhere on the board
/CELL_RESET: R34.1, R40.2; also elsewhere on the board
/CELL_RTS: U10.19 (B2); also elsewhere on the board
/CELL_RXD: U10.14 (B5); also elsewhere on the board
/CELL_TXD: U10.17 (B4); also elsewhere on the board
/CELL_USB_D+: U9.28 (USB_D+); also elsewhere on the board
/CELL_USB_D-: U9.27 (USB_D-); also elsewhere on the board
/NET_STAT: U9.25 (GPIO4); also elsewhere on the board
/SIM_CLK: U9.56 (SIM_CLK); also elsewhere on the board
/SIM_IO: U9.57 (SIM_IO); also elsewhere on the board
/SIM_RST: U9.58 (SIM_RST); also elsewhere on the board
/VSIM: U9.59 (VSIM); also elsewhere on the board
GND: Q1.2 (S), Q2.2 (S), R34.2, R41.2; also elsewhere on the board
GNDA: C30.2, C31.2, C32.2, C33.2, C34.2, C35.2, C37.2, C39.2, C42.2, J4.2 (Ext), J5.2 (Ext), R29.2, R33.2, T20.1, U9.2 (GND), U9.6 (RSVD), U9.13 (DTR), U9.30 (GND), U9.32 (GND), U9.44 (GND), U9.46 (GND), U9.69 (GND), U9.73 (GND), U9.74 (GND), U9.76 (GND), U9.78 (GND), U9.79 (GND), U9.80 (GND), U9.82 (GND), U9.83 (GND), U9.85 (GND), U9.86 (GND), U9.88 (GND), U9.89 (GND), U9.90 (GND), U9.92 (GND), U9.93 (GND), U9.94 (GND), U9.95 (GND), U9.96 (GND), U9.97 (GND), U9.98 (GND), U9.99 (GND), U9.100 (GND), U9.101 (GND), U9.102 (GND), U9.103 (GND), U9.104 (GND), U9.105 (GND), U9.106 (GND), U9.107 (GND), U9.108 (GND), U9.109 (GND), U9.110 (GND), U9.111 (GND), U9.112 (GND), U9.113 (GND), U9.114 (GND), U9.115 (GND), U9.116 (GND), U9.117 (GND), U9.118 (GND), U9.119 (GND), U9.120 (GND), U9.121 (GND), U9.122 (GND), U9.123 (GND), U9.124 (GND), U9.125 (GND), U9.126 (GND), U9.127 (GND), U9.128 (GND), U9.129 (GND), U9.130 (GND), U9.131 (GND), U9.132 (GND), U9.133 (GND), U9.134 (GND), U9.135 (GND), U9.136 (GND), U9.137 (GND), U9.138 (GND), U9.139 (GND), U9.140 (GND), U9.141 (GND), U9.142 (GND), U9.143 (GND), U9.144 (GND), U9.145 (GND), U9.146 (GND), U9.147 (GND), U9.148 (GND), U9.149 (GND), U9.150 (GND), U9.151 (GND), U9.152 (GND), U10.15 (GND); also elsewhere on the board
LL_OE: R31.2; also elsewhere on the board
unnamed: Q1.1 (G), R40.1
unnamed: Q1.3 (D), T15.1, U9.23 (RESET_N)
unnamed: Q2.1 (G), R65.1
unnamed: Q2.3 (D), R30.2, T14.1, U9.20 (PWR_ON)
unnamed: R29.1, R31.1, U10.6 (OE)
unnamed: R33.1, U10.8 (A6), U10.9 (A7), U10.10 (A8), U10.11 (B8), U10.12 (B7), U10.13 (B6)
unnamed: RSVD1.1, U9.49 (RSVD)
unnamed: T13.1, U9.60 (GPIO5)

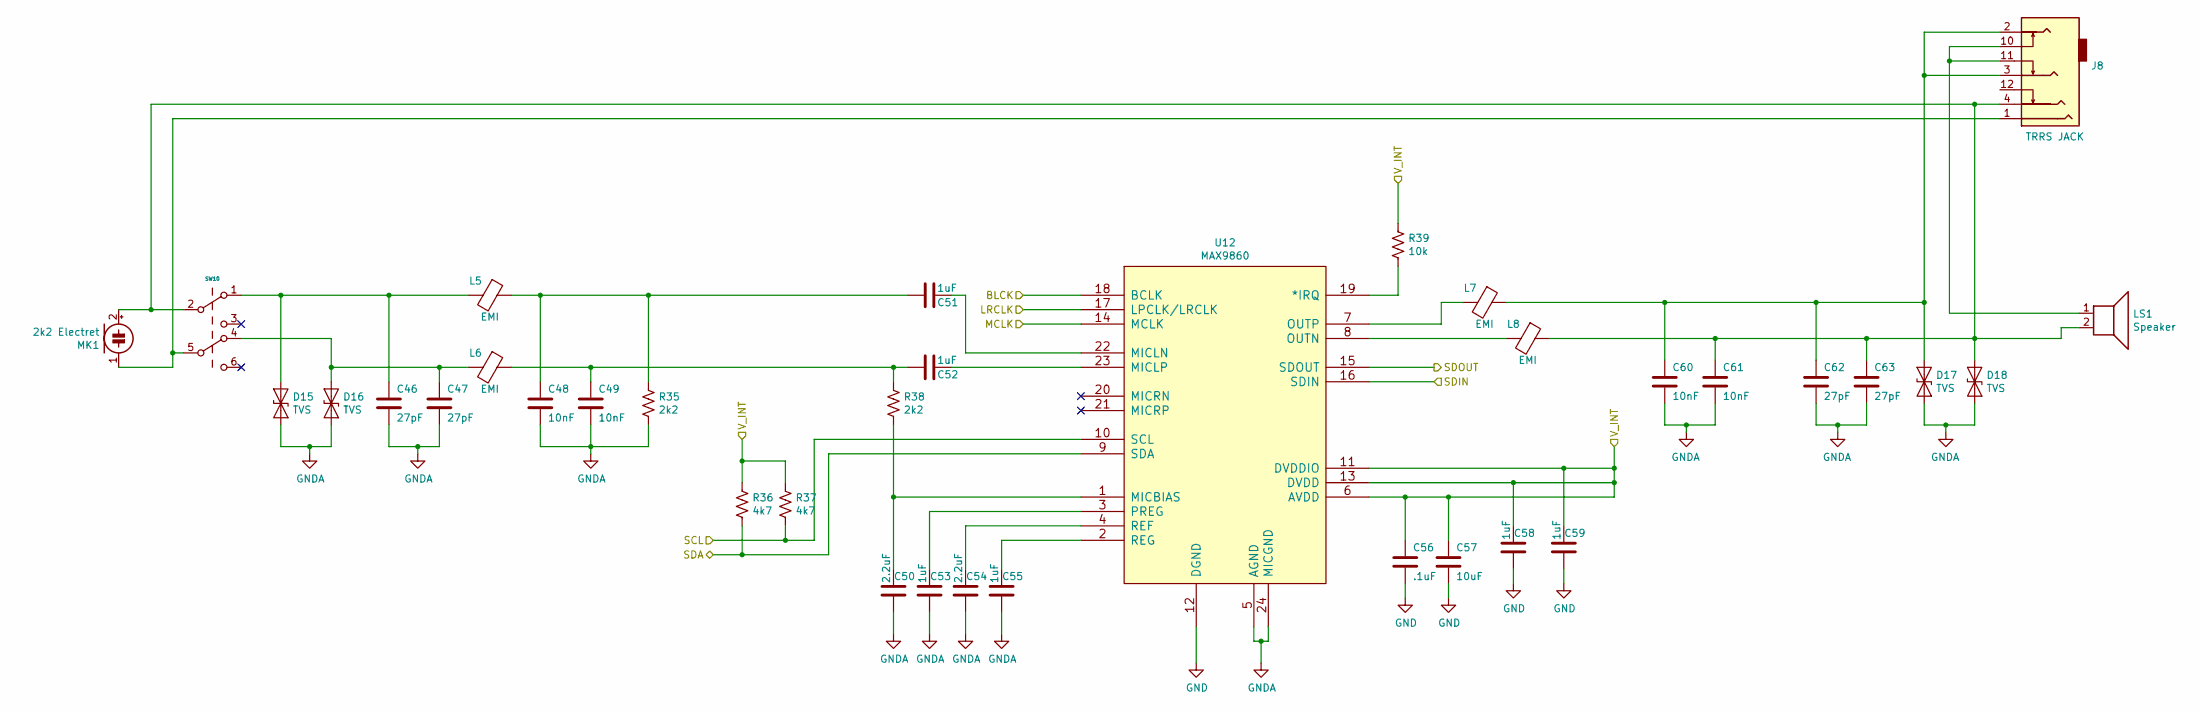
[picture p30: schematic AudioCODEC.sch, RCP 4G AUDIO CODEC AND I/O]

Parts:
C46, C47, C62, C63: 27pF; C_0402_1005Metric; Mfg. Part No. C0402C270J5GACTU
C48, C49, C60, C61: 10nF; C_0402_1005Metric; Mfg. Part No. GCM155R71H103KA55D
C50, C54: 2.2uF; C_0603_1608Metric; Mfg. Part No. C0603C225K9PACTU
C51, C52, C53, C55, C58, C59: 1uF; C_0402_1005Metric; Mfg. Part No. C0402C105K9PACTU
C56: .1uF; C_0402_1005Metric; Mfg. Part No. C0402C104Z4VACTU
C57: 10uF; C_0603_1608Metric; Mfg. Part No. C0603C106M9PACTU
D15, D16, D17, D18: TVS; R_0603_1608Metric_Pad1.05x0.95mm_HandSolder; Mfg. Part No. USB0001DP
J8: AudioJack_TRRS_3Switch; AudioJack_TRRS_CUI_SJ-43617-SMT-TR; Mfg. Part No. SJ-43617-SMT-TR
L5, L6, L7, L8: EMI; L_0402_1005Metric; Mfg. Part No. BLM15HD182SN1D
LS1: Speaker; Speaker_PUI_AR01232MS-SC12-WP-R; Mfg. Part No. AR01232MS-SC12-WP-R
MK1: 2k2 Electret; Microphone_PUI_POM-2738P-R; Mfg. Part No. POM-2738P-R
R35, R38: 2k2; R_0402_1005Metric; Mfg. Part No. ERJ-2GEJ222X
R36, R37: 4k7; R_0402_1005Metric; Mfg. Part No. CRG0402F4K7
R39: 10k; R_0402_1005Metric; Mfg. Part No. CRGCQ0402J10K
SW10: SW_DPDT; Switch_DPDT_Nidec_CL-SB-22C-XX; Mfg. Part No. CL-SB-22C-11
U12: MAX9860; WQFN-24-1EP_4x4mm_P0.5mm_EP2.7x2.7mm; Mfg. Part No. MAX9860ETG+

Connections:
/AUDIO/BLCK: U12.18 (BCLK); also elsewhere on the board
/AUDIO/V_INT: C56.1, C57.1, C58.1, C59.1, R36.1, R37.1, R39.1, U12.6 (AVDD), U12.11 (DVDDIO), U12.13 (DVDD); also elsewhere on the board
/CELL TRANSCEIVER/I2S_GPIO6: U12.14 (MCLK); also elsewhere on the board
/CELL TRANSCEIVER/I2S_RXD: U12.15 (SDOUT); also elsewhere on the board
/CELL TRANSCEIVER/I2S_SCL: R37.2, U12.10 (SCL); also elsewhere on the board
/CELL TRANSCEIVER/I2S_SDA: R36.2, U12.9 (SDA); also elsewhere on the board
/CELL TRANSCEIVER/I2S_TXD: U12.16 (SDIN); also elsewhere on the board
/CELL TRANSCEIVER/I2S_WA: U12.17 (LPCLK/LRCLK); also elsewhere on the board
GND: C56.2, C57.2, C58.2, C59.2, U12.12 (DGND); also elsewhere on the board
GNDA: C46.2, C47.2, C48.2, C49.2, C50.2, C53.2, C54.2, C55.2, C60.2, C61.2, C62.2, C63.2, D15.2 (A2), D16.2 (A2), D17.2 (A2), D18.2 (A2), R35.2, U12.5 (AGND), U12.24 (MICGND); also elsewhere on the board
unnamed: C46.1, D15.1 (A1), L5.2, SW10.1
unnamed: C47.1, D16.1 (A1), L6.2, SW10.4
unnamed: C48.1, C51.2, L5.1, R35.1
unnamed: C49.1, C52.2, L6.1, R38.1
unnamed: C50.1, R38.2, U12.1 (MICBIAS)
unnamed: C51.1, U12.22 (MICLN)
unnamed: C52.1, U12.23 (MICLP)
unnamed: C53.1, U12.3 (PREG)
unnamed: C54.1, U12.4 (REF)
unnamed: C55.1, U12.2 (REG)
unnamed: C60.1, C62.1, D17.1 (A1), J8.2, J8.3, L7.1
unnamed: C61.1, C63.1, D18.1 (A1), J8.4, L8.1, LS1.2, MK1.2 (+), SW10.2
unnamed: J8.1, MK1.1 (-), SW10.5
unnamed: J8.10, J8.11, LS1.1
unnamed: L7.2, U12.7 (OUTP)
unnamed: L8.2, U12.8 (OUTN)
unnamed: R39.2, U12.19 (*IRQ)

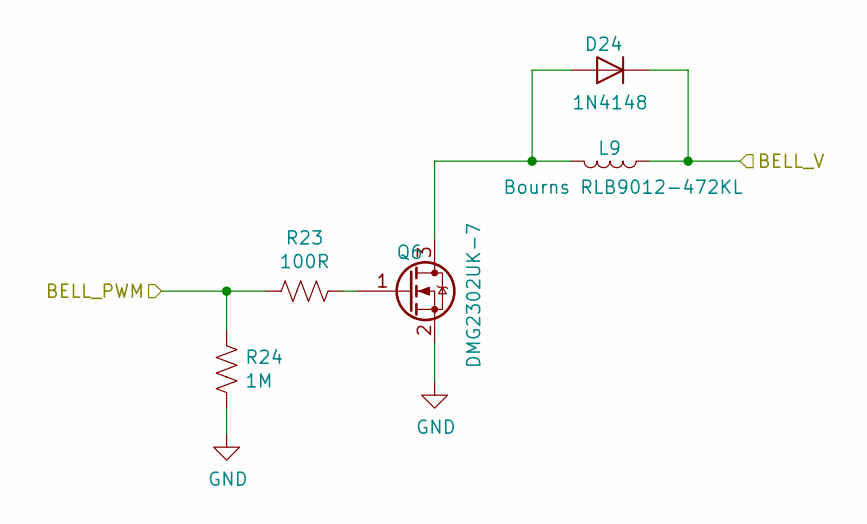
[picture p31: schematic Bell.sch, RCP 4G BELL RINGER]

Parts:
D24: 1N4148; D_SOD-123; Mfg. Part No. 1N4148W-13-F
L9: COIL; 3pSocket_RA_GCT_BG302-03-A-L-G; Mfg. Part No. BG302-03-A-L-G
Q6: DMG2302UK-7; SOT-23; Mfg. Part No. DMG2302UK-7
R23: 100R; R_0402_1005Metric; Mfg. Part No. ERJ-2RKF1000X
R24: 1M; R_0402_1005Metric; Mfg. Part No. RC0402FR-071ML

Connections:
+12V: D24.1 (K), L9.1; also elsewhere on the board
/BELL_PWM: R23.2, R24.1; also elsewhere on the board
GND: Q6.2 (S), R24.2; also elsewhere on the board
unnamed: D24.2 (A), L9.2, Q6.3 (D)
unnamed: Q6.1 (G), R23.1

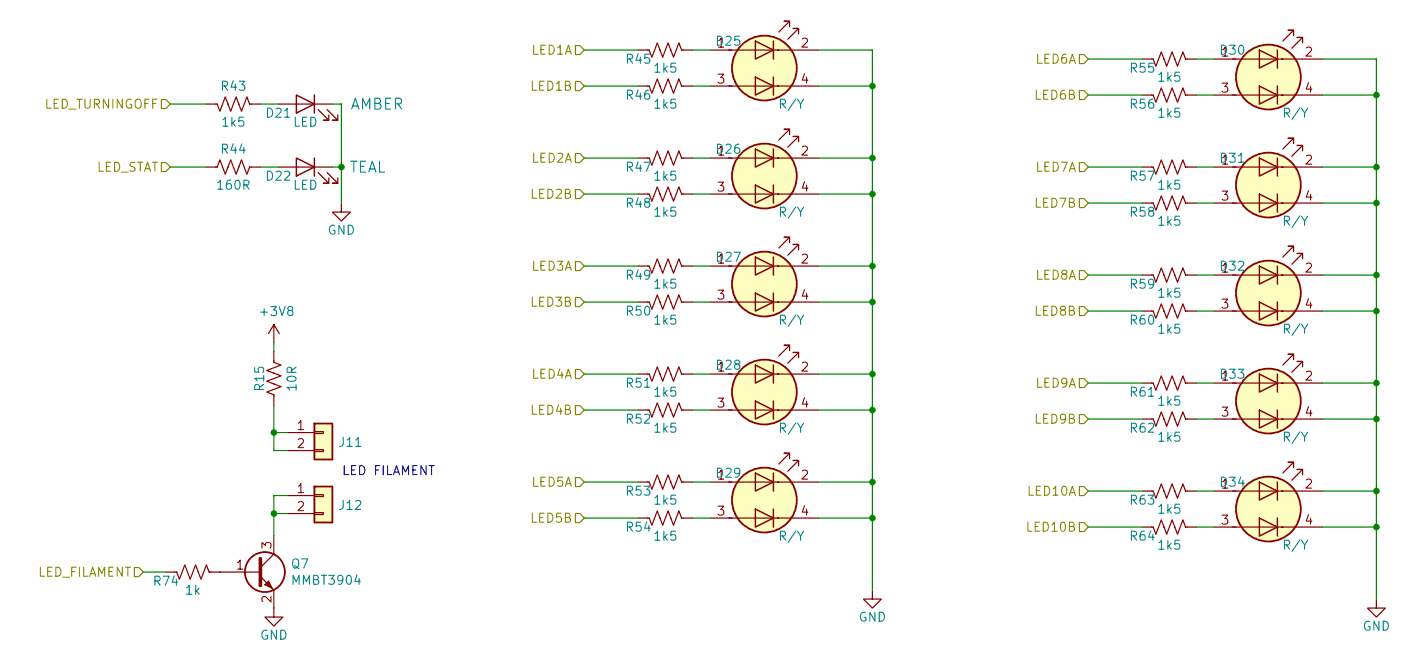
[picture p32: schematic LEDIndicators.sch, RCP STATUS LEDS]

Parts:
D21: LED; LED_0603_1608Metric_Castellated; Mfg. Part No. IN-S63AT5Y
D22: LED; LED_0603_1608Metric_Castellated; Mfg. Part No. SMLE13EC8TT86
D25, D26, D27, D28, D29, D30, D31, D32, D33, D34: R/Y; LED_Dialight_5988560207F; Mfg. Part No. 5988560207F
J11, J12: Conn_01x02; 2pSocket_SMD_Samtec_SMM-102-02-S-S; Mfg. Part No. SMM-102-02-S-S
Q7: MMBT3904; SOT-23; Mfg. Part No. MMBT3904
R15: 10R; R_0603_1608Metric; Mfg. Part No. ERJ-3GEYJ100V
R43, R45, R46, R47, R48, R49, R50, R51, R52, R53, R54, R55, R56, R57, R58, R59, R60, R61, R62, R63, R64: 1k5; R_0402_1005Metric; Mfg. Part No. RC0402FR-071K5L
R44: 160R; R_0402_1005Metric; Mfg. Part No. RC0402FR-07160RL
R74: 1k; R_0402_1005Metric; Mfg. Part No. RC0402JR-071KL

Connections:
+3V8: R15.2; also elsewhere on the board
/LED_1A: R45.2; also elsewhere on the board
/LED_1B: R46.2; also elsewhere on the board
/LED_2A: R47.2; also elsewhere on the board
/LED_2B: R48.2; also elsewhere on the board
/LED_3A: R49.2; also elsewhere on the board
/LED_3B: R50.2; also elsewhere on the board
/LED_4A: R51.2; also elsewhere on the board
/LED_4B: R52.2; also elsewhere on the board
/LED_5A: R53.2; also elsewhere on the board
/LED_5B: R54.2; also elsewhere on the board
/LED_6A: R55.2; also elsewhere on the board
/LED_6B: R56.2; also elsewhere on the board
/LED_7A: R57.2; also elsewhere on the board
/LED_7B: R58.2; also elsewhere on the board
/LED_8A: R59.2; also elsewhere on the board
/LED_8B: R60.2; also elsewhere on the board
/LED_9A: R61.2; also elsewhere on the board
/LED_9B: R62.2; also elsewhere on the board
/LED_10A: R63.2; also elsewhere on the board
/LED_10B: R64.2; also elsewhere on the board
/LED_FILAMENT: R74.2; also elsewhere on the board
/LED_STAT: R44.2; also elsewhere on the board
/LED_TURNINGOFF: R43.2; also elsewhere on the board
GND: D21.1 (K), D22.1 (K), D25.2 (K1), D25.4 (K2), D26.2 (K1), D26.4 (K2), D27.2 (K1), D27.4 (K2), D28.2 (K1), D28.4 (K2), D29.2 (K1), D29.4 (K2), D30.2 (K1), D30.4 (K2), D31.2 (K1), D31.4 (K2), D32.2 (K1), D32.4 (K2), D33.2 (K1), D33.4 (K2), D34.2 (K1), D34.4 (K2), Q7.2 (E); also elsewhere on the board
unnamed: D21.2 (A), R43.1
unnamed: D22.2 (A), R44.1
unnamed: D25.1 (A1), R45.1
unnamed: D25.3 (A2), R46.1
unnamed: D26.1 (A1), R47.1
unnamed: D26.3 (A2), R48.1
unnamed: D27.1 (A1), R49.1
unnamed: D27.3 (A2), R50.1
unnamed: D28.1 (A1), R51.1
unnamed: D28.3 (A2), R52.1
unnamed: D29.1 (A1), R53.1
unnamed: D29.3 (A2), R54.1
unnamed: D30.1 (A1), R55.1
unnamed: D30.3 (A2), R56.1
unnamed: D31.1 (A1), R57.1
unnamed: D31.3 (A2), R58.1
unnamed: D32.1 (A1), R59.1
unnamed: D32.3 (A2), R60.1
unnamed: D33.1 (A1), R61.1
unnamed: D33.3 (A2), R62.1
unnamed: D34.1 (A1), R63.1
unnamed: D34.3 (A2), R64.1
unnamed: J11.1, J11.2, R15.1
unnamed: J12.1, J12.2, Q7.3 (C)
unnamed: Q7.1 (B), R74.1

Notes on the sheet:
LED FILAMENT

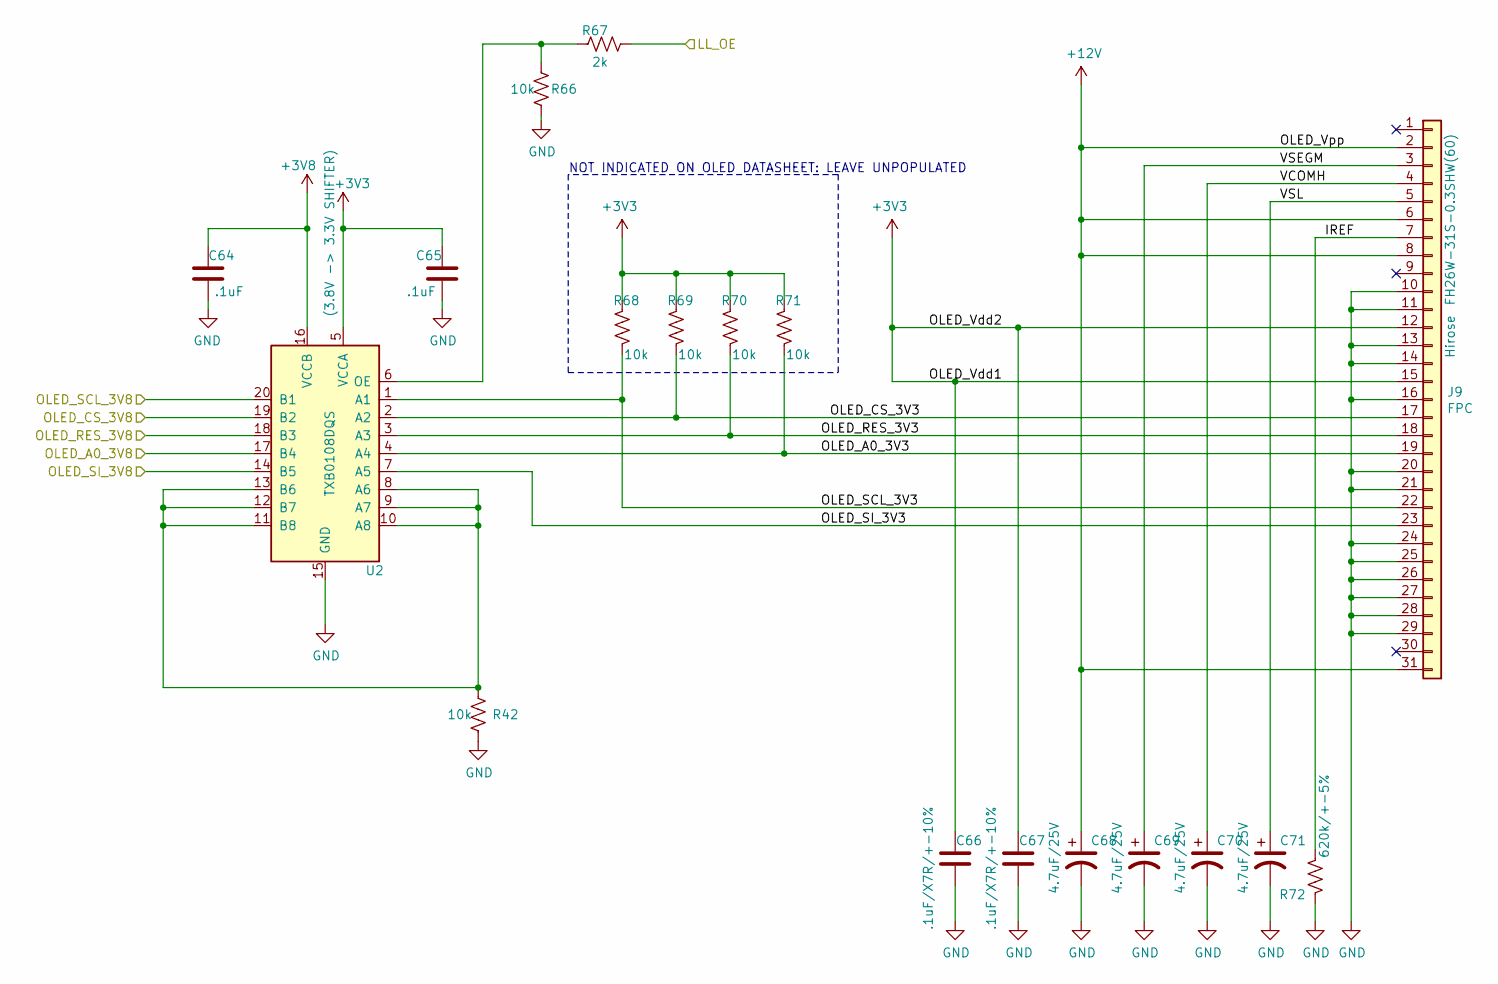
[picture p33: schematic OLEDDriver.sch, RCP OLED DRIVER]

Parts:
C64, C65: .1uF; C_0402_1005Metric; Mfg. Part No. C0402C104Z4VACTU
C66, C67: .1uF/X7R/+-10%; C_0603_1608Metric; Mfg. Part No. C0603C104K3RACTU
C68, C69, C70, C71: 4.7uF/25V; CP_Elec_4x4.5; Mfg. Part No. 865080540002
J9: FPC; Hirose_FPC_FH26W-31S-0.3SHW(60); Mfg. Part No. FH26W-31S-0.3SHW(60)
R42, R66, R68, R69, R70, R71: 10k; R_0402_1005Metric; Mfg. Part No. CRGCQ0402J10K
R67: 2k; R_0402_1005Metric; Mfg. Part No. RC0402JR-072KL
R72: 620k/+-5%; R_0603_1608Metric_Pad1.05x0.95mm_HandSolder; Mfg. Part No. RT0603FRE07620KL
U2: TXB0108DQS; USON-20_2x4mm_P0.4mm; Mfg. Part No. TXB0108DQSR

Connections:
+3V3: C65.1, C66.1, C67.1, J9.12, J9.15, R68.1, R69.1, R70.1, R71.1, U2.5 (VCCA); also elsewhere on the board
+3V8: C64.1, U2.16 (VCCB); also elsewhere on the board
+12V: C68.1, J9.2, J9.6, J9.8, J9.31; also elsewhere on the board
/MOSI: U2.14 (B5); also elsewhere on the board
/OLED DRIVER/IREF: J9.7, R72.1
/OLED DRIVER/OLED_A0_3V3: J9.19, R71.2, U2.4 (A4)
/OLED DRIVER/OLED_CS_3V3: J9.17, R69.2, U2.2 (A2)
/OLED DRIVER/OLED_RES_3V3: J9.18, R70.2, U2.3 (A3)
/OLED DRIVER/OLED_SCL_3V3: J9.22, R68.2, U2.1 (A1)
/OLED DRIVER/OLED_SI_3V3: J9.23, U2.7 (A5)
/OLED DRIVER/VCOMH: C70.1, J9.4
/OLED DRIVER/VSEGM: C69.1, J9.3
/OLED DRIVER/VSL: C71.1, J9.5
/OLED_AO: U2.17 (B4); also elsewhere on the board
/OLED_CS: U2.19 (B2); also elsewhere on the board
/OLED_XRES: U2.18 (B3); also elsewhere on the board
/SCK: U2.20 (B1); also elsewhere on the board
GND: C64.2, C65.2, C66.2, C67.2, C68.2, C69.2, C70.2, C71.2, J9.10, J9.11, J9.13, J9.14, J9.16, J9.20, J9.21, J9.24, J9.25, J9.26, J9.27, J9.28, J9.29, R42.2, R66.2, R72.2, U2.15 (GND); also elsewhere on the board
LL_OE: R67.2; also elsewhere on the board
unnamed: R42.1, U2.8 (A6), U2.9 (A7), U2.10 (A8), U2.11 (B8), U2.12 (B7), U2.13 (B6)
unnamed: R66.1, R67.1, U2.6 (OE)

Notes on the sheet:
NOT INDICATED ON OLED DATASHEET: LEAVE UNPOPULATED

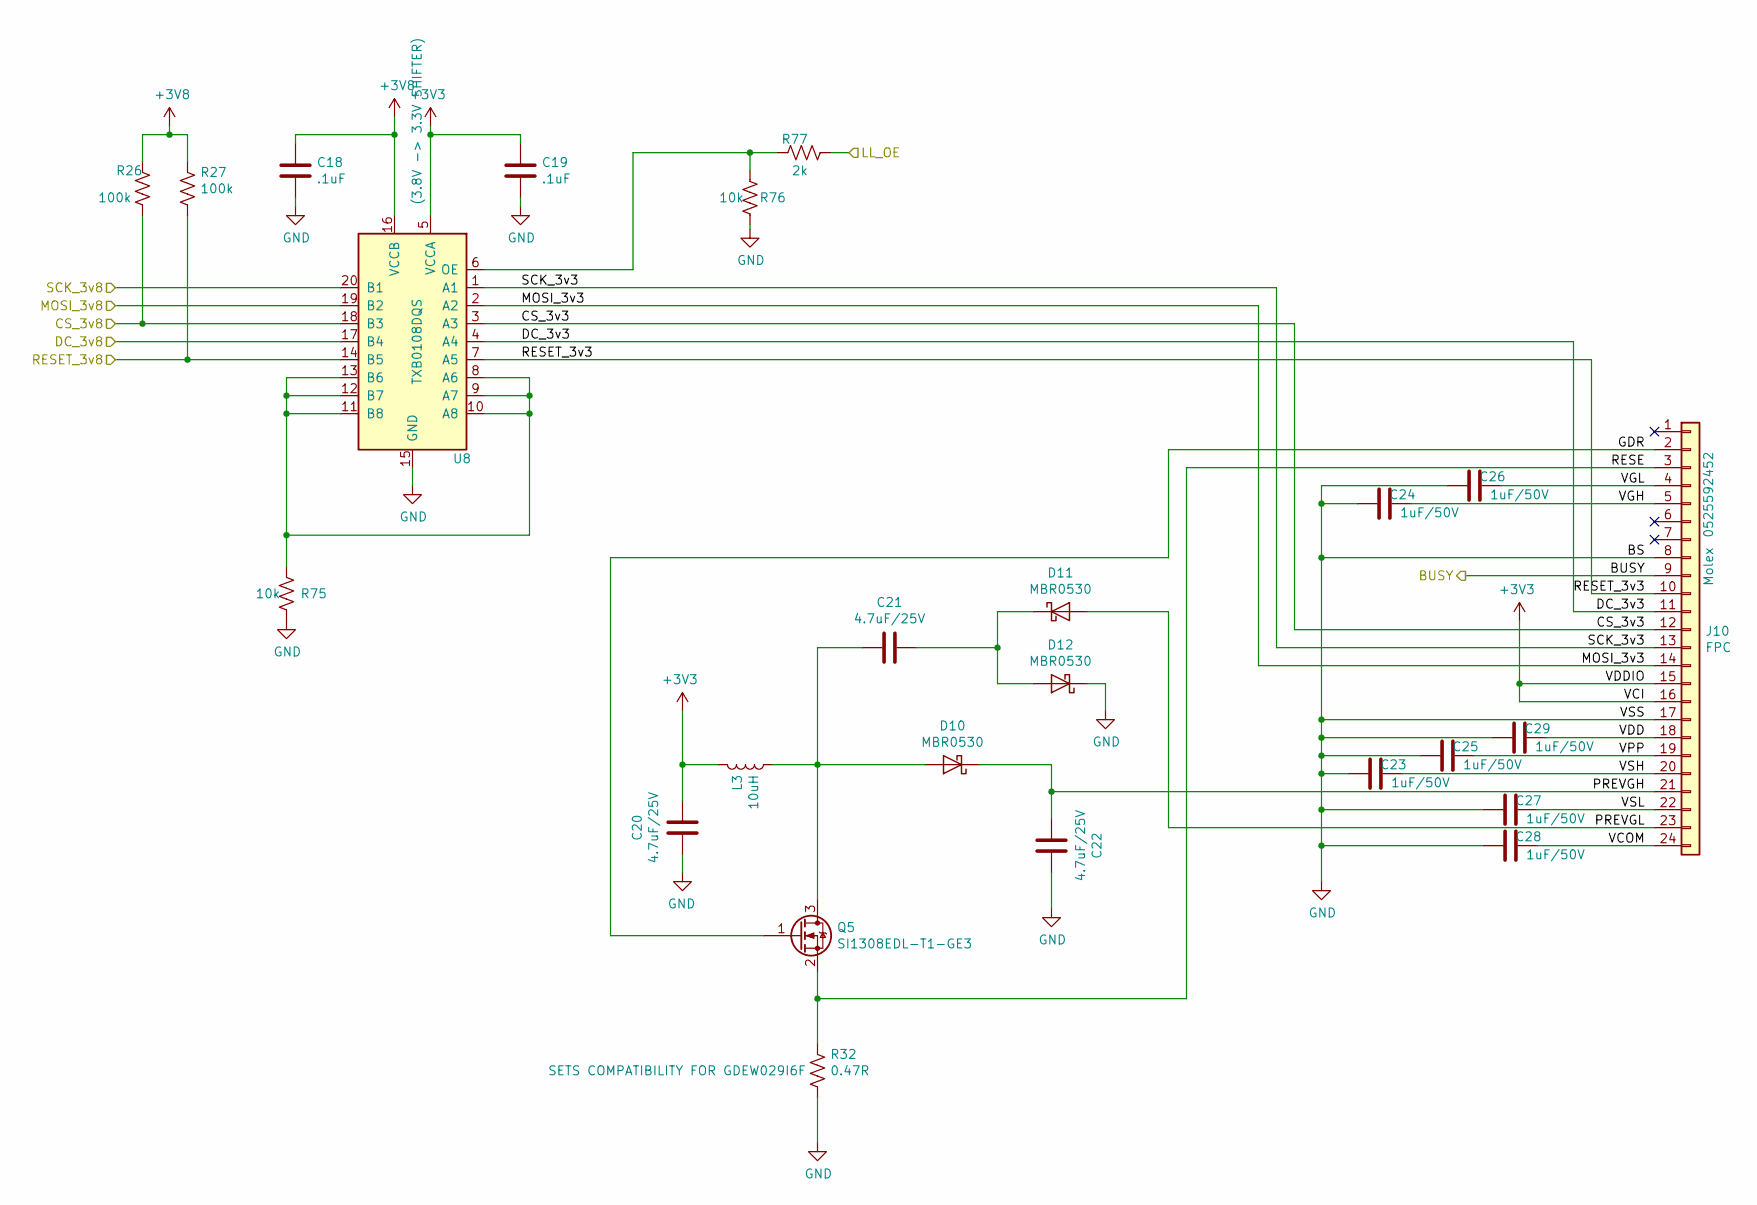
[picture p34: schematic ePaperDriver.sch, RCP EPAPER DRIVER]

Parts:
C18, C19: .1uF; C_0402_1005Metric; Mfg. Part No. C0402C104Z4VACTU
C20, C21, C22: 4.7uF/25V; C_0805_2012Metric; Mfg. Part No. CL21A475KBQNNNE
C23, C24, C25, C26, C27, C28, C29: 1uF/50V; C_0805_2012Metric; Mfg. Part No. CC0805KKX7R9BB105
D10, D11, D12: MBR0530; D_SOD-123; Mfg. Part No. MBR0530
J10: FPC; Molex_24pFPC_Vert_0525592452; Mfg. Part No. 0525592452
L3: 10uH; Inductor10uH_Wurth_744053100; Mfg. Part No. 744053100
Q5: NMOS; SOT-323_SC-70; Mfg. Part No. SI1308EDL-T1-GE3
R26, R27: 100k; R_0402_1005Metric; Mfg. Part No. RC0402FR-07100KL
R32: 0.47R; R_0402_1005Metric; Mfg. Part No. ERJ-2BQJR47X
R75, R76: 10k; R_0402_1005Metric; Mfg. Part No. CRGCQ0402J10K
R77: 2k; R_0402_1005Metric; Mfg. Part No. RC0402JR-072KL
U8: TXB0108DQS; USON-20_2x4mm_P0.4mm; Mfg. Part No. TXB0108DQSR

Connections:
+3V3: C19.1, C20.2, J10.15, J10.16, L3.1, U8.5 (VCCA); also elsewhere on the board
+3V8: C18.1, R26.1, R27.1, U8.16 (VCCB); also elsewhere on the board
/EPD_BUSY: J10.9; also elsewhere on the board
/EPD_CS: R26.2, U8.18 (B3); also elsewhere on the board
/EPD_DC: U8.17 (B4); also elsewhere on the board
/EPD_RESET: R27.2, U8.14 (B5); also elsewhere on the board
/MOSI: U8.19 (B2); also elsewhere on the board
/SCK: U8.20 (B1); also elsewhere on the board
/ePaper Driver/CS_3v3: J10.12, U8.3 (A3)
/ePaper Driver/DC_3v3: J10.11, U8.4 (A4)
/ePaper Driver/GDR: J10.2, Q5.1 (G)
/ePaper Driver/MOSI_3v3: J10.14, U8.2 (A2)
/ePaper Driver/PREVGH: C22.2, D10.1 (K), J10.21
/ePaper Driver/PREVGL: D11.2 (A), J10.23
/ePaper Driver/RESE: J10.3, Q5.2 (S), R32.1
/ePaper Driver/RESET_3v3: J10.10, U8.7 (A5)
/ePaper Driver/SCK_3v3: J10.13, U8.1 (A1)
/ePaper Driver/VCOM: C28.1, J10.24
/ePaper Driver/VDD: C29.1, J10.18
/ePaper Driver/VGH: C24.1, J10.5
/ePaper Driver/VGL: C26.1, J10.4
/ePaper Driver/VPP: C25.1, J10.19
/ePaper Driver/VSH: C23.1, J10.20
/ePaper Driver/VSL: C27.1, J10.22
GND: C18.2, C19.2, C20.1, C22.1, C23.2, C24.2, C25.2, C26.2, C27.2, C28.2, C29.2, D12.1 (K), J10.8, J10.17, R32.2, R75.2, R76.2, U8.15 (GND); also elsewhere on the board
LL_OE: R77.2; also elsewhere on the board
unnamed: C21.1, D11.1 (K), D12.2 (A)
unnamed: C21.2, D10.2 (A), L3.2, Q5.3 (D)
unnamed: R75.1, U8.8 (A6), U8.9 (A7), U8.10 (A8), U8.11 (B8), U8.12 (B7), U8.13 (B6)
unnamed: R76.1, R77.1, U8.6 (OE)

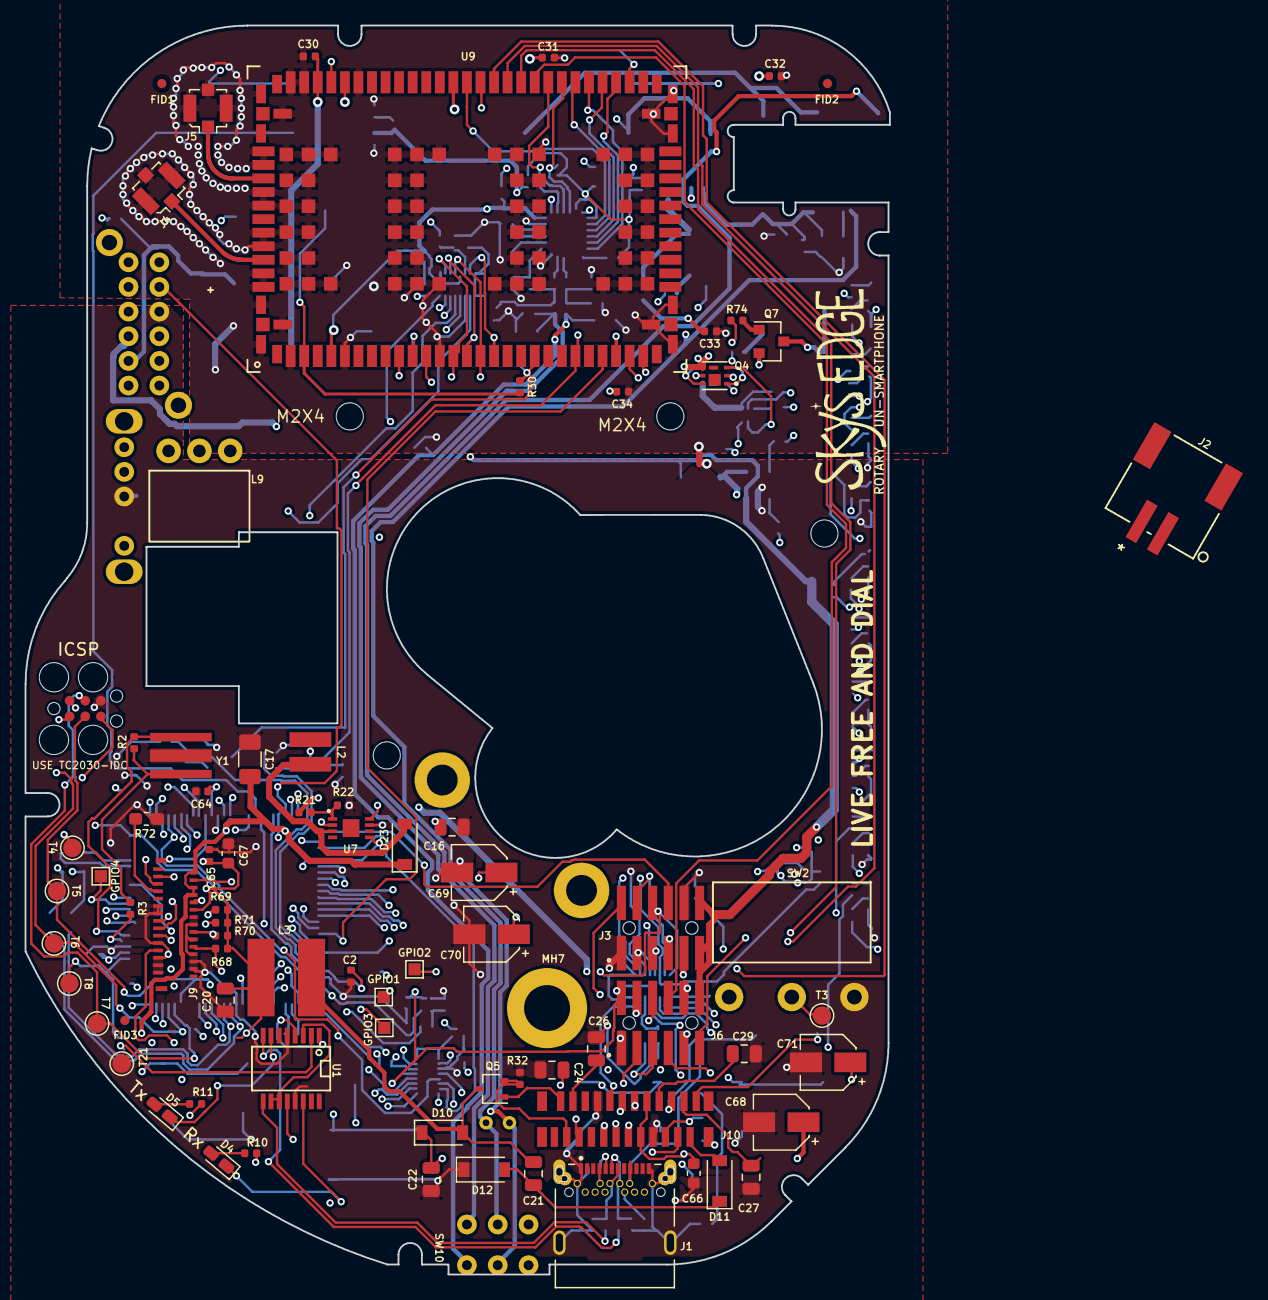
[picture p35: board RUSP_Mainboard.kicad_pcb from above]

Board: 6 copper layers, 70.1 x 101.3 mm, 259 parts (0 on the bottom side), 222 nets.
