skysedge/RUST_Hardware/Bak/Antenna_Molex/RUSP_Antenna.kicad_pcb

## KiCad design Bak/Antenna_Molex/RUSP_Antenna.kicad_pcb (2024-06-24)

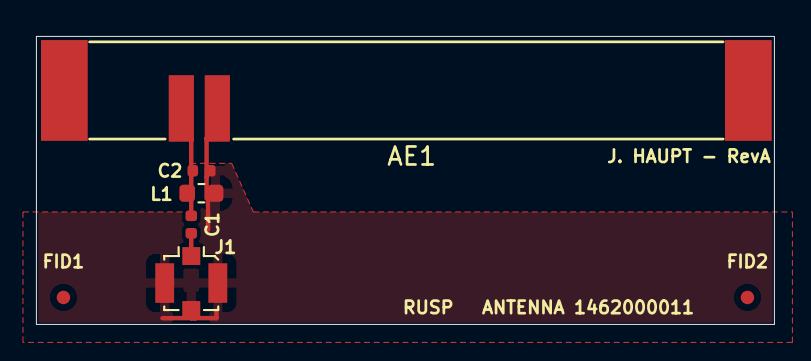
[picture p36: board RUSP_Antenna.kicad_pcb from above]

Board: 2 copper layers, 41.0 x 16.0 mm, 7 parts (0 on the bottom side), 3 nets.

Parts:
AE1: Antenna_Chip; Antenna_Molex_1462000011
C1: 2.7pF; C_0402_1005Metric
C2: .5pF; C_0402_1005Metric
FID1, FID2: Fiducial; Fiducial_0.75mm_Dia_1.5mm_Outer
J1: uFL; U.FL_Molex_MCRF_73412-0110_Vertical
L1: 7.5nH; L_0603_1608Metric

Connections:
GNDA: AE1.2, C2.2, J1.2, L1.2
unnamed: AE1.1, C1.1, C2.1, L1.1
unnamed: C1.2, J1.1
