skysedge/RUST_Hardware/Bak/081320/RotaryCellPhone-4G.kicad_pcb

## KiCad design Bak/081320/RotaryCellPhone-4G.kicad_pcb (2024-06-24)

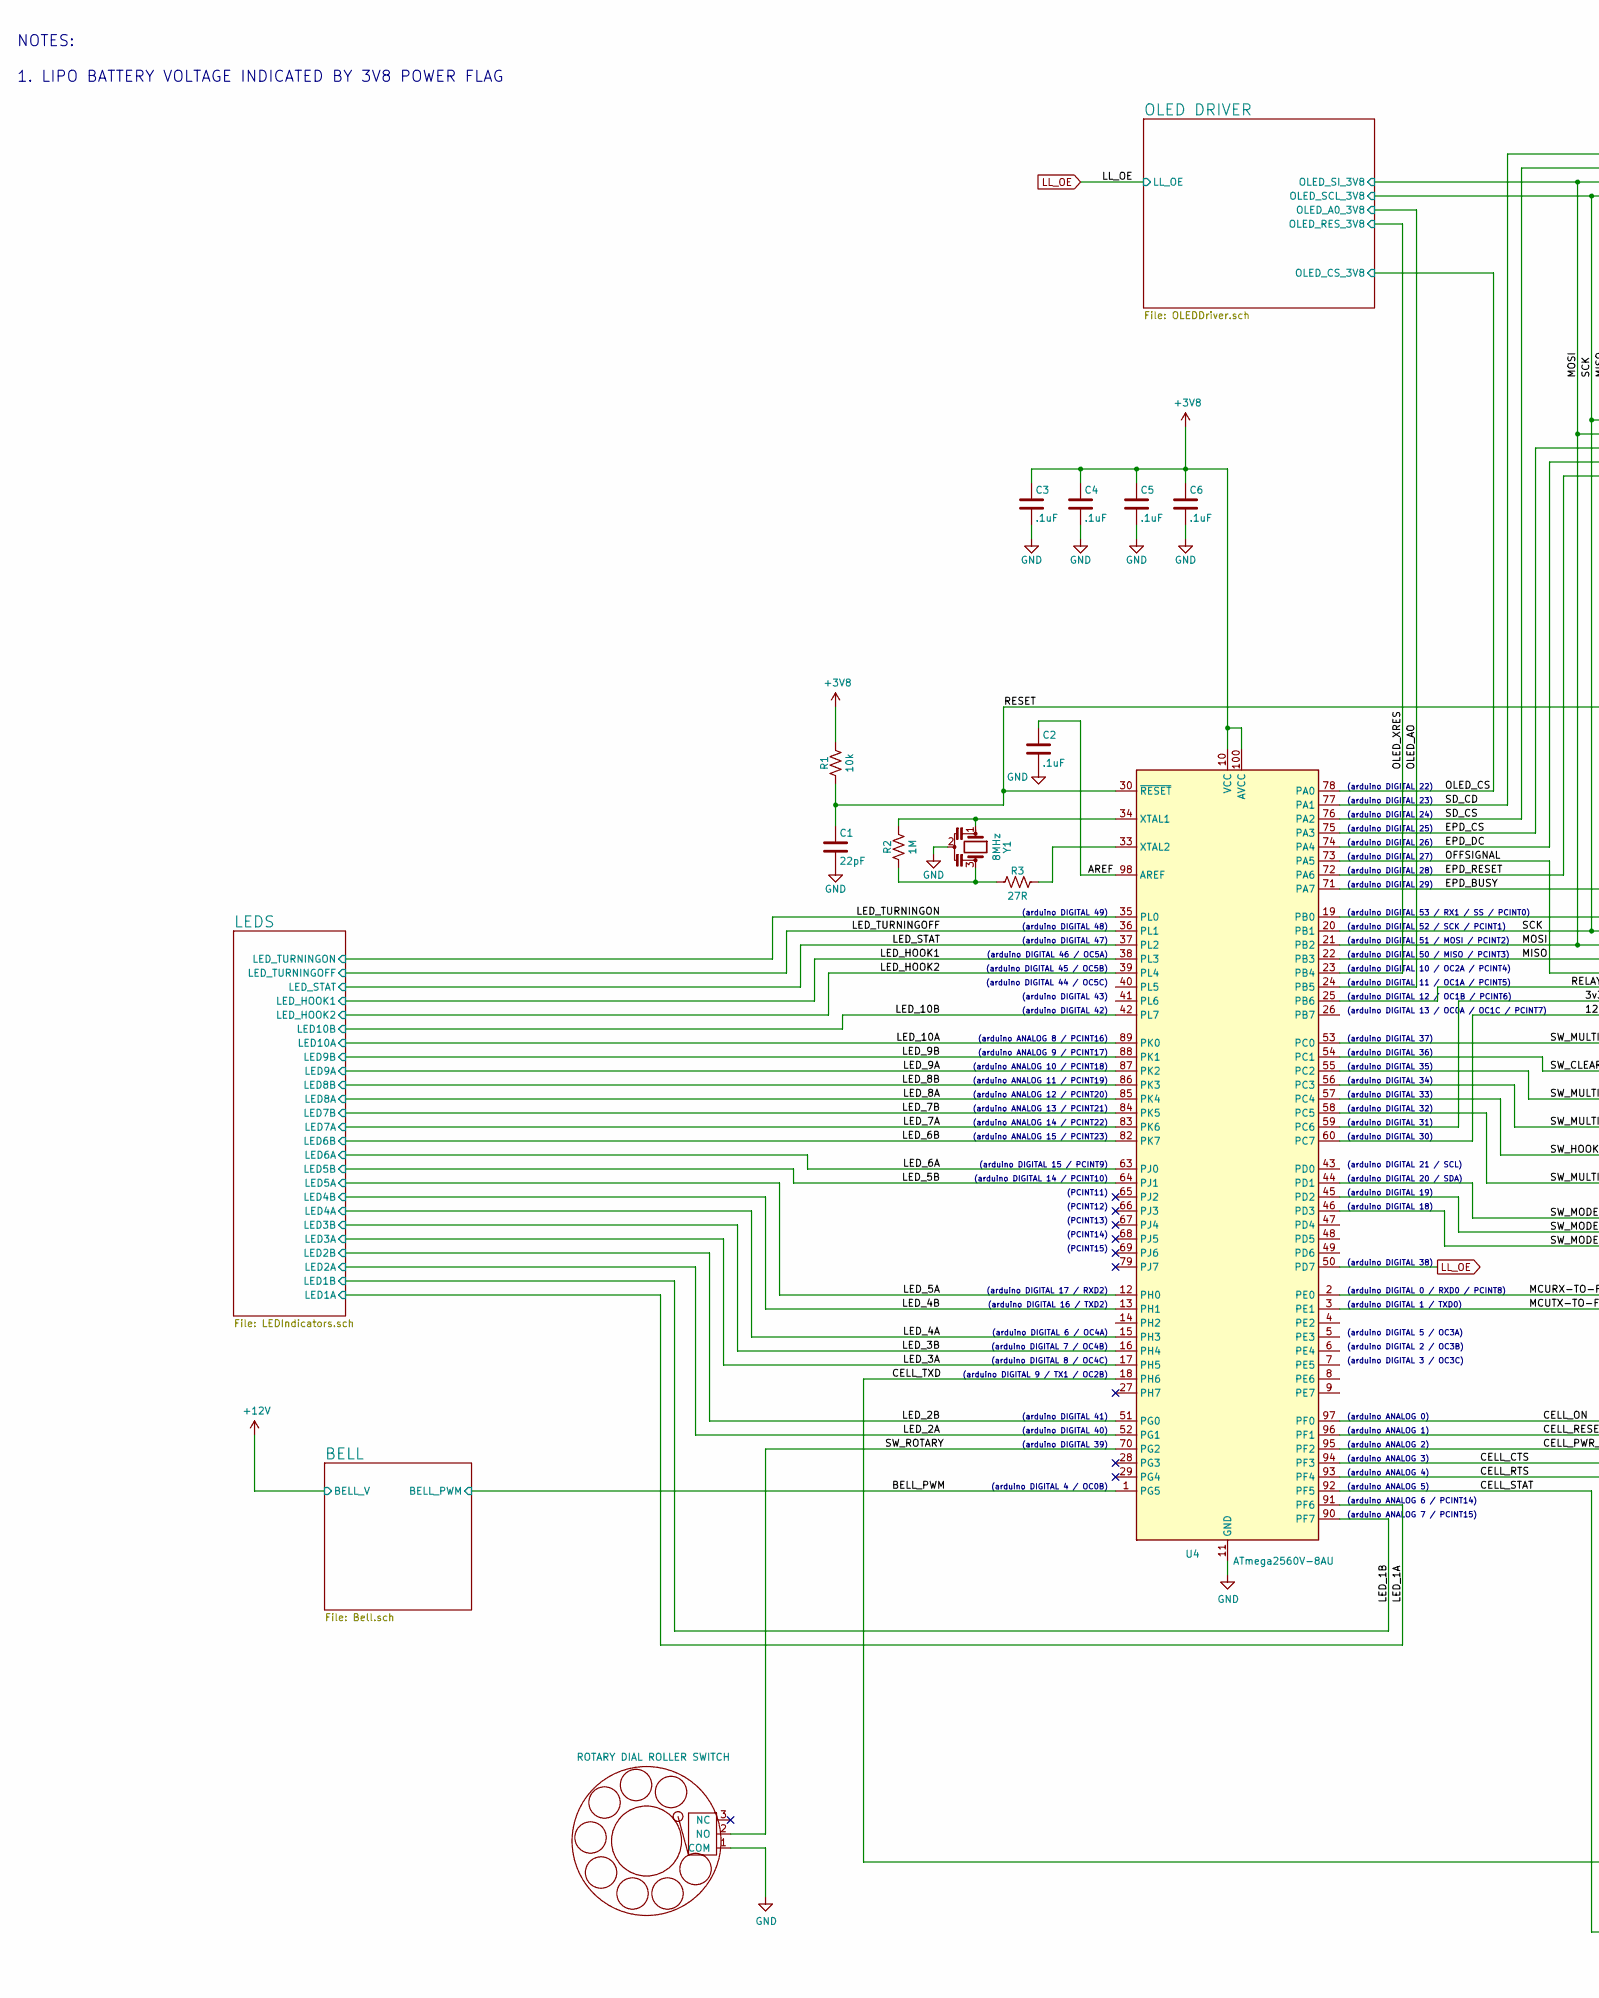
[picture p37: schematic RotaryCellPhone-4G.sch, ROTARY-DIAL CELLPHONE, part in row 1, column 1]

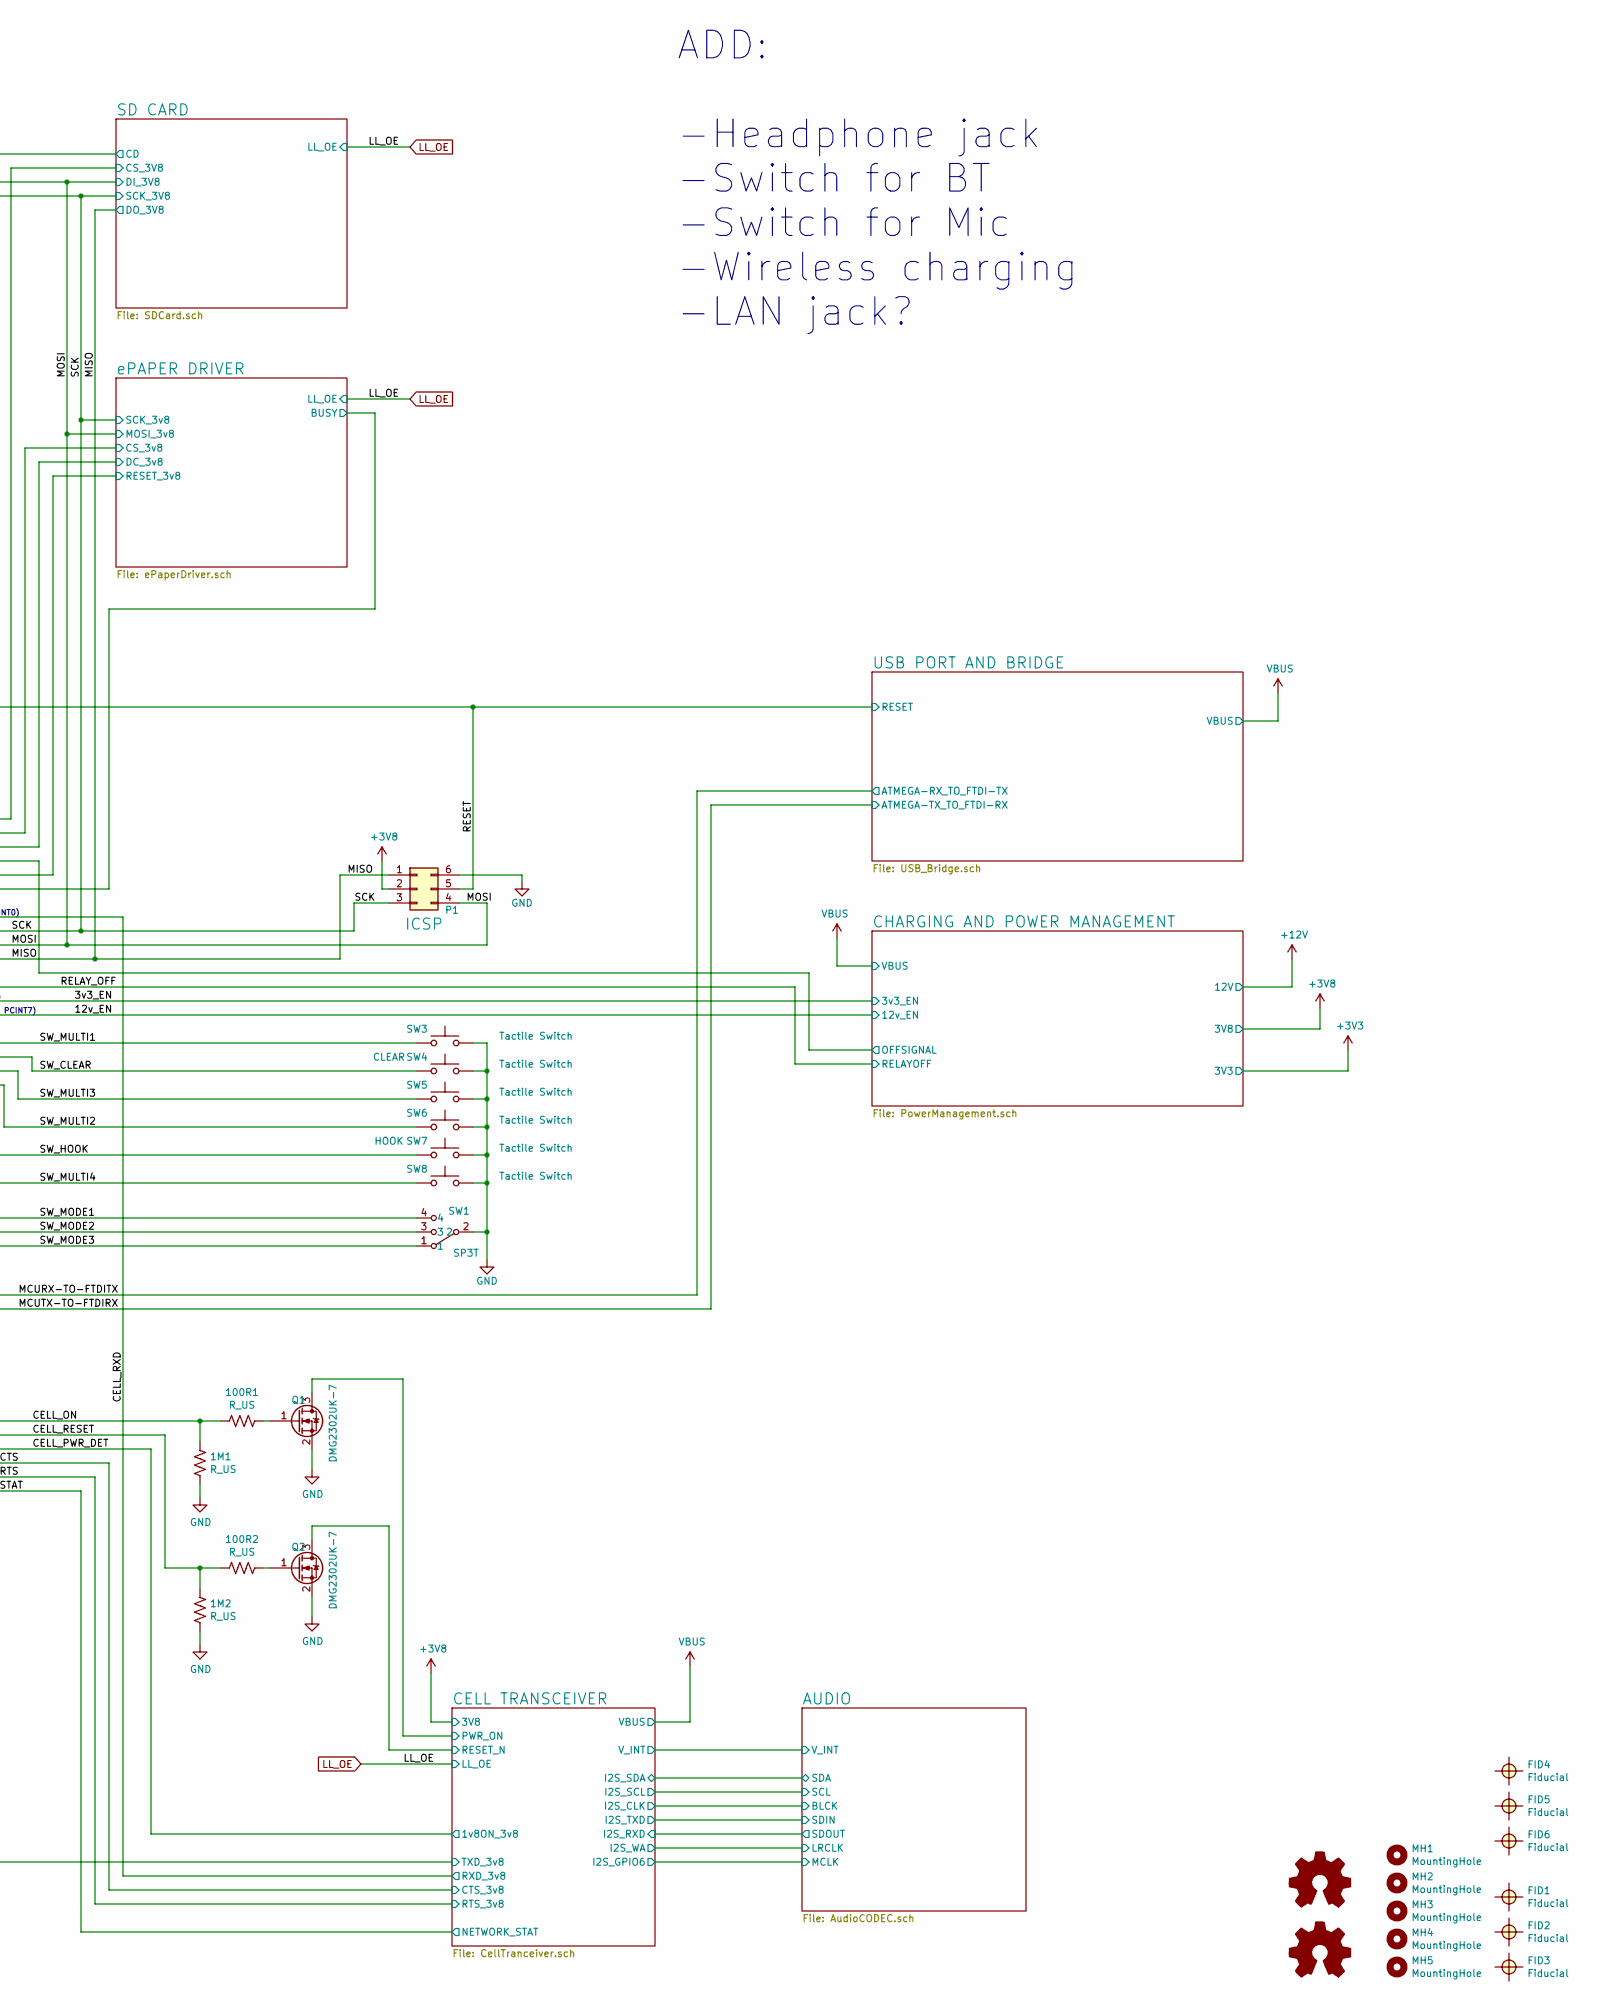
[picture p38: schematic RotaryCellPhone-4G.sch, ROTARY-DIAL CELLPHONE, part in row 1, column 2]

Parts:
1M1, 1M2, 100R1, 100R2: R_US; R_0402_1005Metric
C1: 22pF; C_0402_1005Metric
C2, C3, C4, C5, C6: .1uF; C_0402_1005Metric
FID1, FID2, FID3, FID4, FID5, FID6: Fiducial; Fiducial_0.75mm_Dia_1.5mm_Outer
LOGO1: Logo1; SkysEdge_21mm
LOGO2: Logo2; SkysEdge_18mm
MH1, MH2, MH3, MH4, MH5: MountingHole; MountingHole_2.5mm
P1: ICSP; ICSP_Header; Mfg. Part No. 75869-131LF
Q1, Q2: DMG2302UK-7; SOT-23; Mfg. Part No. DMG2302UK-7
R1: 10k; R_0402_1005Metric; Mfg. Part No. RNCP0603FTD10K0
R2: 1M; R_0402_1005Metric
R3: 27R; R_0402_1005Metric
SW1: SP3T; SP3T_OS103011MA7QP1; Mfg. Part No. OS103011MA7QP1
SW3, SW4, SW5, SW6, SW7, SW8: Tactile Switch; SW_SPST_B3S-1000; Mfg. Part No. PTS645SM43SMTR92 LFS
U2: ROTARY DIAL ROLLER SWITCH; LimitSwitch_D2F-01FL2-A1; Mfg. Part No. D2F-01FL2-A1
U4: ATmega2560V-8AU; TQFP-100_14x14mm_P0.5mm; Mfg. Part No. ATMEGA2560V-8AUR
Y1: 8MHz; AWSCR-16.00CV-T; Mfg. Part No. AWSCR-8.00CV-T

Connections:
+3V8: C3.1, C4.1, C5.1, C6.1, P1.2, R1.2, U4.10 (VCC), U4.31 (VCC), U4.61 (VCC), U4.80 (VCC), U4.100 (AVCC); also elsewhere on the board
/3v3_EN: U4.59 (PC6); also elsewhere on the board
/12v_EN: U4.60 (PC7); also elsewhere on the board
/AREF: C2.1, U4.98 (AREF)
/BELL_PWM: U4.1 (PG5); also elsewhere on the board
/CELL TRANSCEIVER/PWR_ON: Q1.3 (D); also elsewhere on the board
/CELL TRANSCEIVER/RESET_N: Q2.3 (D); also elsewhere on the board
/CELL_CTS: U4.94 (PF3); also elsewhere on the board
/CELL_ON: 1M1.1, 100R1.2, U4.97 (PF0)
/CELL_PWR_DET: U4.95 (PF2); also elsewhere on the board
/CELL_RESET: 1M2.1, 100R2.2, U4.96 (PF1)
/CELL_RTS: U4.93 (PF4); also elsewhere on the board
/CELL_RXD: U4.19 (PB0); also elsewhere on the board
/CELL_STAT: U4.92 (PF5); also elsewhere on the board
/CELL_TXD: U4.18 (PH6); also elsewhere on the board
/EPD_BUSY: U4.71 (PA7); also elsewhere on the board
/EPD_CS: U4.75 (PA3); also elsewhere on the board
/EPD_DC: U4.74 (PA4); also elsewhere on the board
/EPD_RESET: U4.72 (PA6); also elsewhere on the board
/LED_1A: U4.91 (PF6); also elsewhere on the board
/LED_1B: U4.90 (PF7); also elsewhere on the board
/LED_2A: U4.52 (PG1); also elsewhere on the board
/LED_2B: U4.51 (PG0); also elsewhere on the board
/LED_3A: U4.17 (PH5); also elsewhere on the board
/LED_3B: U4.16 (PH4); also elsewhere on the board
/LED_4A: U4.15 (PH3); also elsewhere on the board
/LED_4B: U4.13 (PH1); also elsewhere on the board
/LED_5A: U4.12 (PH0); also elsewhere on the board
/LED_5B: U4.64 (PJ1); also elsewhere on the board
/LED_6A: U4.63 (PJ0); also elsewhere on the board
/LED_6B: U4.82 (PK7); also elsewhere on the board
/LED_7A: U4.83 (PK6); also elsewhere on the board
/LED_7B: U4.84 (PK5); also elsewhere on the board
/LED_8A: U4.85 (PK4); also elsewhere on the board
/LED_8B: U4.86 (PK3); also elsewhere on the board
/LED_9A: U4.87 (PK2); also elsewhere on the board
/LED_9B: U4.88 (PK1); also elsewhere on the board
/LED_10A: U4.89 (PK0); also elsewhere on the board
/LED_10B: U4.42 (PL7); also elsewhere on the board
/LED_HOOK1: U4.38 (PL3); also elsewhere on the board
/LED_HOOK2: U4.39 (PL4); also elsewhere on the board
/LED_STAT: U4.37 (PL2); also elsewhere on the board
/LED_TURNINGOFF: U4.36 (PL1); also elsewhere on the board
/LED_TURNINGON: U4.35 (PL0); also elsewhere on the board
/MCURX-TO-FTDITX: U4.2 (PE0); also elsewhere on the board
/MCUTX-TO-FTDIRX: U4.3 (PE1); also elsewhere on the board
/MISO: P1.1, U4.22 (PB3); also elsewhere on the board
/MOSI: P1.4, U4.21 (PB2); also elsewhere on the board
/OFFSIGNAL: U4.73 (PA5); also elsewhere on the board
/OLED_AO: U4.24 (PB5); also elsewhere on the board
/OLED_CS: U4.78 (PA0); also elsewhere on the board
/OLED_XRES: U4.23 (PB4); also elsewhere on the board
/RELAY_OFF: U4.25 (PB6); also elsewhere on the board
/RESET: C1.1, P1.5, R1.1, U4.30 (~RESET); also elsewhere on the board
/SCK: P1.3, U4.20 (PB1); also elsewhere on the board
/SD_CD: U4.77 (PA1); also elsewhere on the board
/SD_CS: U4.76 (PA2); also elsewhere on the board
/SW_CLEAR: SW4.1, U4.54 (PC1)
/SW_HOOK: SW7.1, U4.57 (PC4)
/SW_MODE1: SW1.4, U4.44 (PD1)
/SW_MODE2: SW1.3, U4.45 (PD2)
/SW_MODE3: SW1.1, U4.46 (PD3)
/SW_MULTI1: SW3.1, U4.53 (PC0)
/SW_MULTI2: SW6.1, U4.56 (PC3)
/SW_MULTI3: SW5.1, U4.55 (PC2)
/SW_MULTI4: SW8.1, U4.58 (PC5)
/SW_ROTARY: U2.2 (NO), U4.70 (PG2)
GND: 1M1.2, 1M2.2, C1.2, C2.2, C3.2, C4.2, C5.2, C6.2, P1.6, Q1.2 (S), Q2.2 (S), SW1.2, SW3.2, SW4.2, SW5.2, SW6.2, SW7.2, SW8.2, U2.1 (COM), U4.11 (GND), U4.32 (GND), U4.62 (GND), U4.81 (GND), U4.99 (GND), Y1.2; also elsewhere on the board
LL_OE: U4.50 (PD7); also elsewhere on the board
unnamed: 100R1.1, Q1.1 (G)
unnamed: 100R2.1, Q2.1 (G)
unnamed: R2.1, R3.1, Y1.3
unnamed: R2.2, U4.34 (XTAL1), Y1.1
unnamed: R3.2, U4.33 (XTAL2)

Notes on the sheet:
(arduino DIGITAL 1 / TXD0)
(arduino DIGITAL 0 / RXD0 / PCINT8)
(arduino DIGITAL 7 / OC4B)
(arduino DIGITAL 8 / OC4C)
(arduino DIGITAL 45 / OC5B)
(arduino DIGITAL 46 / OC5A)
(arduino ANALOG 0)
(arduino DIGITAL 52 / SCK / PCINT1)
(arduino DIGITAL 13 / OC0A / OC1C / PCINT7)
(arduino DIGITAL 20 / SDA)
(arduino DIGITAL 21 / SCL)
(arduino DIGITAL 51 / MOSI / PCINT2)
(arduino DIGITAL 50 / MISO / PCINT3)
(arduino DIGITAL 17 / RXD2)
(arduino DIGITAL 14 / PCINT10)
(arduino DIGITAL 25)
(arduino DIGITAL 26)
(arduino ANALOG 3)
(arduino DIGITAL 24)
(arduino DIGITAL 27)
(arduino DIGITAL 3 / OC3C)
(arduino DIGITAL 16 / TXD2)
(arduino DIGITAL 53 / RX1 / SS / PCINT0)
(arduino DIGITAL 47)
(arduino DIGITAL 48)
(arduino DIGITAL 49)
(arduino DIGITAL 6 / OC4A)
(arduino DIGITAL 44 / OC5C)
(arduino DIGITAL 2 / OC3B)
(arduino DIGITAL 9 / TX1 / OC2B)
(arduino DIGITAL 19)
(arduino DIGITAL 18)
(arduino DIGITAL 38)
(arduino DIGITAL 5 / OC3A)
(arduino DIGITAL 28)
(arduino DIGITAL 43)
(arduino ANALOG 15 / PCINT23)
(PCINT15)
(PCINT14)
(arduino DIGITAL 23)
(arduino DIGITAL 22)
(arduino DIGITAL 29)
(arduino DIGITAL 10 / OC2A / PCINT4)
(arduino DIGITAL 11 / OC1A / PCINT5)
(arduino DIGITAL 12 / OC1B / PCINT6)
(arduino DIGITAL 39)
(arduino DIGITAL 4 / OC0B)
(arduino DIGITAL 42)
(arduino DIGITAL 41)
(arduino DIGITAL 40)
(arduino DIGITAL 37)
(arduino DIGITAL 36)
(arduino DIGITAL 35)
(arduino DIGITAL 34)
(arduino DIGITAL 33)
(arduino DIGITAL 32)
(arduino DIGITAL 31)
(arduino DIGITAL 30)
(arduino DIGITAL 15 / PCINT9)
(PCINT11)
(PCINT12)
(PCINT13)
(arduino ANALOG 14 / PCINT22)
(arduino ANALOG 13 / PCINT21)
(arduino ANALOG 12 / PCINT20)
(arduino ANALOG 11 / PCINT19)
(arduino ANALOG 10 / PCINT18)
(arduino ANALOG 9 / PCINT17)
(arduino ANALOG 8 / PCINT16)
(arduino ANALOG 7 / PCINT15)
(arduino ANALOG 6 / PCINT14)
(arduino ANALOG 1)
(arduino ANALOG 2)
(arduino ANALOG 4)
(arduino ANALOG 5)
NOTES: 1. LIPO BATTERY VOLTAGE INDICATED BY 3V8 POWER FLAG
ADD: -Headphone jack -Switch for BT -Switch for Mic -Wireless charging -LAN jack?

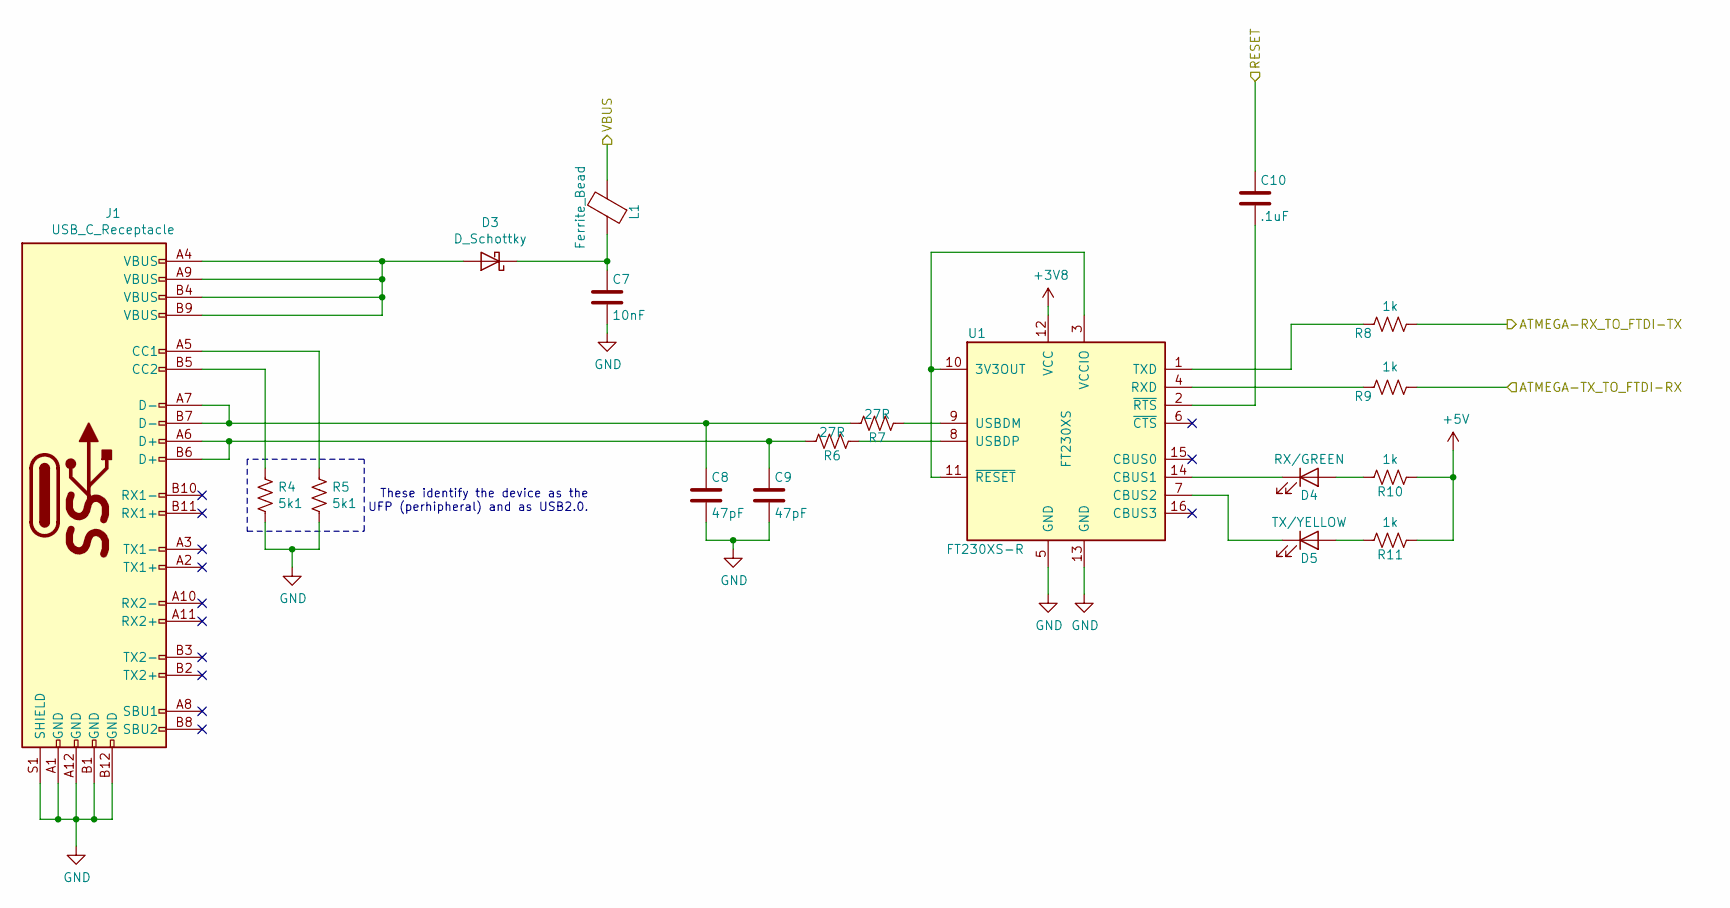
[picture p39: schematic USB_Bridge.sch, RCP USB PORT & BRIDGE]

Parts:
C7: 10nF; C_0402_1005Metric
C8, C9: 47pF; C_0402_1005Metric
C10: .1uF; C_0402_1005Metric
D3: D_Schottky; D_SOD-123; Mfg. Part No. MBR130T3G
D4: RX/GREEN; LED_0603_1608Metric_Castellated; Mfg. Part No. LT Q39G-Q1OO-25-1
D5: TX/YELLOW; LED_0603_1608Metric_Castellated; Mfg. Part No. IN-S63AT5Y
J1: USB_C_Receptacle; CUI_UJ31-CH-G1-SMT-TR; Mfg. Part No. UJ31-CH-G1-SMT-TR
L1: Ferrite_Bead; R_0805_2012Metric_Pad1.15x1.40mm_HandSolder; Mfg. Part No. MI0805K601R-10
R4, R5: 5k1; R_0402_1005Metric
R6, R7: 27R; R_0402_1005Metric
R8, R9, R10, R11: 1k; R_0402_1005Metric
U1: FT230XS; SSOP-16; Mfg. Part No. FT230XS-R

Connections:
+3V8: U1.12 (VCC); also elsewhere on the board
+5V: R10.1, R11.1
/MCURX-TO-FTDITX: R8.2; also elsewhere on the board
/MCUTX-TO-FTDIRX: R9.1; also elsewhere on the board
/RESET: C10.1; also elsewhere on the board
GND: C7.2, C8.2, C9.2, J1.A1 (GND), J1.A12 (GND), J1.B1 (GND), J1.B12 (GND), J1.S1 (SHIELD), R4.2, R5.2, U1.5 (GND), U1.13 (GND); also elsewhere on the board
unnamed: C7.1, D3.1 (K), L1.1
unnamed: C8.1, J1.A7 (D-), J1.B7 (D-), R7.2
unnamed: C9.1, J1.A6 (D+), J1.B6 (D+), R6.2
unnamed: C10.2, U1.2 (~RTS)
unnamed: D3.2 (A), J1.A4 (VBUS), J1.A9 (VBUS), J1.B4 (VBUS), J1.B9 (VBUS)
unnamed: D4.1 (K), U1.14 (CBUS1)
unnamed: D4.2 (A), R10.2
unnamed: D5.1 (K), U1.7 (CBUS2)
unnamed: D5.2 (A), R11.2
unnamed: J1.A5 (CC1), R5.1
unnamed: J1.B5 (CC2), R4.1
unnamed: R6.1, U1.8 (USBDP)
unnamed: R7.1, U1.9 (USBDM)
unnamed: R8.1, U1.1 (TXD)
unnamed: R9.2, U1.4 (RXD)
unnamed: U1.3 (VCCIO), U1.10 (3V3OUT), U1.11 (~RESET)
VBUS: L1.2; also elsewhere on the board

Notes on the sheet:
These identify the device as the UFP (perhipheral) and as USB2.0.

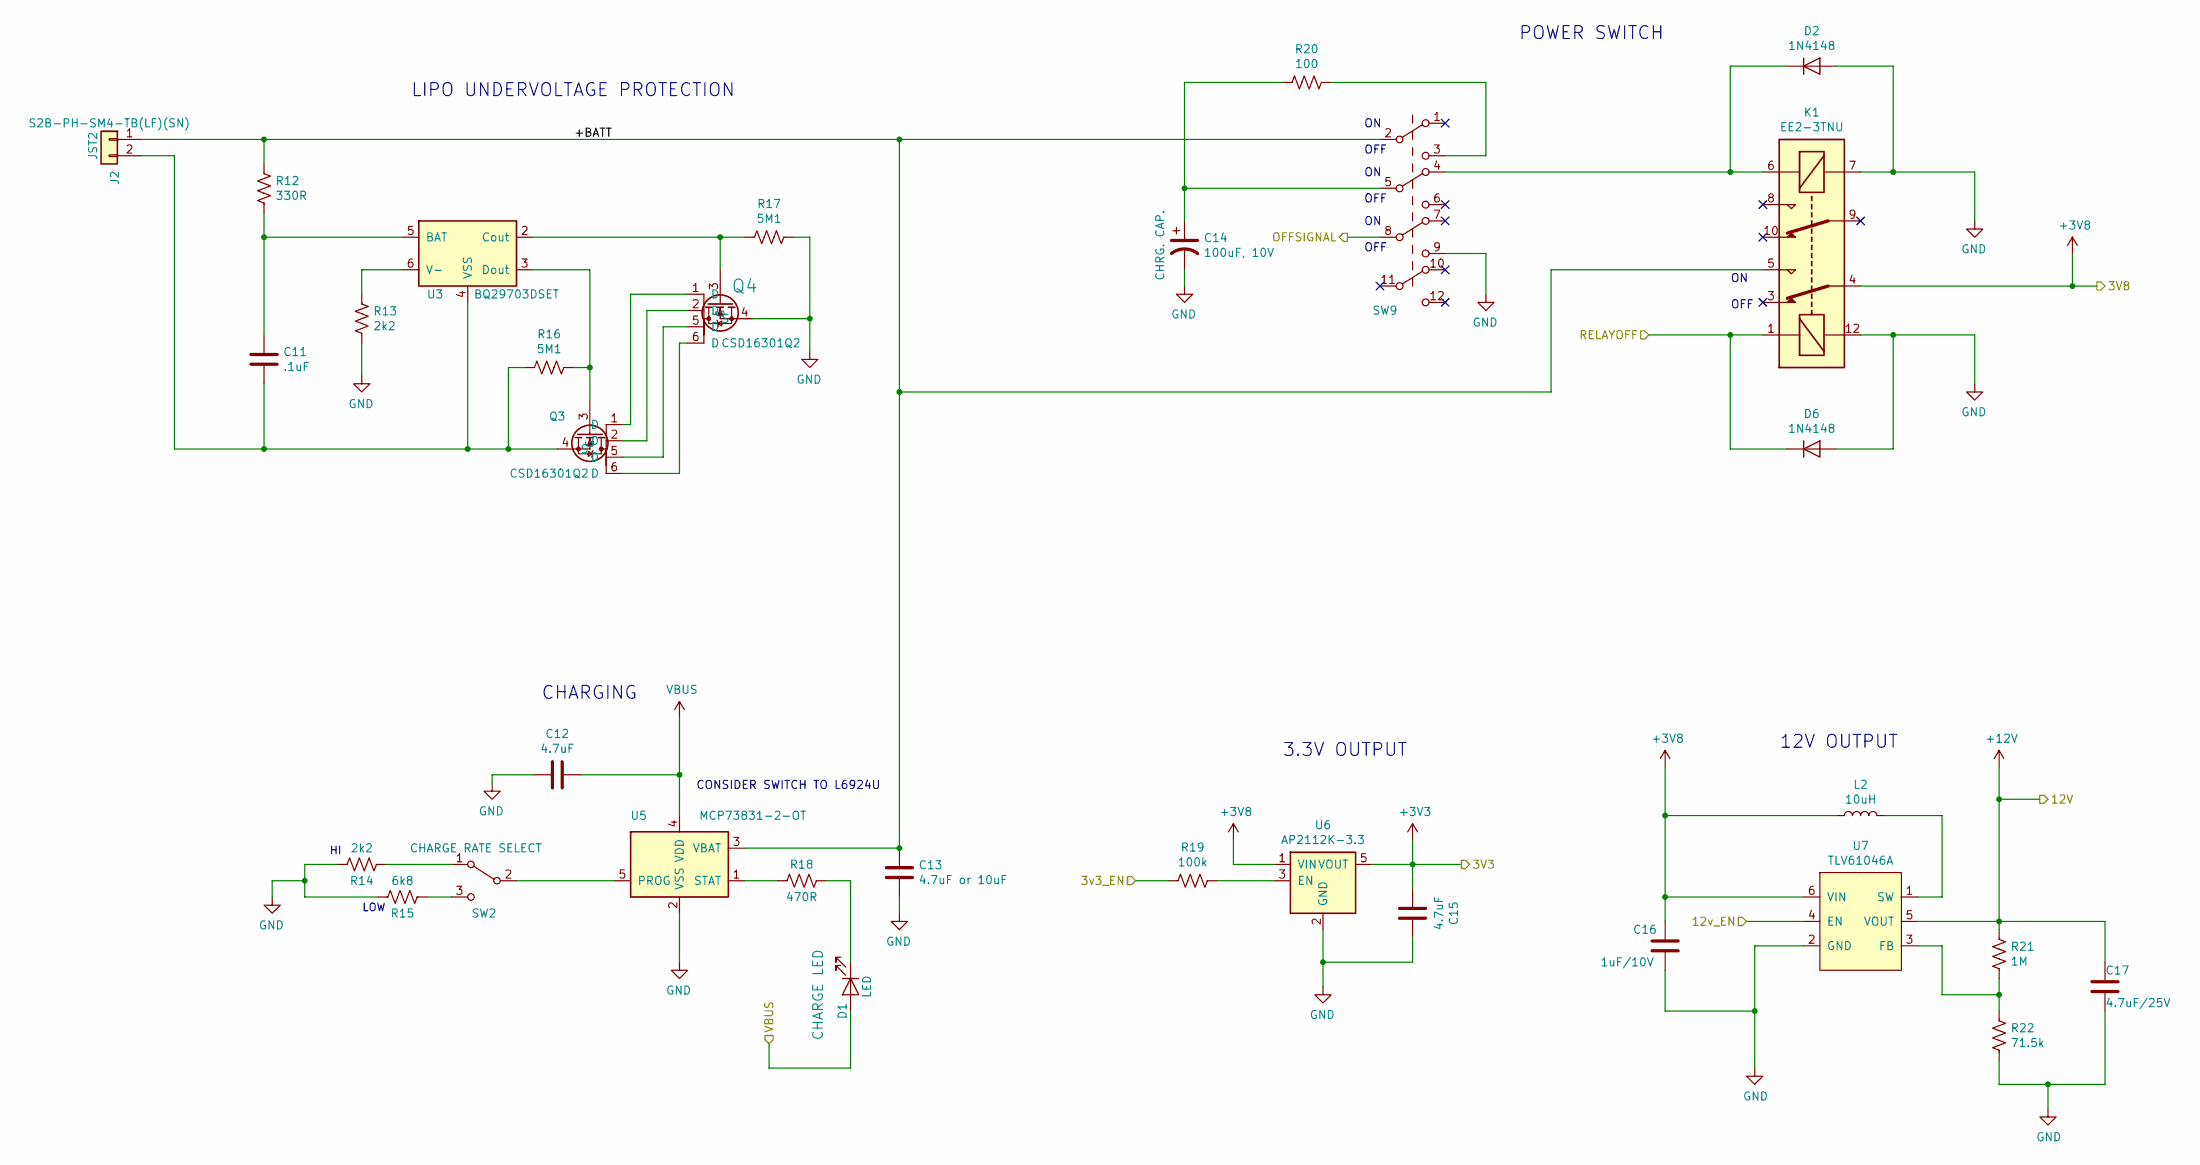
[picture p40: schematic PowerManagement.sch, RCP CHARGING AND POWER MANAGEMENT]

Parts:
C11: .1uF; C_0402_1005Metric
C12, C15: 4.7uF; C_0402_1005Metric
C13: 4.7uF or 10uF; C_0402_1005Metric
C14: 100uF, 10V; CP_Elec_6.3x4.5; Mfg. Part No. 865080243007
C16: 1uF/10V; C_0402_1005Metric
C17: 4.7uF/25V; R_0805_2012Metric
D1: LED; LED_0603_1608Metric_Castellated; Mfg. Part No. LT Q39G-Q1OO-25-1
D2, D6: 1N4148; D_SOD-123; Mfg. Part No. 1N4148W-13-F
J2: JST2; S2B-PH-SM4-TBLFSN; Mfg. Part No. S2B-PH-SM4-TB(LF)(SN)
K1: EE2-3TNU; Relay_Kemet_EE2-3TNU; Mfg. Part No. EE2-3TNU
L2: 10uH; Inductor_Wurth_74438336100; Mfg. Part No. 74438336100
Q3, Q4: Q_NMOS_POWER; TI_CSD16301Q2; Mfg. Part No. CSD16301Q2
R12: 330R; R_0402_1005Metric
R13, R14: 2k2; R_0402_1005Metric
R15: 6k8; R_0402_1005Metric
R16, R17: 5M1; R_0402_1005Metric
R18: 470R; R_0402_1005Metric
R19: 100k; R_0402_1005Metric
R20: 100; R_0402_1005Metric
R21: 1M; R_0402_1005Metric
R22: 71.5k; R_0402_1005Metric
SW2: CHARGE RATE SELECT; SPDT_OS102011MA1QN1; Mfg. Part No. OS102011MA1QN1
SW9: SW_4P2T; Switch_4PDT_ESwitch-EG4208; Mfg. Part No. EG4208
U3: BQ29703DSET; WSON-6_1.5x1.5mm_P0.5mm
U5: MCP73831-2-OT; SOT-23-5
U6: AP2112K-3.3; TSOT-23-5; Mfg. Part No. AP2112K-3.3TRG1
U7: TLV61046A; SOT-23-6; Mfg. Part No. TLV61046ADBVR

Connections:
+3V3: C15.2, U6.5 (VOUT); also elsewhere on the board
+3V8: C16.1, K1.4, L2.1, U6.1 (VIN), U7.6 (VIN); also elsewhere on the board
+12V: C17.1, R21.1, U7.5 (VOUT); also elsewhere on the board
/3v3_EN: R19.2; also elsewhere on the board
/12v_EN: U7.4 (EN); also elsewhere on the board
/CHARGING AND POWER MANAGEMENT/+BATT: C13.2, J2.1, K1.5, R12.1, SW9.2, U5.3 (VBAT)
/OFFSIGNAL: SW9.8; also elsewhere on the board
/RELAY_OFF: D6.1 (K), K1.1; also elsewhere on the board
GND: C12.2, C13.1, C14.2, C15.1, C16.2, C17.2, D2.2 (A), D6.2 (A), K1.7, K1.12, Q4.4 (S), R13.1, R14.1, R15.1, R17.1, R22.2, SW9.9, U5.2 (VSS), U6.2 (GND), U7.2 (GND); also elsewhere on the board
unnamed: C11.1, R12.2, U3.5 (BAT)
unnamed: C11.2, J2.2, Q3.4 (S), R16.2, U3.4 (VSS)
unnamed: C14.1, R20.2, SW9.5
unnamed: D1.1 (K), R18.1
unnamed: D2.1 (K), K1.6, SW9.4
unnamed: L2.2, U7.1 (SW)
unnamed: Q3.1 (D), Q4.1 (D)
unnamed: Q3.2 (D), Q4.2 (D)
unnamed: Q3.3 (G), R16.1, U3.3 (Dout)
unnamed: Q3.5 (D), Q4.5 (D)
unnamed: Q3.6 (D), Q4.6 (D)
unnamed: Q4.3 (G), R17.2, U3.2 (Cout)
unnamed: R13.2, U3.6 (V-)
unnamed: R14.2, SW2.1 (A)
unnamed: R15.2, SW2.3 (C)
unnamed: R18.2, U5.1 (STAT)
unnamed: R19.1, U6.3 (EN)
unnamed: R20.1, SW9.3
unnamed: R21.2, R22.1, U7.3 (FB)
unnamed: SW2.2 (B), U5.5 (PROG)
VBUS: C12.1, D1.2 (A), U5.4 (VDD); also elsewhere on the board

Notes on the sheet:
LOW
CHARGING
LIPO UNDERVOLTAGE PROTECTION
3.3V OUTPUT
12V OUTPUT
CONSIDER SWITCH TO L6924U
POWER SWITCH
ON OFF

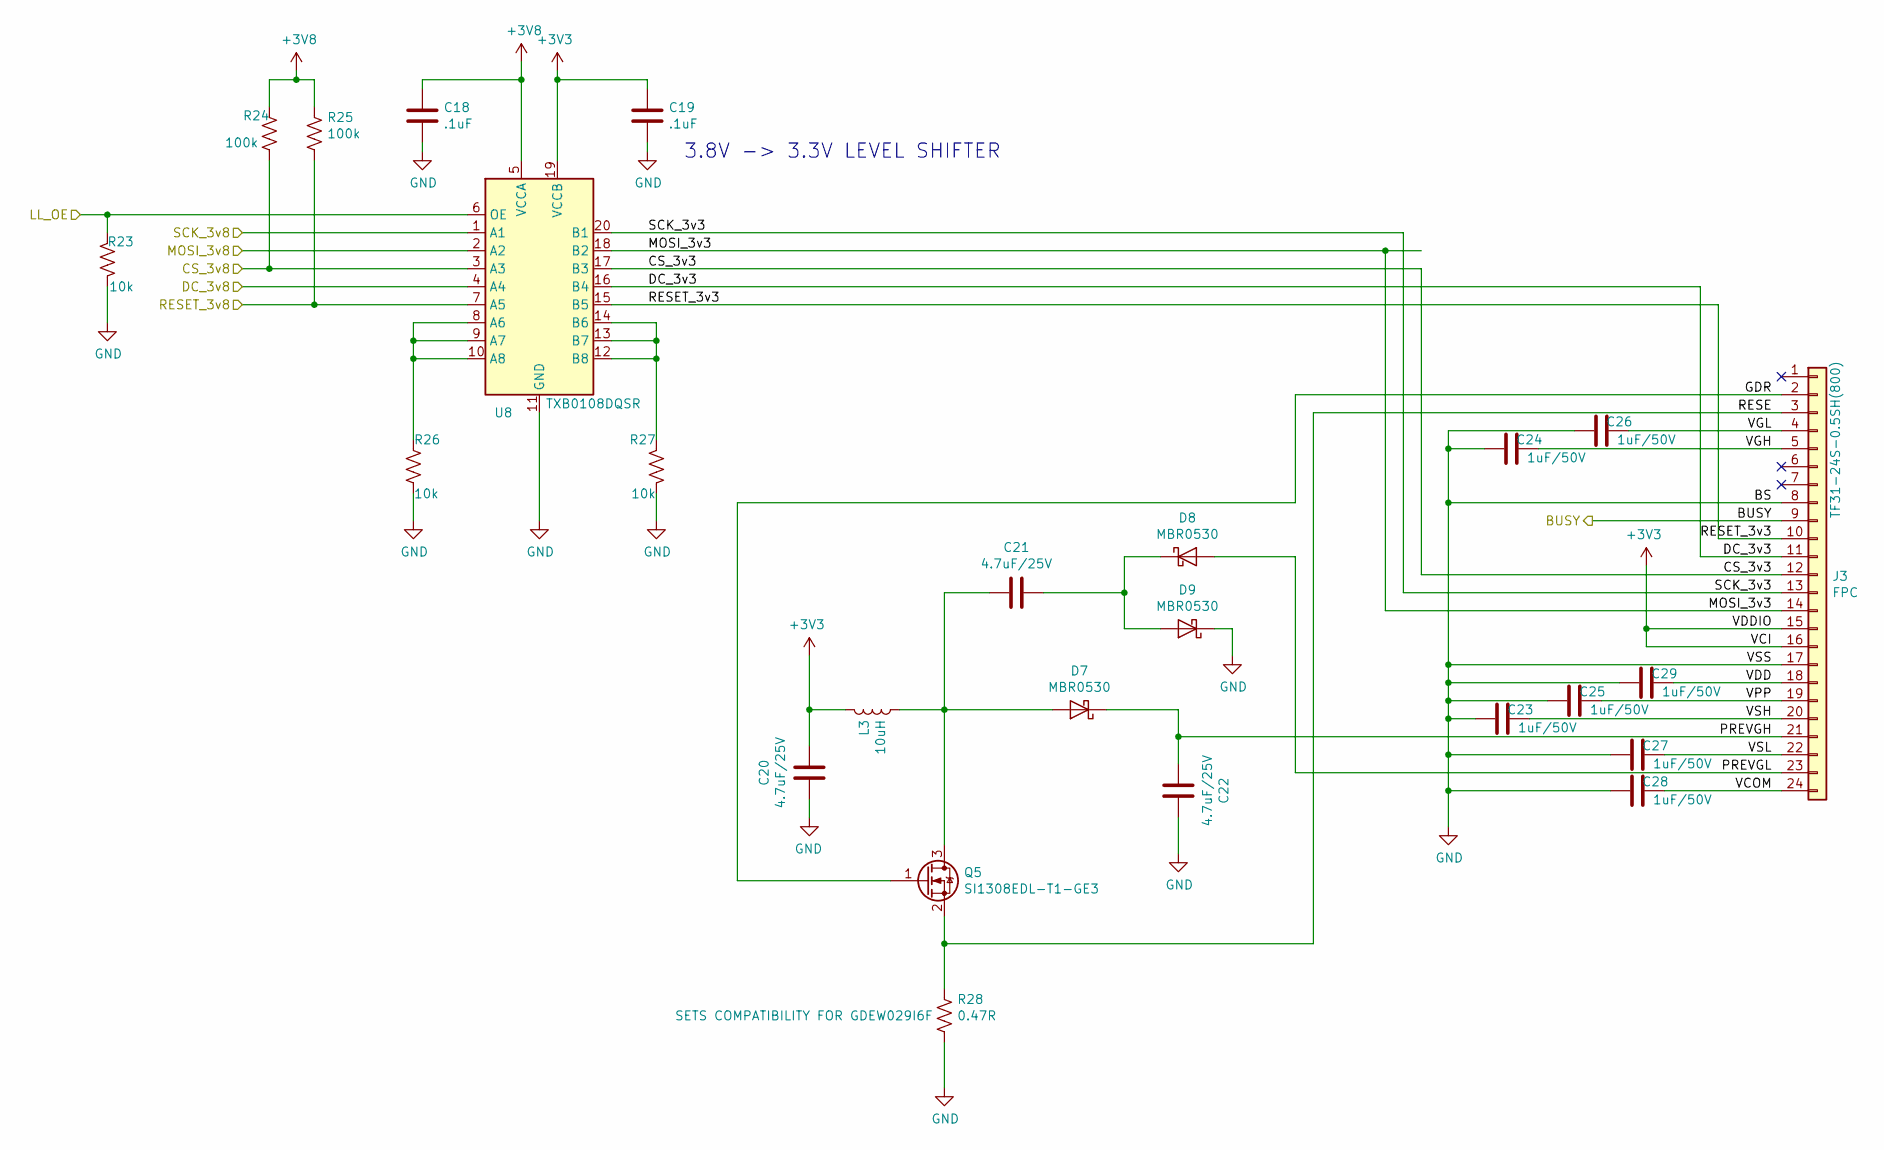
[picture p41: schematic ePaperDriver.sch, RCP EPAPER DRIVER]

Parts:
C18, C19: .1uF; C_0402_1005Metric
C20, C21, C22: 4.7uF/25V; C_0805_2012Metric
C23, C24, C25, C26, C27, C28, C29: 1uF/50V; C_0805_2012Metric
D7, D8, D9: MBR0530; D_SOD-123; Mfg. Part No. MBR0530
J3: FPC; Hirose_FPC_TF31-24S-0.5SH(800); Mfg. Part No. TF31-24S-0.5SH(800)
L3: 10uH; Inductor_Wurth_74438336100
Q5: NMOS; SOT-323_SC-70; Mfg. Part No. SI1308EDL-T1-GE3
R23: 10k; R_0603_1608Metric_Pad1.05x0.95mm_HandSolder
R24, R25: 100k; R_0402_1005Metric
R26, R27: 10k; R_0402_1005Metric
R28: 0.47R; R_0603_1608Metric_Pad1.05x0.95mm_HandSolder
U8: TXB0108DQSR; USON-20_2x4mm_P0.4mm

Connections:
+3V3: C19.1, C20.2, J3.15, J3.16, L3.1, U8.19 (VCCB); also elsewhere on the board
+3V8: C18.1, R24.1, R25.1, U8.5 (VCCA); also elsewhere on the board
/EPD_BUSY: J3.9; also elsewhere on the board
/EPD_CS: R24.2, U8.3 (A3); also elsewhere on the board
/EPD_DC: U8.4 (A4); also elsewhere on the board
/EPD_RESET: R25.2, U8.7 (A5); also elsewhere on the board
/MOSI: U8.2 (A2); also elsewhere on the board
/SCK: U8.1 (A1); also elsewhere on the board
/ePAPER DRIVER/CS_3v3: J3.12, U8.17 (B3)
/ePAPER DRIVER/DC_3v3: J3.11, U8.16 (B4)
/ePAPER DRIVER/GDR: J3.2, Q5.1 (G)
/ePAPER DRIVER/MOSI_3v3: J3.14, U8.18 (B2)
/ePAPER DRIVER/PREVGH: C22.2, D7.1 (K), J3.21
/ePAPER DRIVER/PREVGL: D8.2 (A), J3.23
/ePAPER DRIVER/RESE: J3.3, Q5.2 (S), R28.1
/ePAPER DRIVER/RESET_3v3: J3.10, U8.15 (B5)
/ePAPER DRIVER/SCK_3v3: J3.13, U8.20 (B1)
/ePAPER DRIVER/VCOM: C28.1, J3.24
/ePAPER DRIVER/VDD: C29.1, J3.18
/ePAPER DRIVER/VGH: C24.1, J3.5
/ePAPER DRIVER/VGL: C26.1, J3.4
/ePAPER DRIVER/VPP: C25.1, J3.19
/ePAPER DRIVER/VSH: C23.1, J3.20
/ePAPER DRIVER/VSL: C27.1, J3.22
GND: C18.2, C19.2, C20.1, C22.1, C23.2, C24.2, C25.2, C26.2, C27.2, C28.2, C29.2, D9.1 (K), J3.8, J3.17, R23.2, R26.2, R27.2, R28.2, U8.11 (GND); also elsewhere on the board
LL_OE: R23.1, U8.6 (OE); also elsewhere on the board
unnamed: C21.1, D8.1 (K), D9.2 (A)
unnamed: C21.2, D7.2 (A), L3.2, Q5.3 (D)
unnamed: R26.1, U8.8 (A6), U8.9 (A7), U8.10 (A8)
unnamed: R27.1, U8.12 (B8), U8.13 (B7), U8.14 (B6)

Notes on the sheet:
3.8V -> 3.3V LEVEL SHIFTER
