skysedge/RUST_Hardware/Bak/081320/RotaryCellPhone-4G.kicad_pcb

## KiCad design Bak/081320/RotaryCellPhone-4G.kicad_pcb (continued)

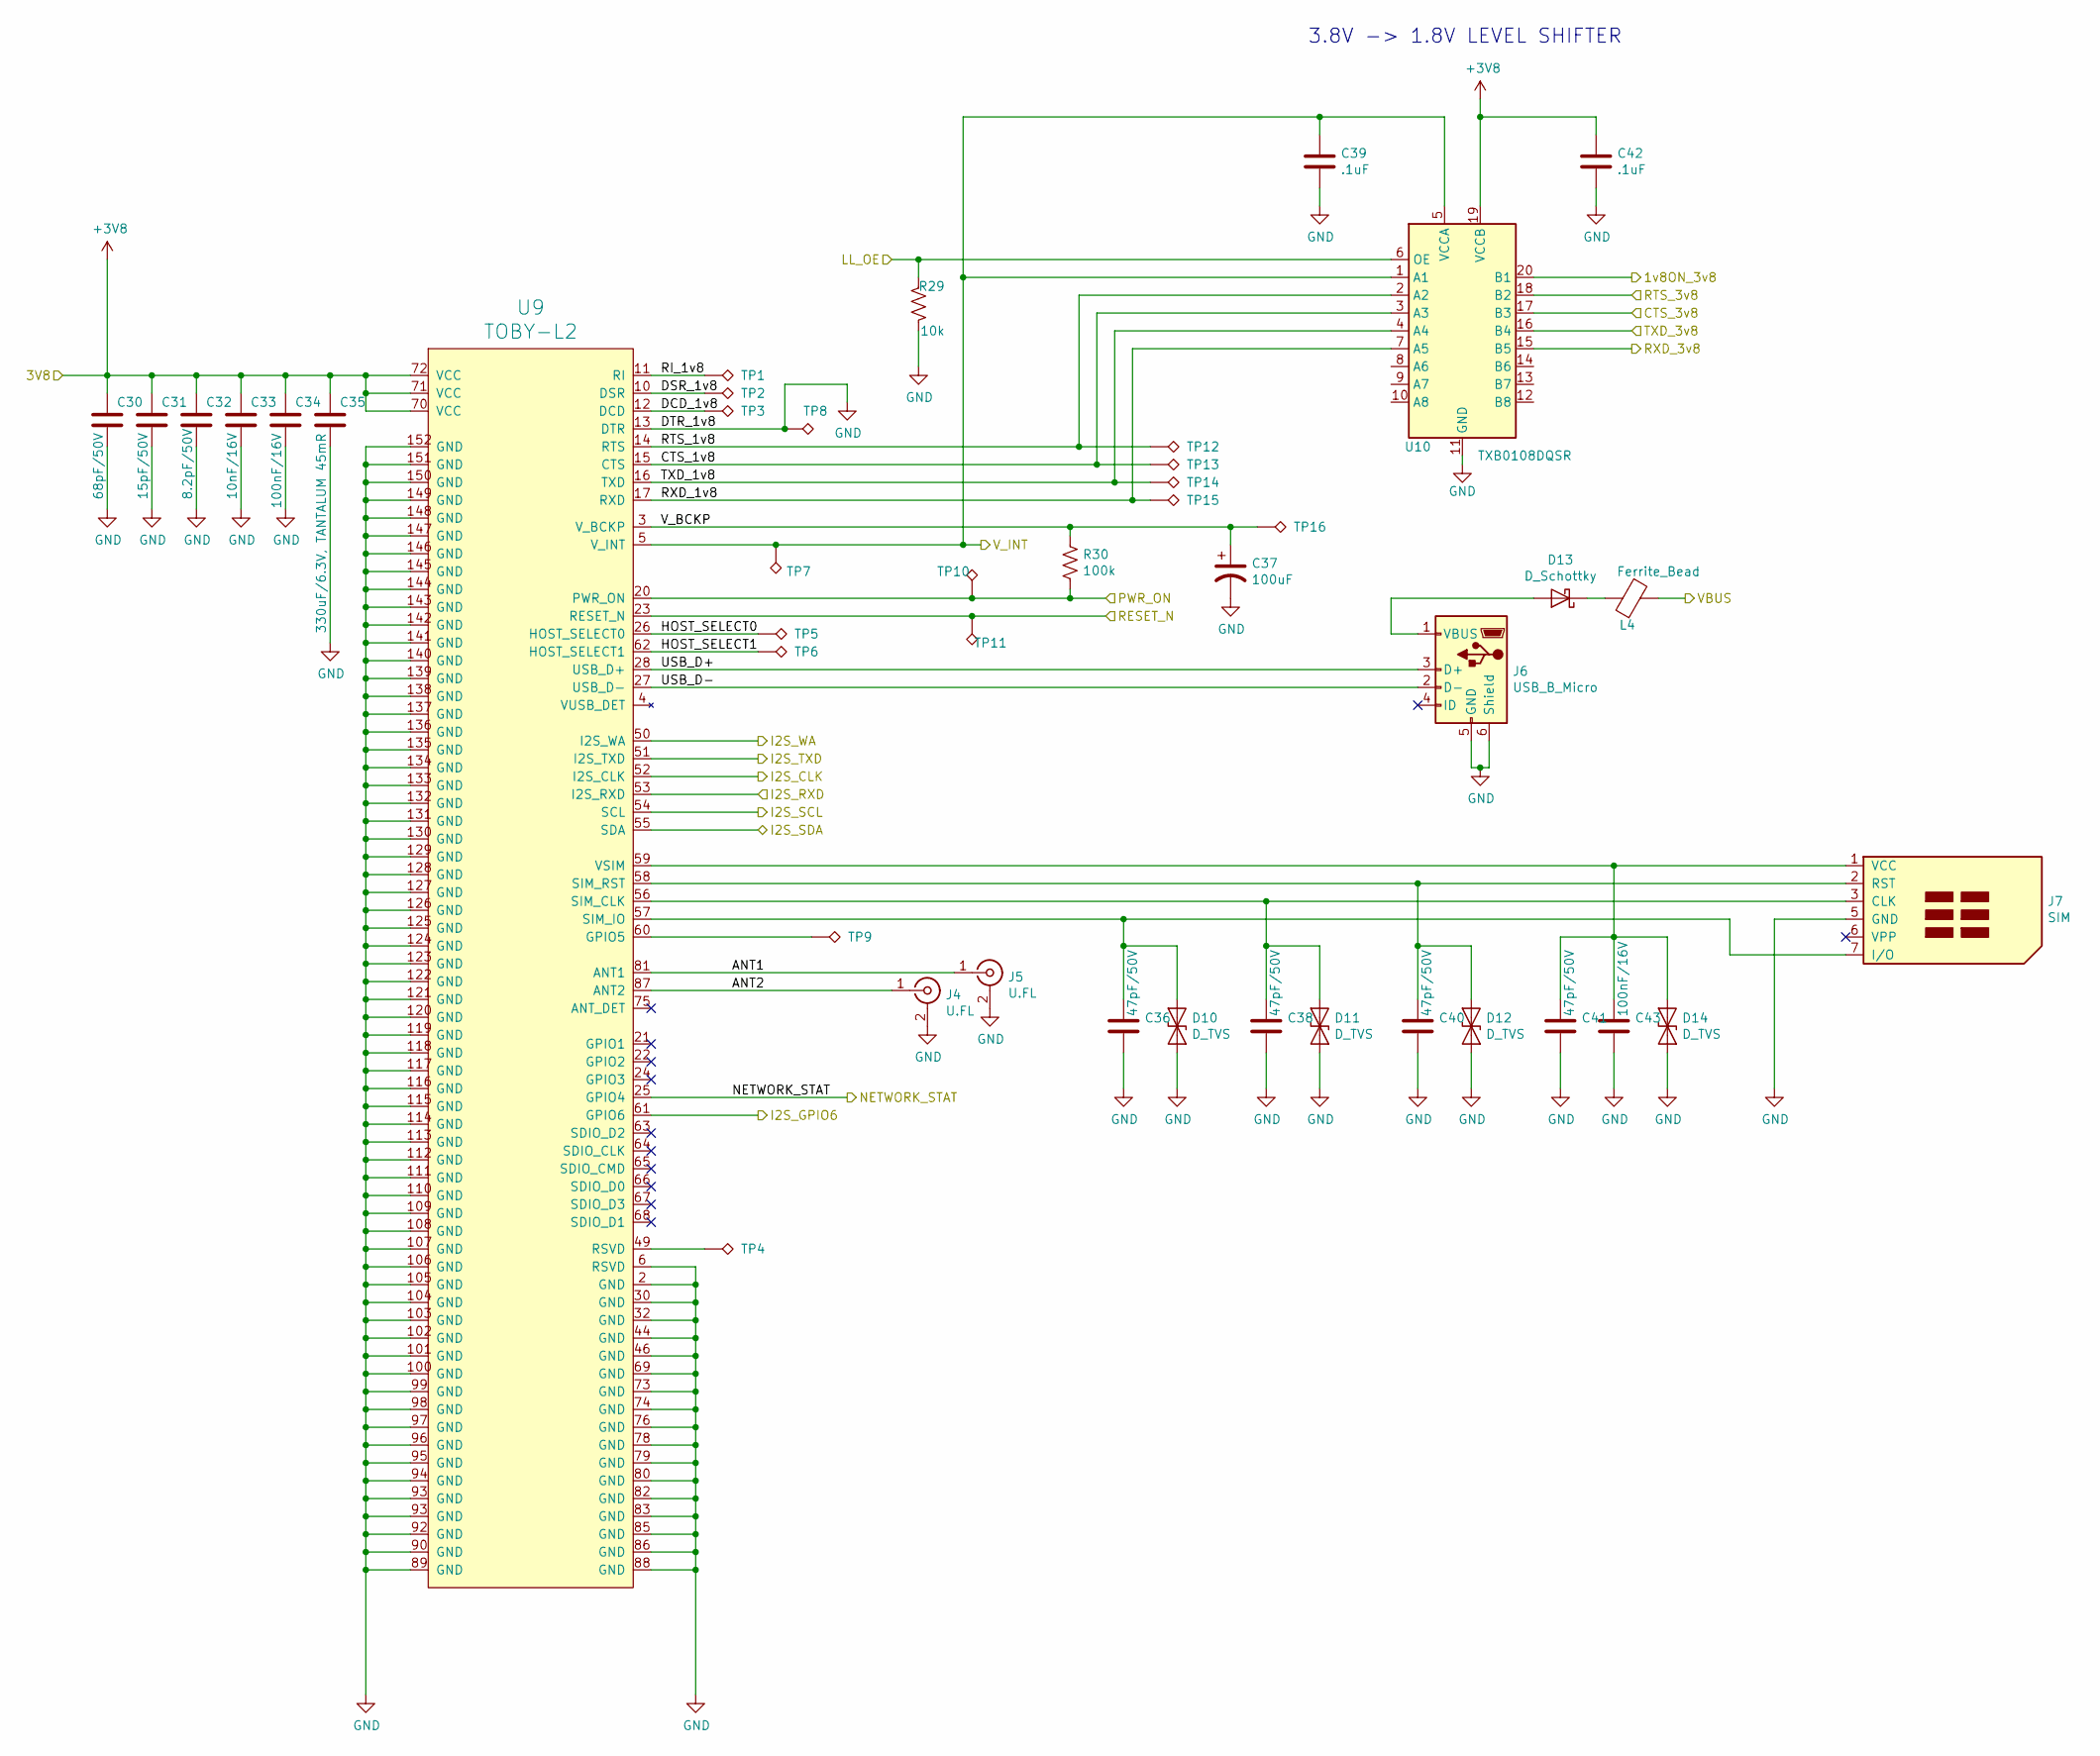
[picture p42: schematic CellTranceiver.sch, RCP 4G CELLULAR TRANCEIVER]

Parts:
C30: 68pF/50V; C_0402_1005Metric; Mfg. Part No. GRM1555C1H680JA01
C31: 15pF/50V; C_0402_1005Metric; Mfg. Part No. GRM1555C1H150JA01
C32: 8.2pF/50V; C_0402_1005Metric; Mfg. Part No. GRM1555C1H8R2DZ01
C33: 10nF/16V; C_0402_1005Metric; Mfg. Part No. GRM155R71C103KA01
C34: 100nF/16V; C_0402_1005Metric; Mfg. Part No. GRM155R71C104KA01
C35: 330uF/6.3V, TANTALUM 45mR; C_0402_1005Metric; Mfg. Part No. T520D337M006ATE045
C36, C38, C40, C41: 47pF/50V; R_0402_1005Metric; Mfg. Part No. GRM1555C1H470JA01
C37: 100uF; Capacitor_Wurth865080243007; Mfg. Part No. 865080243007
C39, C42: .1uF; C_0402_1005Metric
C43: 100nF/16V; R_0402_1005Metric; Mfg. Part No. GRM155R71C104KA01
D10, D11, D12, D14: D_TVS; R_0402_1005Metric; Mfg. Part No. PESD0402-140
D13: D_Schottky; D_SOD-123; Mfg. Part No. MBR130T3G
J4, J5: U.FL; U.FL_Molex_MCRF_73412-0110_Vertical; Mfg. Part No. 0734120110
J6: USB_B_Micro; AMPHENOL_MicroUSB_10118194-0001LF; Mfg. Part No. 10118194-0001LF
J7: SIM; SIMHolder_Amph7111S2015X02LF; Mfg. Part No. 7111S2015X02LF
L4: Ferrite_Bead; R_0805_2012Metric_Pad1.15x1.40mm_HandSolder; Mfg. Part No. MI0805K601R-10
R29: 10k; R_0402_1005Metric
R30: 100k; R_0402_1005Metric
TP1, TP2, TP3, TP4, TP5, TP6, TP7, TP8, TP9, TP10, TP11, TP12, TP13, TP14, TP15, TP16: TestPoint_Alt; TestPoint_THTPad_1.0x1.0mm_Drill0.5mm
U9: TOBY-L2; CellModule_TOBY-L2; Mfg. Part No. TOBY-L2
U10: TXB0108DQSR; USON-20_2x4mm_P0.4mm; Mfg. Part No. TXB0108DQSR

Connections:
+3V8: C30.1, C31.1, C32.1, C33.1, C34.1, C35.1, C42.1, U9.70 (VCC), U9.71 (VCC), U9.72 (VCC), U10.19 (VCCB); also elsewhere on the board
/AUDIO/BLCK: U9.52 (I2S_CLK); also elsewhere on the board
/AUDIO/V_INT: C39.1, TP7.1, U9.5 (V_INT), U10.1 (A1), U10.5 (VCCA); also elsewhere on the board
/CELL TRANSCEIVER/ANT1: J5.1 (In), U9.81 (ANT1)
/CELL TRANSCEIVER/ANT2: J4.1 (In), U9.87 (ANT2)
/CELL TRANSCEIVER/CTS_1v8: TP13.1, U9.15 (CTS), U10.3 (A3)
/CELL TRANSCEIVER/DCD_1v8: TP3.1, U9.12 (DCD)
/CELL TRANSCEIVER/DSR_1v8: TP2.1, U9.10 (DSR)
/CELL TRANSCEIVER/HOST_SELECT0: TP5.1, U9.26 (HOST_SELECT0)
/CELL TRANSCEIVER/HOST_SELECT1: TP6.1, U9.62 (HOST_SELECT1)
/CELL TRANSCEIVER/I2S_GPIO6: U9.61 (GPIO6); also elsewhere on the board
/CELL TRANSCEIVER/I2S_RXD: U9.53 (I2S_RXD); also elsewhere on the board
/CELL TRANSCEIVER/I2S_SCL: U9.54 (SCL); also elsewhere on the board
/CELL TRANSCEIVER/I2S_SDA: U9.55 (SDA); also elsewhere on the board
/CELL TRANSCEIVER/I2S_TXD: U9.51 (I2S_TXD); also elsewhere on the board
/CELL TRANSCEIVER/I2S_WA: U9.50 (I2S_WA); also elsewhere on the board
/CELL TRANSCEIVER/PWR_ON: R30.2, TP10.1, U9.20 (PWR_ON); also elsewhere on the board
/CELL TRANSCEIVER/RESET_N: TP11.1, U9.23 (RESET_N); also elsewhere on the board
/CELL TRANSCEIVER/RI_1v8: TP1.1, U9.11 (RI)
/CELL TRANSCEIVER/RTS_1v8: TP12.1, U9.14 (RTS), U10.2 (A2)
/CELL TRANSCEIVER/RXD_1v8: TP15.1, U9.17 (RXD), U10.7 (A5)
/CELL TRANSCEIVER/TXD_1v8: TP14.1, U9.16 (TXD), U10.4 (A4)
/CELL TRANSCEIVER/USB_D+: J6.3 (D+), U9.28 (USB_D+)
/CELL TRANSCEIVER/USB_D-: J6.2 (D-), U9.27 (USB_D-)
/CELL TRANSCEIVER/V_BCKP: C37.1, R30.1, TP16.1, U9.3 (V_BCKP)
/CELL_CTS: U10.17 (B3); also elsewhere on the board
/CELL_PWR_DET: U10.20 (B1); also elsewhere on the board
/CELL_RTS: U10.18 (B2); also elsewhere on the board
/CELL_RXD: U10.15 (B5); also elsewhere on the board
/CELL_STAT: U9.25 (GPIO4); also elsewhere on the board
/CELL_TXD: U10.16 (B4); also elsewhere on the board
GND: C30.2, C31.2, C32.2, C33.2, C34.2, C35.2, C36.2, C37.2, C38.2, C39.2, C40.2, C41.2, C42.2, C43.2, D10.2 (A2), D11.2 (A2), D12.2 (A2), D14.2 (A2), J4.2 (Ext), J5.2 (Ext), J6.5 (GND), J6.6 (Shield), J7.5 (GND), R29.2, TP8.1, U9.2 (GND), U9.6 (RSVD), U9.13 (DTR), U9.30 (GND), U9.32 (GND), U9.44 (GND), U9.46 (GND), U9.69 (GND), U9.73 (GND), U9.74 (GND), U9.76 (GND), U9.78 (GND), U9.79 (GND), U9.80 (GND), U9.82 (GND), U9.83 (GND), U9.85 (GND), U9.86 (GND), U9.88 (GND), U9.89 (GND), U9.90 (GND), U9.92 (GND), U9.93 (GND), U9.94 (GND), U9.95 (GND), U9.96 (GND), U9.97 (GND), U9.98 (GND), U9.99 (GND), U9.100 (GND), U9.101 (GND), U9.102 (GND), U9.103 (GND), U9.104 (GND), U9.105 (GND), U9.106 (GND), U9.107 (GND), U9.108 (GND), U9.109 (GND), U9.110 (GND), U9.111 (GND), U9.112 (GND), U9.113 (GND), U9.114 (GND), U9.115 (GND), U9.116 (GND), U9.117 (GND), U9.118 (GND), U9.119 (GND), U9.120 (GND), U9.121 (GND), U9.122 (GND), U9.123 (GND), U9.124 (GND), U9.125 (GND), U9.126 (GND), U9.127 (GND), U9.128 (GND), U9.129 (GND), U9.130 (GND), U9.131 (GND), U9.132 (GND), U9.133 (GND), U9.134 (GND), U9.135 (GND), U9.136 (GND), U9.137 (GND), U9.138 (GND), U9.139 (GND), U9.140 (GND), U9.141 (GND), U9.142 (GND), U9.143 (GND), U9.144 (GND), U9.145 (GND), U9.146 (GND), U9.147 (GND), U9.148 (GND), U9.149 (GND), U9.150 (GND), U9.151 (GND), U9.152 (GND), U10.11 (GND); also elsewhere on the board
LL_OE: R29.1, U10.6 (OE); also elsewhere on the board
unnamed: C36.1, D10.1 (A1), J7.7 (I/O), U9.57 (SIM_IO)
unnamed: C38.1, D11.1 (A1), J7.3 (CLK), U9.56 (SIM_CLK)
unnamed: C40.1, D12.1 (A1), J7.2 (RST), U9.58 (SIM_RST)
unnamed: C41.1, C43.1, D14.1 (A1), J7.1 (VCC), U9.59 (VSIM)
unnamed: D13.1 (K), L4.1
unnamed: D13.2 (A), J6.1 (VBUS)
unnamed: TP4.1, U9.49 (RSVD)
unnamed: TP9.1, U9.60 (GPIO5)
VBUS: L4.2; also elsewhere on the board

Notes on the sheet:
3.8V -> 1.8V LEVEL SHIFTER

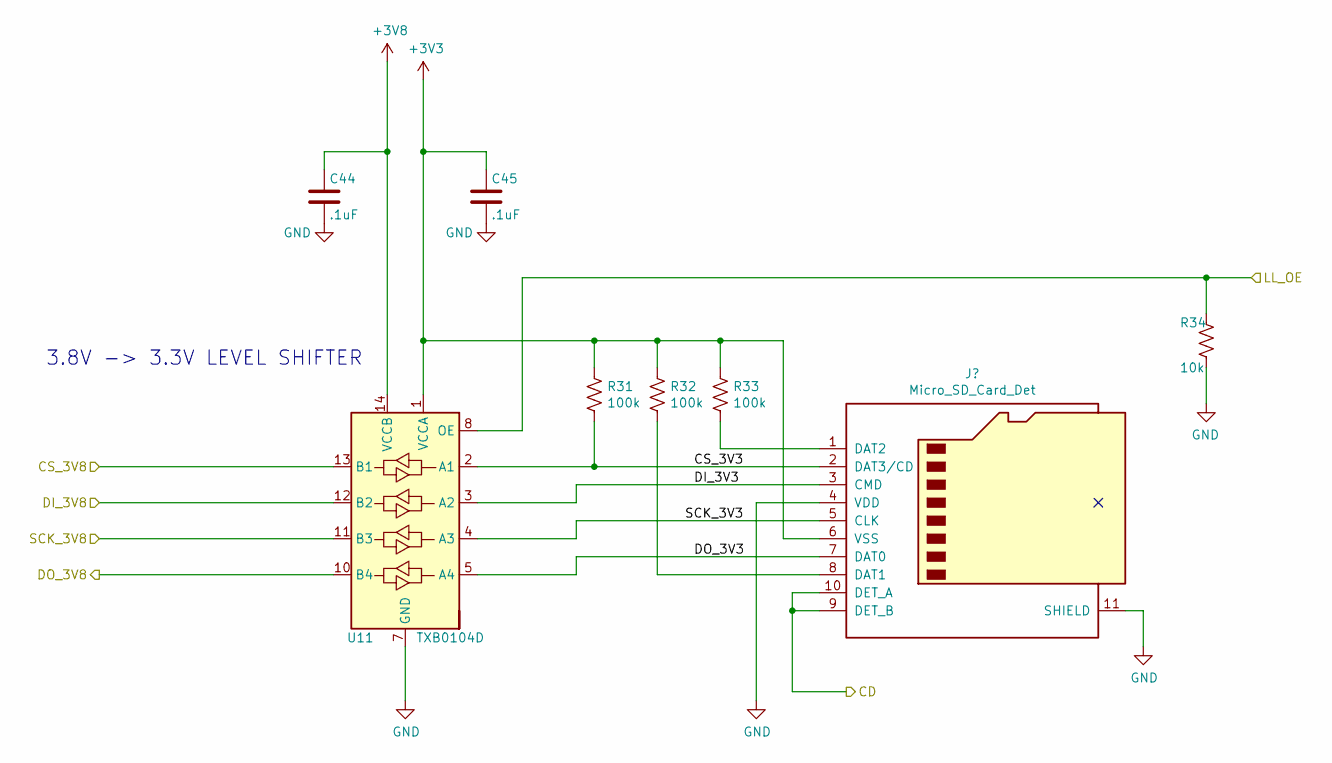
[picture p43: schematic SDCard.sch, RCP SD CARD INTERFACE]

Parts:
C44, C45: .1uF; C_0402_1005Metric
R31, R32, R33: 100k; R_0402_1005Metric
R34: 10k; R_0402_1005Metric
U11: TXB0104D; SOIC-14_3.9x8.7mm_P1.27mm

Connections:
+3V3: C45.1, R31.1, R32.1, R33.1, U11.1 (VCCA); also elsewhere on the board
+3V8: C44.1, U11.14 (VCCB); also elsewhere on the board
/MISO: U11.10 (B4); also elsewhere on the board
/MOSI: U11.12 (B2); also elsewhere on the board
/SCK: U11.11 (B3); also elsewhere on the board
/SD CARD/CS_3V3: R31.2, U11.2 (A1); also elsewhere on the board
/SD CARD/DI_3V3: U11.3 (A2); also elsewhere on the board
/SD CARD/DO_3V3: U11.5 (A4); also elsewhere on the board
/SD CARD/SCK_3V3: U11.4 (A3); also elsewhere on the board
/SD_CS: U11.13 (B1); also elsewhere on the board
GND: C44.2, C45.2, R34.2, U11.7 (GND); also elsewhere on the board
LL_OE: R34.1, U11.8 (OE); also elsewhere on the board
unnamed 189: R32.2; also elsewhere on the board
unnamed 190: R33.2; also elsewhere on the board

Notes on the sheet:
3.8V -> 3.3V LEVEL SHIFTER

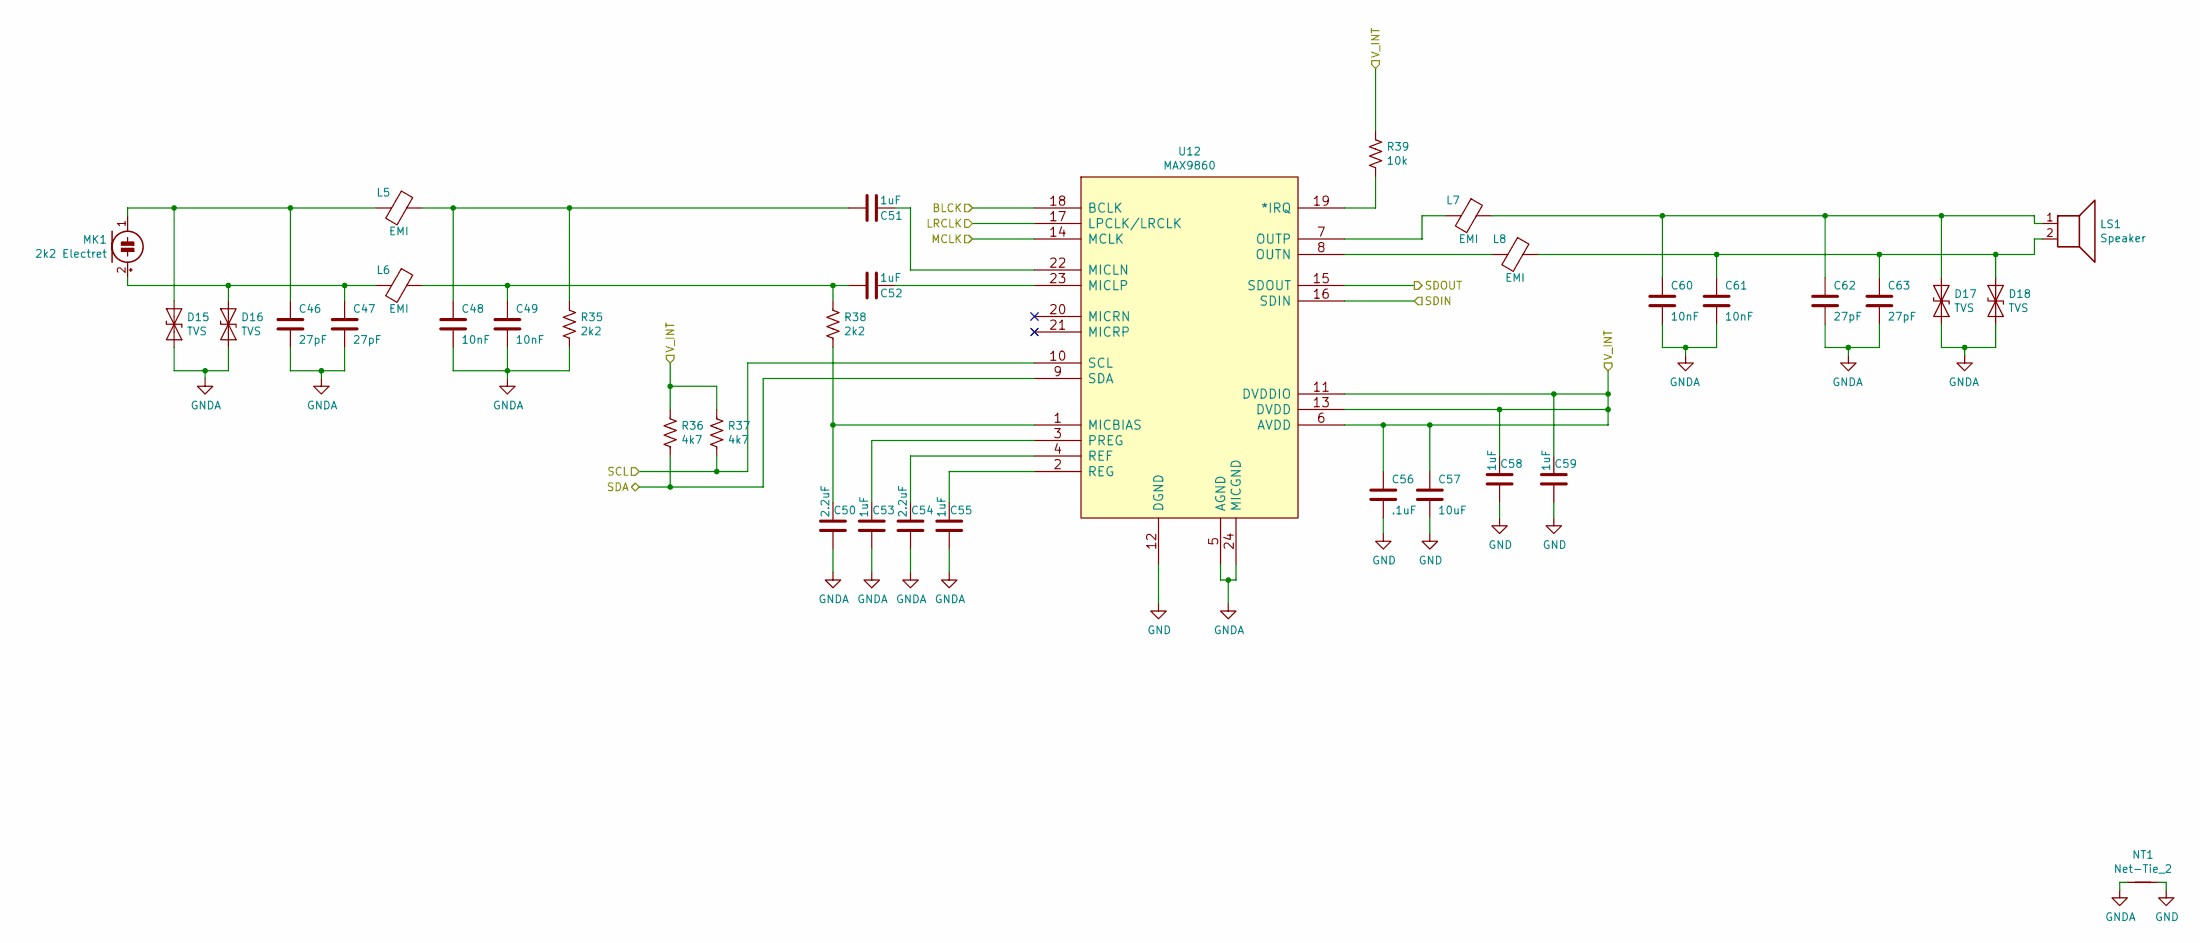
[picture p44: schematic AudioCODEC.sch, RCP 4G AUDIO CODEC AND I/O]

Parts:
C46, C47, C62, C63: 27pF; C_0402_1005Metric; Mfg. Part No. GRM1555C1H270JZ01
C48, C49, C60, C61: 10nF; C_0402_1005Metric; Mfg. Part No. GCM155R71H103KA55D
C50, C54: 2.2uF; C_0402_1005Metric
C51, C52, C53, C55, C58, C59: 1uF; C_0402_1005Metric
C56: .1uF; C_0402_1005Metric
C57: 10uF; C_0603_1608Metric
D15, D16, D17, D18: TVS; R_0603_1608Metric_Pad1.05x0.95mm_HandSolder; Mfg. Part No. USB0001DP
L5, L6, L7, L8: EMI; L_0402_1005Metric; Mfg. Part No. BLM15HD182SN1
LS1: Speaker; Speaker_PUI_AR01232MS-SC12-WP-R; Mfg. Part No. AR01232MS-SC12-WP-R
MK1: 2k2 Electret; Microphone_PUI_POM-2738P-R; Mfg. Part No. POM-2738P-R
NT1: Net-Tie_2; NetTie-2_SMD_Pad0.5mm
R35, R38: 2k2; R_0402_1005Metric
R36, R37: 4k7; R_0402_1005Metric
R39: 10k; R_0402_1005Metric
U12: MAX9860; WQFN-24-1EP_4x4mm_P0.5mm_EP2.7x2.7mm; Mfg. Part No. MAX9860

Connections:
/AUDIO/BLCK: U12.18 (BCLK); also elsewhere on the board
/AUDIO/V_INT: C56.1, C57.1, C58.1, C59.1, R36.1, R37.1, R39.1, U12.6 (AVDD), U12.11 (DVDDIO), U12.13 (DVDD); also elsewhere on the board
/CELL TRANSCEIVER/I2S_GPIO6: U12.14 (MCLK); also elsewhere on the board
/CELL TRANSCEIVER/I2S_RXD: U12.15 (SDOUT); also elsewhere on the board
/CELL TRANSCEIVER/I2S_SCL: R37.2, U12.10 (SCL); also elsewhere on the board
/CELL TRANSCEIVER/I2S_SDA: R36.2, U12.9 (SDA); also elsewhere on the board
/CELL TRANSCEIVER/I2S_TXD: U12.16 (SDIN); also elsewhere on the board
/CELL TRANSCEIVER/I2S_WA: U12.17 (LPCLK/LRCLK); also elsewhere on the board
GND: C56.2, C57.2, C58.2, C59.2, NT1.2, U12.12 (DGND); also elsewhere on the board
GNDA: C46.2, C47.2, C48.2, C49.2, C50.2, C53.2, C54.2, C55.2, C60.2, C61.2, C62.2, C63.2, D15.2 (A2), D16.2 (A2), D17.2 (A2), D18.2 (A2), NT1.1, R35.2, U12.5 (AGND), U12.24 (MICGND)
unnamed: C46.1, D15.1 (A1), L5.2, MK1.1 (-)
unnamed: C47.1, D16.1 (A1), L6.2, MK1.2 (+)
unnamed: C48.1, C51.2, L5.1, R35.1
unnamed: C49.1, C52.2, L6.1, R38.1
unnamed: C50.1, R38.2, U12.1 (MICBIAS)
unnamed: C51.1, U12.22 (MICLN)
unnamed: C52.1, U12.23 (MICLP)
unnamed: C53.1, U12.3 (PREG)
unnamed: C54.1, U12.4 (REF)
unnamed: C55.1, U12.2 (REG)
unnamed: C60.1, C62.1, D17.1 (A1), L7.1, LS1.1
unnamed: C61.1, C63.1, D18.1 (A1), L8.1, LS1.2
unnamed: L7.2, U12.7 (OUTP)
unnamed: L8.2, U12.8 (OUTN)
unnamed: R39.2, U12.19 (*IRQ)

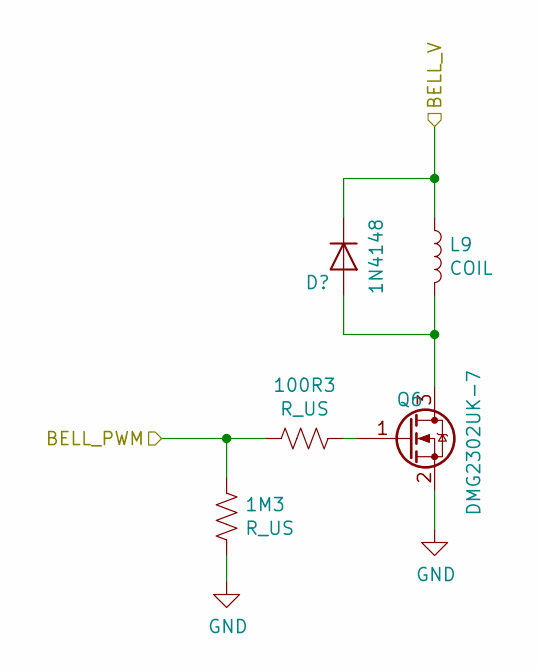
[picture p45: schematic Bell.sch, RCP 4G BELL RINGER]

Parts:
1M3, 100R3: R_US; R_0402_1005Metric
L9: COIL; Inductor_RLB9012-472KL; Mfg. Part No. RLB9012-472KL
Q6: DMG2302UK-7; SOT-23; Mfg. Part No. DMG2302UK-7

Connections:
+12V: L9.1; also elsewhere on the board
/BELL_PWM: 1M3.1, 100R3.2; also elsewhere on the board
GND: 1M3.2, Q6.2 (S); also elsewhere on the board
unnamed: 100R3.1, Q6.1 (G)
unnamed: L9.2, Q6.3 (D)

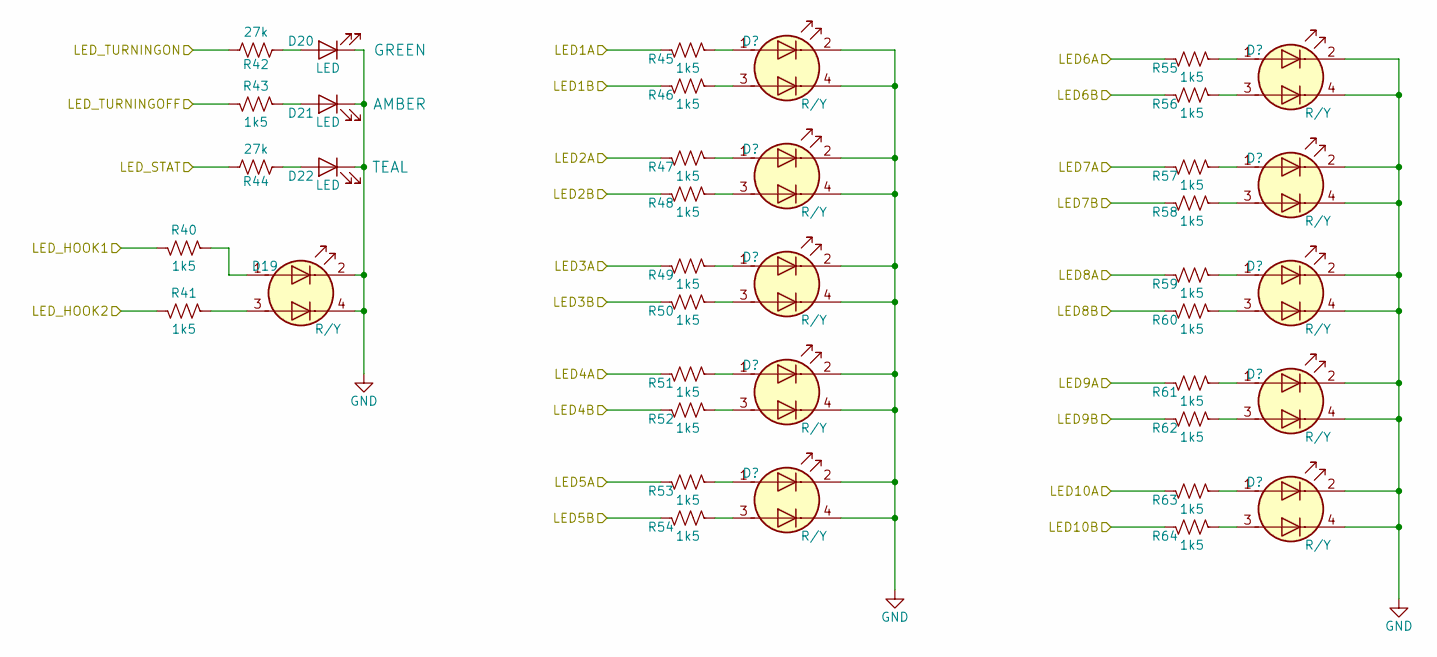
[picture p46: schematic LEDIndicators.sch, RCP STATUS LEDS]

Parts:
D19: R/Y; LED_Dialight_5988560207F; Mfg. Part No. 5988560207F
D20: LED; LED_0603_1608Metric_Castellated; Mfg. Part No. LT Q39G-Q1OO-25-1
D21, D22: LED; LED_0603_1608Metric_Castellated; Mfg. Part No. IN-S63AT5Y
R40, R41, R43, R45, R46, R47, R48, R49, R50, R51, R52, R53, R54, R55, R56, R57, R58, R59, R60, R61, R62, R63, R64: 1k5; R_0402_1005Metric
R42, R44: 27k; R_0402_1005Metric

Connections:
/LED_1A: R45.2; also elsewhere on the board
/LED_1B: R46.2; also elsewhere on the board
/LED_2A: R47.2; also elsewhere on the board
/LED_2B: R48.2; also elsewhere on the board
/LED_3A: R49.2; also elsewhere on the board
/LED_3B: R50.2; also elsewhere on the board
/LED_4A: R51.2; also elsewhere on the board
/LED_4B: R52.2; also elsewhere on the board
/LED_5A: R53.2; also elsewhere on the board
/LED_5B: R54.2; also elsewhere on the board
/LED_6A: R55.2; also elsewhere on the board
/LED_6B: R56.2; also elsewhere on the board
/LED_7A: R57.2; also elsewhere on the board
/LED_7B: R58.2; also elsewhere on the board
/LED_8A: R59.2; also elsewhere on the board
/LED_8B: R60.2; also elsewhere on the board
/LED_9A: R61.2; also elsewhere on the board
/LED_9B: R62.2; also elsewhere on the board
/LED_10A: R63.2; also elsewhere on the board
/LED_10B: R64.2; also elsewhere on the board
/LED_HOOK1: R40.2; also elsewhere on the board
/LED_HOOK2: R41.2; also elsewhere on the board
/LED_STAT: R44.2; also elsewhere on the board
/LED_TURNINGOFF: R43.2; also elsewhere on the board
/LED_TURNINGON: R42.2; also elsewhere on the board
GND: D19.2 (K1), D19.4 (K2), D20.1 (K), D21.1 (K), D22.1 (K); also elsewhere on the board
unnamed: D19.1 (A1), R40.1
unnamed: D19.3 (A2), R41.1
unnamed: D20.2 (A), R42.1
unnamed: D21.2 (A), R43.1
unnamed: D22.2 (A), R44.1
unnamed 167: R45.1; also elsewhere on the board
unnamed 168: R46.1; also elsewhere on the board
unnamed 169: R47.1; also elsewhere on the board
unnamed 170: R48.1; also elsewhere on the board
unnamed 171: R49.1; also elsewhere on the board
unnamed 172: R50.1; also elsewhere on the board
unnamed 173: R51.1; also elsewhere on the board
unnamed 174: R52.1; also elsewhere on the board
unnamed 175: R53.1; also elsewhere on the board
unnamed 176: R54.1; also elsewhere on the board
unnamed 177: R55.1; also elsewhere on the board
unnamed 178: R56.1; also elsewhere on the board
unnamed 179: R57.1; also elsewhere on the board
unnamed 180: R58.1; also elsewhere on the board
unnamed 181: R59.1; also elsewhere on the board
unnamed 182: R60.1; also elsewhere on the board
unnamed 183: R61.1; also elsewhere on the board
unnamed 184: R62.1; also elsewhere on the board
unnamed 185: R63.1; also elsewhere on the board
unnamed 186: R64.1; also elsewhere on the board

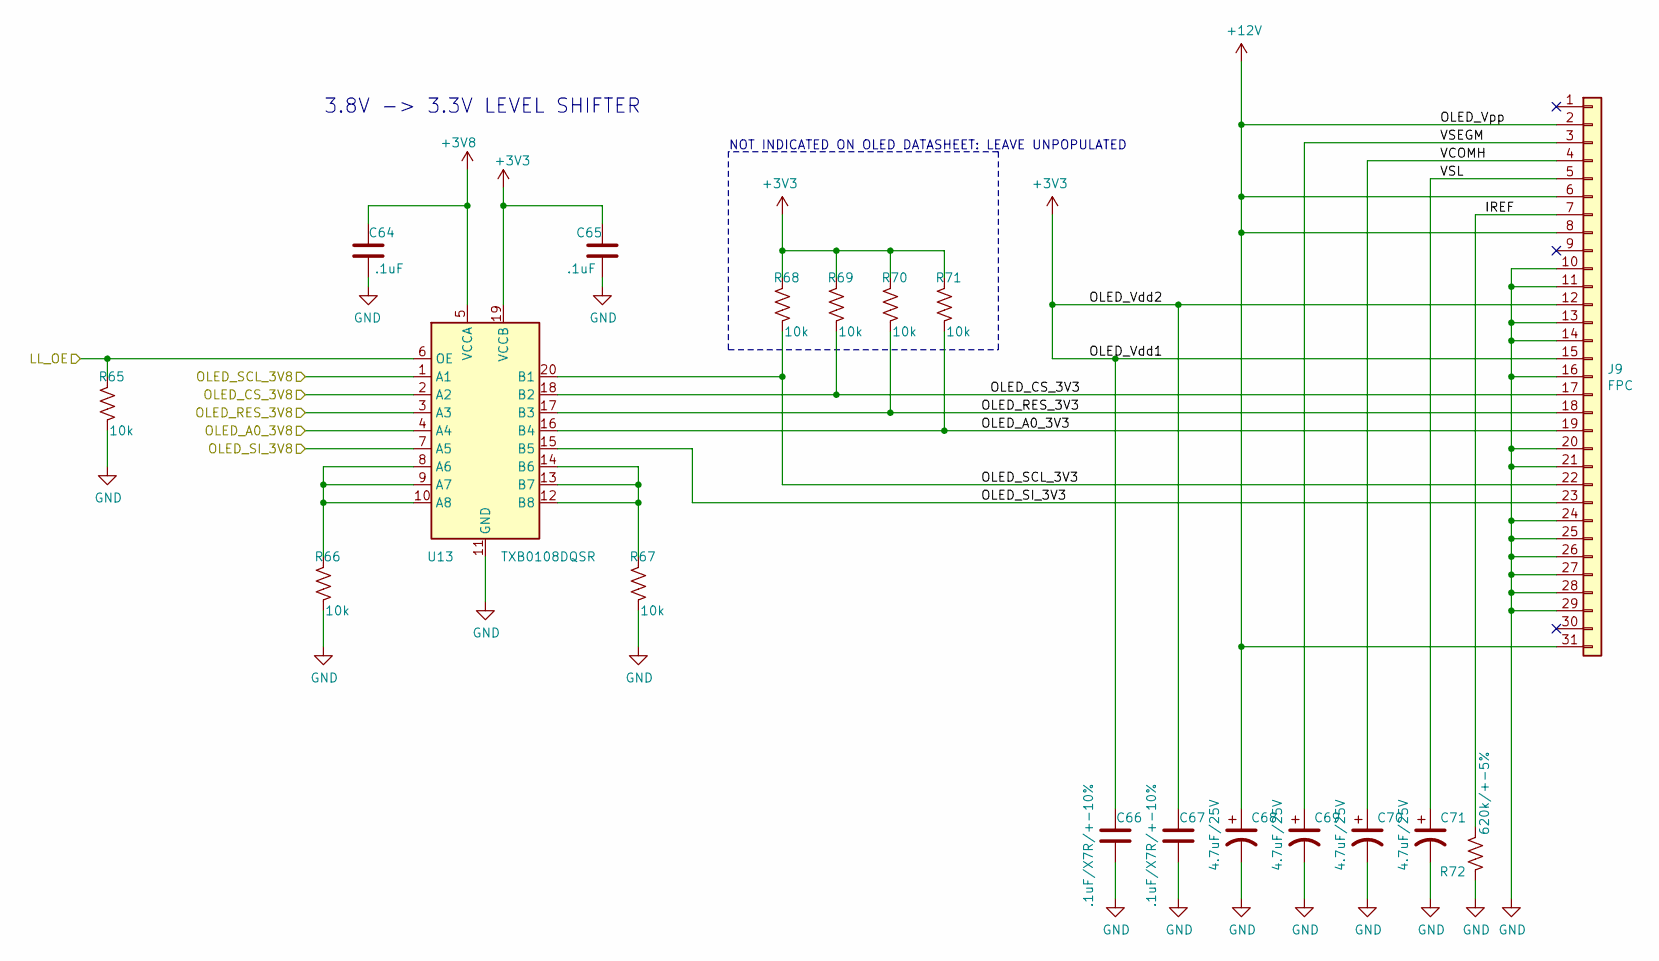
[picture p47: schematic OLEDDriver.sch, RCP OLED DRIVER]

Parts:
C64, C65: .1uF; C_0402_1005Metric
C66, C67: .1uF/X7R/+-10%; C_0603_1608Metric
C68, C69, C70, C71: 4.7uF/25V; CP_Elec_4x4.5; Mfg. Part No. 865080540002
J9: FPC; Hirose_FPC_FH26W-31S-0.3SHW(60); Mfg. Part No. FH26W-31S-0.3SHW(60)
R65, R66, R67, R68, R69, R70, R71: 10k; R_0402_1005Metric
R72: 620k/+-5%; R_0603_1608Metric_Pad1.05x0.95mm_HandSolder
U13: TXB0108DQSR; USON-20_2x4mm_P0.4mm

Connections:
+3V3: C65.1, C66.1, C67.1, J9.12, J9.15, R68.1, R69.1, R70.1, R71.1, U13.19 (VCCB); also elsewhere on the board
+3V8: C64.1, U13.5 (VCCA); also elsewhere on the board
+12V: C68.1, J9.2, J9.6, J9.8, J9.31; also elsewhere on the board
/MOSI: U13.7 (A5); also elsewhere on the board
/OLED DRIVER/IREF: J9.7, R72.1
/OLED DRIVER/OLED_A0_3V3: J9.19, R71.2, U13.16 (B4)
/OLED DRIVER/OLED_CS_3V3: J9.17, R69.2, U13.18 (B2)
/OLED DRIVER/OLED_RES_3V3: J9.18, R70.2, U13.17 (B3)
/OLED DRIVER/OLED_SCL_3V3: J9.22, R68.2, U13.20 (B1)
/OLED DRIVER/OLED_SI_3V3: J9.23, U13.15 (B5)
/OLED DRIVER/VCOMH: C70.1, J9.4
/OLED DRIVER/VSEGM: C69.1, J9.3
/OLED DRIVER/VSL: C71.1, J9.5
/OLED_AO: U13.4 (A4); also elsewhere on the board
/OLED_CS: U13.2 (A2); also elsewhere on the board
/OLED_XRES: U13.3 (A3); also elsewhere on the board
/SCK: U13.1 (A1); also elsewhere on the board
GND: C64.2, C65.2, C66.2, C67.2, C68.2, C69.2, C70.2, C71.2, J9.10, J9.11, J9.13, J9.14, J9.16, J9.20, J9.21, J9.24, J9.25, J9.26, J9.27, J9.28, J9.29, R65.2, R66.2, R67.2, R72.2, U13.11 (GND); also elsewhere on the board
LL_OE: R65.1, U13.6 (OE); also elsewhere on the board
unnamed: R66.1, U13.8 (A6), U13.9 (A7), U13.10 (A8)
unnamed: R67.1, U13.12 (B8), U13.13 (B7), U13.14 (B6)

Notes on the sheet:
3.8V -> 3.3V LEVEL SHIFTER
NOT INDICATED ON OLED DATASHEET: LEAVE UNPOPULATED

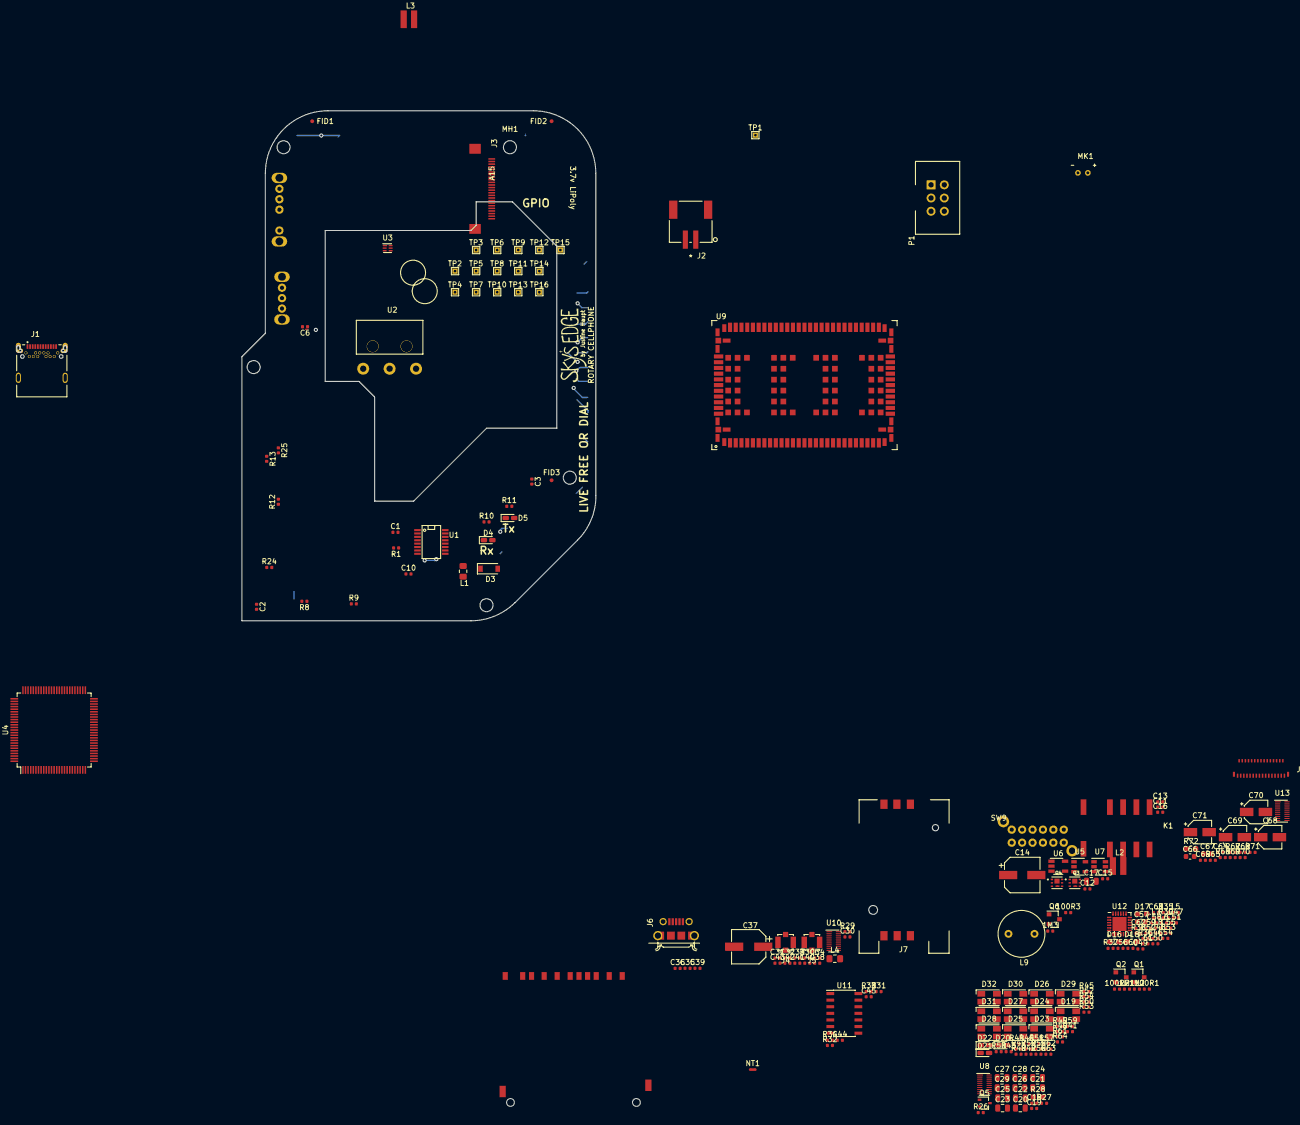
[picture p48: board RotaryCellPhone-4G.kicad_pcb from above]

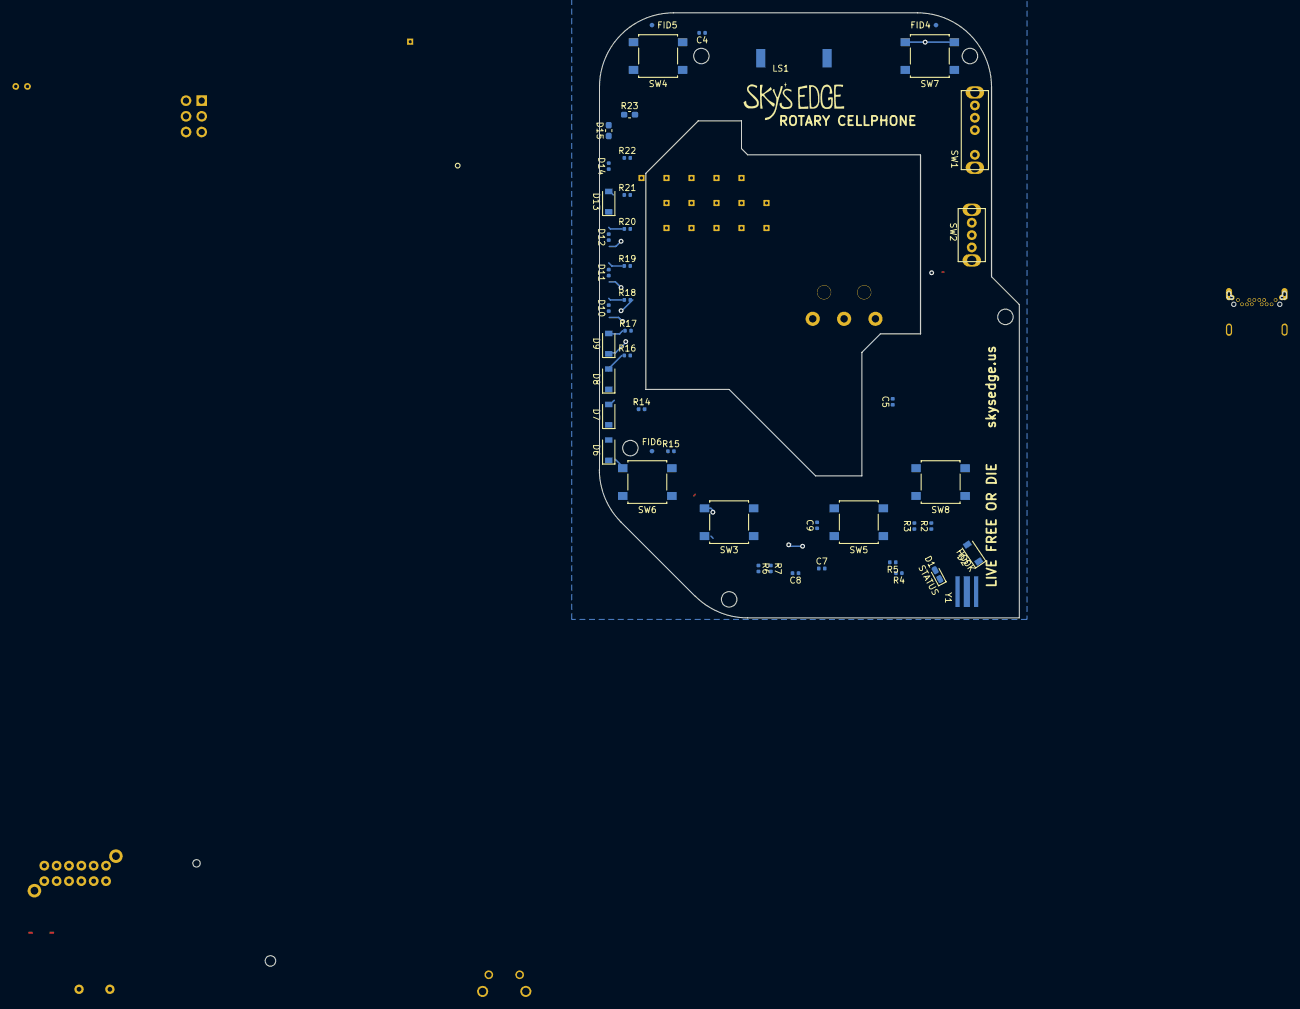
[picture p49: board RotaryCellPhone-4G.kicad_pcb from below]

Board: 4 copper layers, 262 parts (47 on the bottom side), 225 nets.

Other parts of the board:
D23, D24, D25, D26, D27, D28, D29, D30, D31, D32: R/Y; LED_Avago_PLCC4_3.2x2.8mm_CW
J8: SDCard; SDCardSocket_Amph_10067847-001RLF

Their connections:
+3V3: J8.4; also elsewhere on the board
/SD CARD/CS_3V3: J8.1; also elsewhere on the board
/SD CARD/DI_3V3: J8.2; also elsewhere on the board
/SD CARD/DO_3V3: J8.7; also elsewhere on the board
/SD CARD/SCK_3V3: J8.5; also elsewhere on the board
/SD_CD: J8.10; also elsewhere on the board
GND: D23.2, D23.4, D24.2, D24.4, D25.2, D25.4, D26.2, D26.4, D27.2, D27.4, D28.2, D28.4, D29.2, D29.4, D30.2, D30.4, D31.2, D31.4, D32.2, D32.4, J8.3, J8.6, J8.12, J8.13; also elsewhere on the board
unnamed 167: D23.1; also elsewhere on the board
unnamed 168: D23.3; also elsewhere on the board
unnamed 169: D24.1; also elsewhere on the board
unnamed 170: D24.3; also elsewhere on the board
unnamed 171: D25.1; also elsewhere on the board
unnamed 172: D25.3; also elsewhere on the board
unnamed 173: D26.1; also elsewhere on the board
unnamed 174: D26.3; also elsewhere on the board
unnamed 175: D27.1; also elsewhere on the board
unnamed 176: D27.3; also elsewhere on the board
unnamed 177: D28.1; also elsewhere on the board
unnamed 178: D28.3; also elsewhere on the board
unnamed 179: D29.1; also elsewhere on the board
unnamed 180: D29.3; also elsewhere on the board
unnamed 181: D30.1; also elsewhere on the board
unnamed 182: D30.3; also elsewhere on the board
unnamed 183: D31.1; also elsewhere on the board
unnamed 184: D31.3; also elsewhere on the board
unnamed 185: D32.1; also elsewhere on the board
unnamed 186: D32.3; also elsewhere on the board
unnamed 189: J8.8; also elsewhere on the board
unnamed 190: J8.9; also elsewhere on the board
