skysedge/RUST_Hardware/Motherboard/bak/ePaperDriver.sch

## KiCad design Motherboard/bak/ePaperDriver.sch (2024-06-24)

Schematic: ePaperDriver.sch

Parts:
C18, C19: .1uF; C_0402_1005Metric
C20, C21, C22: 4.7uF/25V; C_0805_2012Metric
C23, C24, C25, C26, C27, C28, C29: 1uF/50V; C_0805_2012Metric
D7, D8, D9: MBR0530; D_SOD-123; Mfg. Part No. MBR0530
J1: FPC; Hirose_FPC_TF31-24S-0.5SH(800); Mfg. Part No. TF31-24S-0.5SH(800)
L3: 10uH; Inductor_Wurth_74438336100
Q5: NMOS; SOT-323_SC-70; Mfg. Part No. SI1308EDL-T1-GE3
R23: 10k; R_0603_1608Metric_Pad1.05x0.95mm_HandSolder
R24, R25: 100k; R_0402_1005Metric
R26, R27: 10k; R_0402_1005Metric
R28: 0.47R; R_0603_1608Metric_Pad1.05x0.95mm_HandSolder
U8: TXB0108DQSR; USON-20_2x4mm_P0.4mm

Notes on the sheet:
3.8V -> 3.3V LEVEL SHIFTER
