skysedge/RUST_Hardware/(commit log)

2024-06-24 initial commit to github
    [4GRCP_Mainboard-B_Adhes.gbr, 4GRCP_Mainboard-B_Fab.gbr, 4GRCP_Mainboard-B_Mask.gbr, 4GRCP_Mainboard-B_Paste.gbr, 4GRCP_Mainboard-B_SilkS.gbr, 4GRCP_Mainboard-Edge_Cuts.gbr, 4GRCP_Mainboard-F_Adhes.gbr, 4GRCP_Mainboard-F_Fab.gbr]
2025-03-03 removed TestBoard from this repo
    [RUSP_TestBoard-1_Top_Cu.gbr, RUSP_TestBoard-2_Bottom_Cu.gbr, RUSP_TestBoard-B_Fab.gbr, RUSP_TestBoard-B_Mask.gbr, RUSP_TestBoard-B_Paste.gbr, RUSP_TestBoard-B_Silkscreen.gbr, RUSP_TestBoard-Edge_Cuts.gbr, RUSP_TestBoard-F_Fab.gbr]
2025-03-03 renamed project
    [AudioCODEC.kicad_sch, AudioCODEC.sch, BOM_RUSP_Mainboard.ods, Bell.kicad_sch, Bell.sch, BoostCircuit.sch, CellTranceiver.kicad_sch, CellTranceiver.sch]
2025-03-03 changed file names
    [AudioCODEC.kicad_sch, Bell.kicad_sch, CellTranceiver.kicad_sch, LEDIndicators.kicad_sch, OLEDDriver.kicad_sch, PowerManagement.kicad_sch, RUSP_Mainboard2.csv, RUSP_Mainboard_May2024.csv]
2025-03-04 updated naming convention
    [BOM_RUSP_Daughterboard.ods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]
2025-03-04 removed old DB dir
    [BOM_RUSP_Daughterboard.ods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]
2025-03-04 fixed naming conventions
    [BOM_RUSP_Faceplate.ods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]
2025-03-04 changed name of backups folder to old
    [4GRCP_Mainboard-B_Adhes.gbr, 4GRCP_Mainboard-B_Fab.gbr, 4GRCP_Mainboard-B_Mask.gbr, 4GRCP_Mainboard-B_Paste.gbr, 4GRCP_Mainboard-B_SilkS.gbr, 4GRCP_Mainboard-Edge_Cuts.gbr, 4GRCP_Mainboard-F_Adhes.gbr, 4GRCP_Mainboard-F_Fab.gbr]
2025-03-04 fixed part no.s for availability
    [BOM_RUSP_Faceplate.ods, RUSP_Antenna_May2024.csv, RUSP_Faceplate_May2024.csv, RUST_Antenna.kicad_sch, RUST_Daughterboard.kicad_pcb, RUST_Daughterboard.kicad_sch, RUST_Dialboard.kicad_pcb, RUST_Dialboard.kicad_sch]
2025-03-04 made changes
    [RUST_Motherboard.kicad_sch]
2025-03-16 for phase 1 prod
    [BOM_RUSP_Daughterboard.ods, BOM_RUSP_Mainboard.ods, CellTranceiver.kicad_sch, RUST_Antenna.csv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]
